bjorend/pertexus/teensy4_1_pin_assignments.xlsx

Sheet: TeensyPinAssignments
Teensy 4.1 I/Os
MIMXRT1062CVJ6B |  |  |  | Schematic | External Pin
Pin | Pinname (Pad) | GPIO Group | Number | Netname | Connector | Pin # | Arduino Pin | Presumed Port | Presumed Mode | My Design | PertecPin | PertecGroup
F1 | GPIO_EMC_22 | 4 | 22 | EMC_22 | FLASH | 1 (CS) | 51 | FLEXSPI2_A_SS1_B | ALT8
 |  |  |  |  | IOExpander | 0 |  |  |  | IDENT | P2:16 | IN4b
 |  |  |  |  | IOExpander | 1 |  |  |  | IRWD | P2:30 | IN4b
 |  |  |  |  | IOExpander | 2 |  |  |  | ISPEED | P2:40 | IN4b
 |  |  |  |  | IOExpander | 3 |  |  |  | INRZ | P2:26 | IN5b
 |  |  |  |  | IOExpander | 4 |  |  |  | ITAD0 | P1:46 | OUT3a
 |  |  |  |  | IOExpander | 5 |  |  |  | IFEN | P2:18 | OUT3a
 |  |  |  |  | IOExpander | 6 |  |  |  | ITAD1 | P2:46 | OUT3a
 |  |  |  |  | IOExpander | 7 |  |  |  | IFAD | P2:48 | OUT3a
 |  |  |  |  | IOExpander | 8 |  |  |  | IDEN | P2:50 | OUT3a
 |  |  |  |  | IOExpander | 9 |  |  |  | ISGL | P1:14 | UDFB
 |  |  |  |  | IOExpander | 10 |  |  |  | ILOL | P1:16 | UDFO
 |  |  |  |  | IOExpander | 11 |  |  |  | IRTH2 | P1:36 | UDFO
 |  |  |  |  | IOExpander | 12 |  |  |  | IRTH1 | P1:44 | UDFO
 |  |  |  |  | IOExpander | 13 |  |  |  | IONL | P2:44 | IN5a
 |  |  |  |  | IOExpander | 14 |  |  |  | ILDP | P2:4 | IN5a
 |  |  |  |  | IOExpander | 15 |  |  |  | IFPT | P2:32 | IN5a
M8 | USB_OTG1_DN |  |  | USB1_DN | J1 (USB) | 2
L8 | USB_OTG1_DP |  |  | USB1_DP | J1 (USB) | 3
H2 | GPIO_SD_B0_04 | 3 | 16 | SD_B0_04 | J2 (SD Card) | 1 (DAT2) | 47 | USDHC1_DATA2 | ALT0
J2 | GPIO_SD_B0_05 | 3 | 17 | SD_B0_05 | J2 (SD Card) | 2 (DAT3) | 46 | USDHC1_DATA3 | ALT0
J4 | GPIO_SD_B0_00 | 3 | 12 | SD_B0_00 | J2 (SD Card) | 3 (CMD) | 45 | USDHC1_CMD | ALT0
J3 | GPIO_SD_B0_01 | 3 | 13 | SD_B0_01 | J2 (SD Card) | 5 (CLK) | 44 | USDHC1_CLK | ALT0
J1 | GPIO_SD_B0_02 | 3 | 14 | SD_B0_02 | J2 (SD Card) | 7 (DAT0) | 43 | USDHC1_DATA0 | ALT0
K1 | GPIO_SD_B0_03 | 3 | 15 | SD_B0_03 | J2 (SD Card) | 8 (DAT1) | 42 | USDHC1_DATA1 | ALT0
 |  |  |  | ETHERNET_T- | J3 (Ethernet header) | 1
 |  |  |  | ETHERNET_T+ | J3 (Ethernet header) | 2
 |  |  |  | ETHERNET_LED | J3 (Ethernet header) | 3
 |  |  |  | ETHERNET_G | J3 (Ethernet header) | 4
 |  |  |  | ETHERNET_R+ | J3 (Ethernet header) | 5
 |  |  |  | ETHERNET_R- | J3 (Ethernet header) | 6
M13 | GPIO_AD_B1_09 | 1 | 25 | AD_B1_09 | J4 | 4 | 23 |  |  | IW6 | P1:28 | OUT1a
H13 | GPIO_AD_B1_08 | 1 | 24 | AD_B1_08 | J4 | 5 | 22 |  |  | IW7 | P1:24 | OUT1a
J13 | GPIO_AD_B1_11 | 1 | 27 | AD_B1_11 | J4 | 6 | 21 |  |  | IW4 | P1:6 | OUT1a
L13 | GPIO_AD_B1_10 | 1 | 26 | AD_B1_10 | J4 | 7 | 20 |  |  | IW5 | P1:32 | OUT1a
J11 | GPIO_AD_B1_00 | 1 | 16 | AD_B1_00 | J4 | 8 | 19 |  |  | IR7 | P2:8 | IN2a
K11 | GPIO_AD_B1_01 | 1 | 17 | AD_B1_01 | J4 | 9 | 18 |  |  | IR6 | P2:10 | IN2a
J12 | GPIO_AD_B1_06 | 1 | 22 | AD_B1_06 | J4 | 10 | 17 |  |  | IR1 | P2:3 | IN2a
K10 | GPIO_AD_B1_07 | 1 | 23 | AD_B1_07 | J4 | 11 | 16 |  |  | IR0 | P2:2 | IN2a
M12 | GPIO_AD_B1_03 | 1 | 19 | AD_B1_03 | J4 | 12 | 15 |  |  | IR4 | P2:6 | IN2a
L11 | GPIO_AD_B1_02 | 1 | 18 | AD_B1_02 | J4 | 13 | 14 |  |  | IR5 | P2:20 | IN2a
D8 | GPIO_B0_03 | 2 | 3 | B0_03 | J4 | 14 | 13 |  |  | ILWD | P1:4 | OUT1a
K12 | GPIO_AD_B1_05 | 1 | 21 | AD_B1_05 | J4 | 16 | 41 |  |  | IR2 | P1:48 | IN2a
L12 | GPIO_AD_B1_04 | 1 | 20 | AD_B1_04 | J4 | 17 | 40 |  |  | IR3 | P1:50 | IN2a
H11 | GPIO_AD_B1_13 | 1 | 29 | AD_B1_13 | J4 | 18 | 39 |  |  | IW2 | P1:30 | OUT1a
H12 | GPIO_AD_B1_12 | 1 | 28 | AD_B1_12 | J4 | 19 | 38 |  |  | IW3 | P1:26 | OUT1a
D11 | GPIO_B1_03 | 2 | 19 | B1_03 | J4 | 20 | 37 |  |  | IWSTR | P2:36 | IN1a
C11 | GPIO_B1_02 | 2 | 18 | B1_02 | J4 | 21 | 36 |  |  | IRSTR | P2:34 | IN1a
D13 | GPIO_B1_12 | 2 | 28 | B1_12 | J4 | 22 | 35 |  |  | IHER | P2:12 | IN2a
D14 | GPIO_B1_13 | 2 | 29 | B1_13 | J4 | 23 | 34 |  |  | ICER | P2:42 | IN2a
H4 | GPIO_EMC_07 | 4 | 7 | EMC_07 | J4 | 24 | 33 |  |  | IFBY | P1:2 | IN3a
G11 | GPIO_AD_B0_03 | 1 | 3 | AD_B0_03 | J5 | 2 | 0 |  |  | IFMK | P2:14 | IN3a
M11 | GPIO_AD_B0_02 | 1 | 2 | AD_B0_02 | J5 | 3 | 1 |  |  | IRP | P2:1 | IN2b
F2 | GPIO_EMC_04 | 4 | 4 | EMC_04 | J5 | 4 | 2 |  |  | IRDY | P2:28 | IN4a
G5 | GPIO_EMC_05 | 4 | 5 | EMC_05 | J5 | 5 | 3 |  |  | DIRA
H5 | GPIO_EMC_06 | 4 | 6 | EMC_06 | J5 | 6 | 4 |  |  | IDBY | P2:38 | IN3a
H3 | GPIO_EMC_08 | 4 | 8 | EMC_08 | J5 | 7 | 5 |  |  | LPI2C4_INT
D9 | GPIO_B0_10 | 2 | 10 | B0_10 | J5 | 8 | 6 |  |  | IGO | P1:8 | OUT2a
B11 | GPIO_B1_01 | 2 | 17 | B1_01 | J5 | 9 | 7 |  |  | IWP | P1:22 | OUT1b
A11 | GPIO_B1_00 | 2 | 16 | B1_00 | J5 | 10 | 8 |  |  | IREW | P1:20 | OUT2a
A10 | GPIO_B0_11 | 2 | 11 | B0_11 | J5 | 11 | 9 |  |  | IREV | P1:18 | OUT2a
D7 | GPIO_B0_00 | 2 | 0 | B0_00 | J5 | 12 | 10 |  |  | IWRT | P1:34 | OUT2a
E8 | GPIO_B0_02 | 2 | 2 | B0_02 | J5 | 13 | 11 |  |  | IEDIT | P1:38 | OUT2a
E7 | GPIO_B0_01 | 2 | 1 | B0_01 | J5 | 14 | 12 |  |  | IERASE | P1:40 | OUT2a
K14 | GPIO_AD_B0_12 | 1 | 12 | AD_B0_12 | J5 | 16 | 24 |  |  | LPI2C4_SCL
L14 | GPIO_AD_B0_13 | 1 | 13 | AD_B0_13 | J5 | 17 | 25 |  |  | LPI2C4_SDA
G12 | GPIO_AD_B1_14 | 1 | 30 | AD_B1_14 | J5 | 18 | 26 |  |  | IW1 | P1:12 | OUT1a
J14 | GPIO_AD_B1_15 | 1 | 31 | AD_B1_15 | J5 | 19 | 27 |  |  | IW0 | P1:10 | OUT1a
D5 | GPIO_EMC_32 | 3 | 18 | EMC_32 | J5 | 20 | 28 |  |  | DIRB
C5 | GPIO_EMC_31 | 4 | 31 | EMC_31 | J5 | 21 | 29 |  |  | OEA
E4 | GPIO_EMC_37 | 3 | 23 | EMC_37 | J5 | 22 | 30 |  |  | IOFL | P2:24 | OUT2a
C3 | GPIO_EMC_36 | 3 | 22 | EMC_36 | J5 | 23 | 31 |  |  | IEOT | P2:22 | IN3a
C10 | GPIO_B0_12 | 2 | 12 | B0_12 | J5 | 24 | 32 |  |  | IWFM | P1:42 | OUT2a
D3 | GPIO_EMC_24 | 4 | 24 | EMC_24 | PSRAM | 1 (CS) | 48 | FLEXSPI2_A_SS0_B | ALT8
A2 | GPIO_EMC_27 | 4 | 27 | EMC_27 | PSRAM/FLASH | 2 (D1) | 49 | FLEXSPI2_A_DATA1 | ALT8
D1 | GPIO_EMC_28 | 4 | 28 | EMC_28 | PSRAM/FLASH | 3 (D2) | 50 | FLEXSPI2_A_DATA2 | ALT8
B3 | GPIO_EMC_26 | 4 | 26 | EMC_26 | PSRAM/FLASH | 5 (D0) | 52 | FLEXSPI2_A_DATA0 | ALT8
D2 | GPIO_EMC_25 | 4 | 25 | EMC_25 | PSRAM/FLASH | 6 (CLK) | 53 | FLEXSPI2_A_SCLK | ALT8
E1 | GPIO_EMC_29 | 4 | 29 | EMC_29 | PSRAM/FLASH | 7 (D3) | 54 | FLEXSPI2_A_DATA3 | ALT8
D10 | GPIO_B0_13 | 2 | 13 | B0_13 | U2 (Boot) | 12 (PTB4)
F13 | GPIO_AD_B0_08 |  |  | AD_B0_08 | U2 (Boot) | 13 (PTB5) |  | JTAG_MOD | ALT0
F3 | GPIO_EMC_01 | 4 | 1 | EMC_01 | U2 (Boot) | 15 (PTA1) |  | JTAG_DE_B | ALT7
K3 | DCDC_PSWITCH |  |  | DCDC_PSWITCH | U2 (Boot) | 3 (PTA3)
G10 | GPIO_AD_B0_11 |  |  | AD_B0_11 | U2 (Boot) | 3 (PTA3) |  | JTAG_TRSTB | ALT0
F11 | GPIO_AD_B0_04 |  |  | AD_B0_04 | U2 (Boot) | 4 (PTA4) |  | SRC_BOOT_MODE0 | ALT0
E14 | GPIO_AD_B0_06 |  |  | AD_B0_06 | U2 (Boot) | 5 (PTA5 |  | JTAG_TMS | ALT0
G13 | GPIO_AD_B0_10 |  |  | AD_B0_10 | U2 (Boot) | 6 (PTA6) |  | JTAG_TDO | ALT0
F14 | GPIO_AD_B0_09 |  |  | AD_B0_09 | U2 (Boot) | 7 (PTA7) |  | JTAG_TDI | ALT0
F12 | GPIO_AD_B0_07 |  |  | AD_B0_07 | U2 (Boot) | 8 (PTB0) |  | JTAG_TCK | ALT0
M7 | POR_B |  |  | POR_B | U2 (Boot) | 9 (PTB1) |  | SRC_POR_B | ALT0
L3 | GPIO_SD_B1_06 | 3 | 6 | SD_B1_06 | U3 (SPI Flash) | 1 (CS) |  | FLEXSPI_A_SS0_B | ALT1
N4 | GPIO_SD_B1_09 | 3 | 9 | SD_B1_09 | U3 (SPI Flash) | 2 (D1) |  | FLEXSPI_A_DATA1 | ALT1
P4 | GPIO_SD_B1_10 | 3 | 1 | SD_B1_10 | U3 (SPI Flash) | 3 (D2) |  | FLEXSPI_A_DATA2 | ALT1
P3 | GPIO_SD_B1_08 | 3 | 8 | SD_B1_08 | U3 (SPI Flash) | 5 (D0) |  | FLEXSPI_A_DATA0 | ALT1
L4 | GPIO_SD_B1_07 | 3 | 7 | SD_B1_07 | U3 (SPI Flash) | 6 (CLK) |  | FLEXSPI_A_SCLK | ALT1
P5 | GPIO_SD_B1_11 | 3 | 11 | SD_B1_11 | U3 (SPI Flash) | 7 (D3) |  | FLEXSPI_A_DATA3 | ALT1
A13 | GPIO_B1_09 | 2 | 25 | B1_09 | U6 (Ethernet PHY) | 1 (TXEN) |  | ENET_TX_EN | ALT3
B13 | GPIO_B1_10 | 2 | 26 | B1_10 | U6 (Ethernet PHY) | 13 (XI) |  | ENET_TX_CLK | ALT3
B14 | GPIO_B1_15 | 2 | 31 | B1_15 | U6 (Ethernet PHY) | 15 (MDIO) |  | ENET_MDIO | ALT0
C14 | GPIO_B1_14 | 2 | 30 | B1_14 | U6 (Ethernet PHY) | 16 (MDC) |  | ENET_MDC | ALT0
D12 | GPIO_B1_05 | 2 | 21 | B1_05 | U6 (Ethernet PHY) | 17 (RXD1) |  | ENET_RX_DATA1 | ALT3
E12 | GPIO_B1_04 | 2 | 20 | B1_04 | U6 (Ethernet PHY) | 18 (RXD0) |  | ENET_RX_DATA0 | ALT3
C12 | GPIO_B1_06 | 2 | 22 | B1_06 | U6 (Ethernet PHY) | 20 (DV) |  | ENET_RX_EN | ALT3
C13 | GPIO_B1_11 | 2 | 27 | B1_11 | U6 (Ethernet PHY) | 22 (RXER) |  | ENET_RX_ER | ALT3
B12 | GPIO_B1_07 | 2 | 23 | B1_07 | U6 (Ethernet PHY) | 23 (TXD0) |  | ENET_TX_DATA0 | ALT3
A12 | GPIO_B1_08 | 2 | 24 | B1_08 | U6 (Ethernet PHY) | 24 (TXD1) |  | ENET_TX_DATA1 | ALT3
E11 | GPIO_B0_15 | 2 | 15 | B0_15 | U6 (Ethernet PHY) | 3 (INT)
E10 | GPIO_B0_14 | 2 | 14 | B0_14 | U6 (Ethernet PHY) | 5 (RST)
M14 | GPIO_AD_B0_00 | 1 | 0 | AD_B0_00
A7 | GPIO_EMC_40 | 3 | 26 | EMC_40
N1 | DCDC_GND |  |  | DCDC_GND
N2 | DCDC_GND |  |  | DCDC_GND
L1 | DCDC_IN |  |  | DCDC_IN
L2 | DCDC_IN |  |  | DCDC_IN
K4 | DCDC_IN_Q |  |  | NVCC_GPIO
M1 | DCDC_LP |  |  | DCDC_LP
M2 | DCDC_LP |  |  | DCDC_LP
J5 | DCDC_SENSE |  |  | VDD_SOC_IN
G14 | GPIO_AD_B0_05 |  |  | AD_B0_05
K9 | NGND_KEL0 |  |  | NGND_KEL0
E6 | NVCC_EMC |  |  | NVCC_GPIO
F5 | NVCC_EMC |  |  | NVCC_GPIO
E9 | NVCC_GPIO |  |  | NVCC_GPIO
F10 | NVCC_GPIO |  |  | NVCC_GPIO
J10 | NVCC_GPIO |  |  | NVCC_GPIO
P10 | NVCC_PLL |  |  | NVCC_PLL
J6 | NVCC_SD0 |  |  | NVCC_GPIO
K5 | NVCC_SD1 |  |  | NVCC_GPIO
M6 | ONOFF |  |  | ONOFF
K7 | PMIC_ON_REQ |  |  | PMIC_ON_REQ
N9 | RTC_XTALI |  |  | RTC_XTALI
P9 | RTC_XTALO |  |  | RTC_XTALO
N6 | USB_OTG1_VBUS |  |  | USB1_VBUS
N7 | USB_OTG2_DN |  |  | USB2_DN
P7 | USB_OTG2_DP |  |  | USB2_DP
P6 | USB_OTG2_VBUS |  |  | USB2_VBUS
P8 | VDD_HIGH_CAP |  |  | VDD_HIGH_CAP
P12 | VDD_HIGH_IN |  |  | VDD_HIGH_IN
M10 | VDD_SNVS_CAP |  |  | VDD_SNVS_CAP
M9 | VDD_SNVS_IN |  |  | VDD_SNVS_IN
F6 | VDD_SOC_IN |  |  | VDD_SOC_IN
F7 | VDD_SOC_IN |  |  | VDD_SOC_IN
F8 | VDD_SOC_IN |  |  | VDD_SOC_IN
F9 | VDD_SOC_IN |  |  | VDD_SOC_IN
G6 | VDD_SOC_IN |  |  | VDD_SOC_IN
G9 | VDD_SOC_IN |  |  | VDD_SOC_IN
H6 | VDD_SOC_IN |  |  | VDD_SOC_IN
H9 | VDD_SOC_IN |  |  | VDD_SOC_IN
J9 | VDD_SOC_IN |  |  | VDD_SOC_IN
K8 | VDD_USB_CAP |  |  | VCC_USB_CAP
N14 | VDDA_ADC_3P3 |  |  | VDD_ADC
A1 | VSS |  |  | VSS
A14 | VSS |  |  | VSS
B10 | VSS |  |  | VSS
B5 | VSS |  |  | VSS
E13 | VSS |  |  | VSS
E2 | VSS |  |  | VSS
G7 | VSS |  |  | VSS
G8 | VSS |  |  | VSS
H7 | VSS |  |  | VSS
H8 | VSS |  |  | VSS
J7 | VSS |  |  | VSS
J8 | VSS |  |  | VSS
K13 | VSS |  |  | VSS
K2 | VSS |  |  | VSS
L9 | VSS |  |  | VSS
N5 | VSS |  |  | VSS
N8 | VSS |  |  | VSS
P1 | VSS |  |  | VSS
P14 | VSS |  |  | VSS
P11 | XTALI |  |  | XTALI
N11 | XTALO |  |  | XTALO

Sheet: CPUPinAssignments
IMXRT1060 pin assignments
from i.MX RT1060 Crossover Processors for Consumer Products
NXP Semiconductors Data Sheet: Technical Data
Document Number: IMXRT1060CEC, Rev. 0.1, 04.2019
https://www.pjrc.com/teensy/IMXRT1060CEC_rev0_1.pdf
pp. 100-107, section 6.2.2 "12 x 12 mm supplies contact assignments and functional contact assignments", table 86 "12 x 12 mm supplies contact assignment" |  |  |  |  |  |  |  |  |  | B11 | GPIO_B1_01
 |  |  |  | Default Setting |  |  |  | GPIO
Ball Name | 12 x 12 Ball | Power Group | Ball Type | Default Mode | Default Function | Input/Output | Value | Group | Number
CCM_CLK1_N | P13 | — | — | — | CCM_CLK1_N | — | —
CCM_CLK1_P | N13 | — | — | — | CCM_CLK1_P | — | —
DCDC_GND | N1 | — | — | — | — | — | —
DCDC_GND | N2 | — | — | — | — | — | —
DCDC_IN | L1 | — | — | — | — | — | —
DCDC_IN | L2 | — | — | — | — | — | —
DCDC_IN_Q | K4 | — | — | — | — | — | —
DCDC_LP | M1 | — | — | — | — | — | —
DCDC_LP | M2 | — | — | — | — | — | —
DCDC_PSWITCH | K3 | — | — | — | — | — | —
DCDC_SENSE | J5 | — | — | — | — | — | —
GPANAIO | N10 | — | — | — | — | — | —
GPIO_AD_B0_00 | M14 | NVCC_GPIO | Digital GPIO | ALT5 | GPIO1.IO[0] | Input | Keeper | 1 | 0
GPIO_AD_B0_01 | H10 | NVCC_GPIO | Digital GPIO | ALT5 | GPIO1.IO[1] | Input | Keeper | 1 | 1
GPIO_AD_B0_02 | M11 | NVCC_GPIO | Digital GPIO | ALT5 | GPIO1.IO[2] | Input | Keeper | 1 | 2
GPIO_AD_B0_03 | G11 | NVCC_GPIO | Digital GPIO | ALT5 | GPIO1.IO[3] | Input | Keeper | 1 | 3
GPIO_AD_B0_04 | F11 | NVCC_GPIO | Digital GPIO | ALT0 | SRC.BOOT.MODE[0] | Input | 100 K PD
GPIO_AD_B0_05 | G14 | NVCC_GPIO | Digital GPIO | ALT0 | SRC.BOOT.MODE[1] | Input | 100 K PD
GPIO_AD_B0_06 | E14 | NVCC_GPIO | Digital GPIO | ALT0 | JTAG.MUX.TMS | Input | 47 K PU
GPIO_AD_B0_07 | F12 | NVCC_GPIO | Digital GPIO | ALT0 | JTAG.MUX.TCK | Input | 47 K PU
GPIO_AD_B0_08 | F13 | NVCC_GPIO | Digital GPIO | ALT0 | JTAG.MUX.MOD | Input | 100 K PU
GPIO_AD_B0_09 | F14 | NVCC_GPIO | Digital GPIO | ALT0 | JTAG.MUX.TDI | Input | 47 K PU
GPIO_AD_B0_10 | G13 | NVCC_GPIO | Digital GPIO | ALT0 | JTAG.MUX.TDO | Input | Keeper
GPIO_AD_B0_11 | G10 | NVCC_GPIO | Digital GPIO | ALT0 | JTAG.MUX.TRSTB | Input | 47 K PU
GPIO_AD_B0_12 | K14 | NVCC_GPIO | Digital GPIO | ALT5 | GPIO1.IO[12] | Input | Keeper | 1 | 12
GPIO_AD_B0_13 | L14 | NVCC_GPIO | Digital GPIO | ALT5 | GPIO1.IO[13] | Input | Keeper | 1 | 13
GPIO_AD_B0_14 | H14 | NVCC_GPIO | Digital GPIO | ALT5 | GPIO1.IO[14] | Input | Keeper | 1 | 14
GPIO_AD_B0_15 | L10 | NVCC_GPIO | Digital GPIO | ALT5 | GPIO1.IO[15] | Input | Keeper | 1 | 15
GPIO_AD_B1_00 | J11 | NVCC_GPIO | Digital GPIO | ALT5 | GPIO1.IO[16] | Input | Keeper | 1 | 16
GPIO_AD_B1_01 | K11 | NVCC_GPIO | Digital GPIO | ALT5 | GPIO1.IO[17] | Input | Keeper | 1 | 17
GPIO_AD_B1_02 | L11 | NVCC_GPIO | Digital GPIO | ALT5 | GPIO1.IO[18] | Input | Keeper | 1 | 18
GPIO_AD_B1_03 | M12 | NVCC_GPIO | Digital GPIO | ALT5 | GPIO1.IO[19] | Input | Keeper | 1 | 19
GPIO_AD_B1_04 | L12 | NVCC_GPIO | Digital GPIO | ALT5 | GPIO1.IO[20] | Input | Keeper | 1 | 20
GPIO_AD_B1_05 | K12 | NVCC_GPIO | DigitalGPIO | ALT5 | GPIO1.IO[21] | Input | Keeper | 1 | 21
GPIO_AD_B1_06 | J12 | NVCC_GPIO | DigitalGPIO | ALT5 | GPIO1.IO[22] | Input | Keeper | 1 | 22
GPIO_AD_B1_07 | K10 | NVCC_GPIO | DigitalGPIO | ALT5 | GPIO1.IO[23] | Input | Keeper | 1 | 23
GPIO_AD_B1_08 | H13 | NVCC_GPIO | DigitalGPIO | ALT5 | GPIO1.IO[24] | Input | Keeper | 1 | 24
GPIO_AD_B1_09 | M13 | NVCC_GPIO | DigitalGPIO | ALT5 | GPIO1.IO[25] | Input | Keeper | 1 | 25
GPIO_AD_B1_10 | L13 | NVCC_GPIO | DigitalGPIO | ALT5 | GPIO1.IO[26] | Input | Keeper | 1 | 26
GPIO_AD_B1_11 | J13 | NVCC_GPIO | DigitalGPIO | ALT5 | GPIO1.IO[27] | Input | Keeper | 1 | 27
GPIO_AD_B1_12 | H12 | NVCC_GPIO | DigitalGPIO | ALT5 | GPIO1.IO[28] | Input | Keeper | 1 | 28
GPIO_AD_B1_13 | H11 | NVCC_GPIO | DigitalGPIO | ALT5 | GPIO1.IO[29] | Input | Keeper | 1 | 29
GPIO_AD_B1_14 | G12 | NVCC_GPIO | DigitalGPIO | ALT5 | GPIO1.IO[30] | Input | Keeper | 1 | 30
GPIO_AD_B1_15 | J14 | NVCC_GPIO | DigitalGPIO | ALT5 | GPIO1.IO[31] | Input | Keeper | 1 | 31
GPIO_B0_00 | D7 | NVCC_GPIO | DigitalGPIO | ALT5 | GPIO2.IO[0] | Input | Keeper | 2 | 0
GPIO_B0_01 | E7 | NVCC_GPIO | DigitalGPIO | ALT5 | GPIO2.IO[1] | Input | Keeper | 2 | 1
GPIO_B0_02 | E8 | NVCC_GPIO | DigitalGPIO | ALT5 | GPIO2.IO[2] | Input | Keeper | 2 | 2
GPIO_B0_03 | D8 | NVCC_GPIO | DigitalGPIO | ALT5 | GPIO2.IO[3] | Input | Keeper | 2 | 3
GPIO_B0_04 | C8 | NVCC_GPIO | DigitalGPIO | ALT5 | GPIO2.IO[4] | Input | Keeper | 2 | 4
GPIO_B0_05 | B8 | NVCC_GPIO | DigitalGPIO | ALT5 | GPIO2.IO[5] | Input | Keeper | 2 | 5
GPIO_B0_06 | A8 | NVCC_GPIO | DigitalGPIO | ALT5 | GPIO2.IO[6] | Input | Keeper | 2 | 6
GPIO_B0_07 | A9 | NVCC_GPIO | DigitalGPIO | ALT5 | GPIO2.IO[7] | Input | Keeper | 2 | 7
GPIO_B0_08 | B9 | NVCC_GPIO | DigitalGPIO | ALT5 | GPIO2.IO[8] | Input | Keeper | 2 | 8
GPIO_B0_09 | C9 | NVCC_GPIO | DigitalGPIO | ALT5 | GPIO2.IO[9] | Input | Keeper | 2 | 9
GPIO_B0_10 | D9 | NVCC_GPIO | Digital GPIO | ALT5 | GPIO2.IO[10] | Input | Keeper | 2 | 10
GPIO_B0_11 | A10 | NVCC_GPIO | Digital GPIO | ALT5 | GPIO2.IO[11] | Input | Keeper | 2 | 11
GPIO_B0_12 | C10 | NVCC_GPIO | Digital GPIO | ALT5 | GPIO2.IO[12] | Input | Keeper | 2 | 12
GPIO_B0_13 | D10 | NVCC_GPIO | Digital GPIO | ALT5 | GPIO2.IO[13] | Input | Keeper | 2 | 13
GPIO_B0_14 | E10 | NVCC_GPIO | Digital GPIO | ALT5 | GPIO2.IO[14] | Input | Keeper | 2 | 14
GPIO_B0_15 | E11 | NVCC_GPIO | Digital GPIO | ALT5 | GPIO2.IO[15] | Input | Keeper | 2 | 15
GPIO_B1_00 | A11 | NVCC_GPIO | Digital GPIO | ALT5 | GPIO2.IO[16] | Input | Keeper | 2 | 16
GPIO_B1_01 | B11 | NVCC_GPIO | Digital GPIO | ALT5 | GPIO2.IO[17] | Input | Keeper | 2 | 17
GPIO_B1_02 | C11 | NVCC_GPIO | Digital GPIO | ALT5 | GPIO2.IO[18] | Input | Keeper | 2 | 18
GPIO_B1_03 | D11 | NVCC_GPIO | Digital GPIO | ALT5 | GPIO2.IO[19] | Input | Keeper | 2 | 19
GPIO_B1_04 | E12 | NVCC_GPIO | Digital GPIO | ALT5 | GPIO2.IO[20] | Input | Keeper | 2 | 20
GPIO_B1_05 | D12 | NVCC_GPIO | Digital GPIO | ALT5 | GPIO2.IO[21] | Input | Keeper | 2 | 21
GPIO_B1_06 | C12 | NVCC_GPIO | Digital GPIO | ALT5 | GPIO2.IO[22] | Input | Keeper | 2 | 22
GPIO_B1_07 | B12 | NVCC_GPIO | Digital GPIO | ALT5 | GPIO2.IO[23] | Input | Keeper | 2 | 23
GPIO_B1_08 | A12 | NVCC_GPIO | Digital GPIO | ALT5 | GPIO2.IO[24] | Input | Keeper | 2 | 24
GPIO_B1_09 | A13 | NVCC_GPIO | Digital GPIO | ALT5 | GPIO2.IO[25] | Input | Keeper | 2 | 25
GPIO_B1_10 | B13 | NVCC_GPIO | Digital GPIO | ALT5 | GPIO2.IO[26] | Input | Keeper | 2 | 26
GPIO_B1_11 | C13 | NVCC_GPIO | Digital GPIO | ALT5 | GPIO2.IO[27] | Input | Keeper | 2 | 27
GPIO_B1_12 | D13 | NVCC_GPIO | Digital GPIO | ALT5 | GPIO2.IO[28] | Input | Keeper | 2 | 28
GPIO_B1_13 | D14 | NVCC_GPIO | Digital GPIO | ALT5 | GPIO2.IO[29] | Input | Keeper | 2 | 29
GPIO_B1_14 | C14 | NVCC_GPIO | Digital GPIO | ALT5 | GPIO2.IO[30] | Input | Keeper | 2 | 30
GPIO_B1_15 | B14 | NVCC_GPIO | Digital GPIO | ALT5 | GPIO2.IO[31] | Input | Keeper | 2 | 31
GPIO_EMC_00 | E3 | NVCC_EMC | Digital GPIO | ALT5 | GPIO4.IO[0] | Input | Keeper | 4 | 0
GPIO_EMC_01 | F3 | NVCC_EMC | Digital GPIO | ALT5 | GPIO4.IO[1] | Input | Keeper | 4 | 1
GPIO_EMC_02 | F4 | NVCC_EMC | Digital GPIO | ALT5 | GPIO4.IO[2] | Input | Keeper | 4 | 2
GPIO_EMC_03 | G4 | NVCC_EMC | Digital GPIO | ALT5 | GPIO4.IO[3] | Input | Keeper | 4 | 3
GPIO_EMC_04 | F2 | NVCC_EMC | Digital GPIO | ALT5 | GPIO4.IO[4] | Input | Keeper | 4 | 4
GPIO_EMC_05 | G5 | NVCC_EMC | Digital GPIO | ALT5 | GPIO4.IO[5] | Input | Keeper | 4 | 5
GPIO_EMC_06 | H5 | NVCC_EMC | Digital GPIO | ALT5 | GPIO4.IO[6] | Input | Keeper | 4 | 6
GPIO_EMC_07 | H4 | NVCC_EMC | Digital GPIO | ALT5 | GPIO4.IO[7] | Input | Keeper | 4 | 7
GPIO_EMC_08 | H3 | NVCC_EMC | Digital GPIO | ALT5 | GPIO4.IO[8] | Input | Keeper | 4 | 8
GPIO_EMC_09 | C2 | NVCC_EMC | Digital GPIO | ALT5 | GPIO4.IO[9] | Input | Keeper | 4 | 9
GPIO_EMC_10 | G1 | NVCC_EMC | Digital GPIO | ALT5 | GPIO4.IO[10] | Input | Keeper | 4 | 10
GPIO_EMC_11 | G3 | NVCC_EMC | Digital GPIO | ALT5 | GPIO4.IO[11] | Input | Keeper | 4 | 11
GPIO_EMC_12 | H1 | NVCC_EMC | Digital GPIO | ALT5 | GPIO4.IO[12] | Input | Keeper | 4 | 12
GPIO_EMC_13 | A6 | NVCC_EMC | Digital GPIO | ALT5 | GPIO4.IO[13] | Input | Keeper | 4 | 13
GPIO_EMC_14 | B6 | NVCC_EMC | Digital GPIO | ALT5 | GPIO4.IO[14] | Input | Keeper | 4 | 14
GPIO_EMC_15 | B1 | NVCC_EMC | Digital GPIO | ALT5 | GPIO4.IO[15] | Input | Keeper | 4 | 15
GPIO_EMC_16 | A5 | NVCC_EMC | Digital GPIO | ALT5 | GPIO4.IO[16] | Input | Keeper | 4 | 16
GPIO_EMC_17 | A4 | NVCC_EMC | Digital GPIO | ALT5 | GPIO4.IO[17] | Input | Keeper | 4 | 17
GPIO_EMC_18 | B2 | NVCC_EMC | Digital GPIO | ALT5 | GPIO4.IO[18] | Input | Keeper | 4 | 18
GPIO_EMC_19 | B4 | NVCC_EMC | Digital GPIO | ALT5 | GPIO4.IO[19] | Input | Keeper | 4 | 19
GPIO_EMC_20 | A3 | NVCC_EMC | Digital GPIO | ALT5 | GPIO4.IO[20] | Input | Keeper | 4 | 20
GPIO_EMC_21 | C1 | NVCC_EMC | Digital GPIO | ALT5 | GPIO4.IO[21] | Input | Keeper | 4 | 21
GPIO_EMC_22 | F1 | NVCC_EMC | Digital GPIO | ALT5 | GPIO4.IO[22] | Input | Keeper | 4 | 22
GPIO_EMC_23 | G2 | NVCC_EMC | Digital GPIO | ALT5 | GPIO4.IO[23] | Input | Keeper | 4 | 23
GPIO_EMC_24 | D3 | NVCC_EMC | Digital GPIO | ALT5 | GPIO4.IO[24] | Input | Keeper | 4 | 24
GPIO_EMC_25 | D2 | NVCC_EMC | Digital GPIO | ALT5 | GPIO4.IO[25] | Input | Keeper | 4 | 25
GPIO_EMC_26 | B3 | NVCC_EMC | Digital GPIO | ALT5 | GPIO4.IO[26] | Input | Keeper | 4 | 26
GPIO_EMC_27 | A2 | NVCC_EMC | Digital GPIO | ALT5 | GPIO4.IO[27] | Input | 100 K PD | 4 | 27
GPIO_EMC_28 | D1 | NVCC_EMC | Digital GPIO | ALT5 | GPIO4.IO[28] | Input | Keeper | 4 | 28
GPIO_EMC_29 | E1 | NVCC_EMC | Digital GPIO | ALT5 | GPIO4.IO[29] | Input | Keeper | 4 | 29
GPIO_EMC_30 | C6 | NVCC_EMC | Digital GPIO | ALT5 | GPIO4.IO[30] | Input | Keeper | 4 | 30
GPIO_EMC_31 | C5 | NVCC_EMC | Digital GPIO | ALT5 | GPIO4.IO[31] | Input | Keeper | 4 | 31
GPIO_EMC_32 | D5 | NVCC_EMC | Digital GPIO | ALT5 | GPIO3.IO[18] | Input | Keeper | 3 | 18
GPIO_EMC_33 | C4 | NVCC_EMC | Digital GPIO | ALT5 | GPIO3.IO[19] | Input | Keeper | 3 | 19
GPIO_EMC_34 | D4 | NVCC_EMC | Digital GPIO | ALT5 | GPIO3.IO[20] | Input | Keeper | 3 | 20
GPIO_EMC_35 | E5 | NVCC_EMC | Digital GPIO | ALT5 | GPIO3.IO[21] | Input | Keeper | 3 | 21
GPIO_EMC_36 | C3 | NVCC_EMC | Digital GPIO | ALT5 | GPIO3.IO[22] | Input | Keeper | 3 | 22
GPIO_EMC_37 | E4 | NVCC_EMC | Digital GPIO | ALT5 | GPIO3.IO[23] | Input | Keeper | 3 | 23
GPIO_EMC_38 | D6 | NVCC_EMC | Digital GPIO | ALT5 | GPIO3.IO[24] | Input | Keeper | 3 | 24
GPIO_EMC_39 | B7 | NVCC_EMC | Digital GPIO | ALT5 | GPIO3.IO[25] | Input | Keeper | 3 | 25
GPIO_EMC_40 | A7 | NVCC_EMC | Digital GPIO | ALT5 | GPIO3.IO[26] | Input | Keeper | 3 | 26
GPIO_EMC_41 | C7 | NVCC_EMC | Digital GPIO | ALT5 | GPIO3.IO[27] | Input | Keeper | 3 | 27
GPIO_SD_B0_00 | J4 | NVCC_SD0 | Digital GPIO | ALT5 | GPIO3.IO[12] | Input | Keeper | 3 | 12
GPIO_SD_B0_01 | J3 | NVCC_SD0 | Digital GPIO | ALT5 | GPIO3.IO[13] | Input | Keeper | 3 | 13
GPIO_SD_B0_02 | J1 | NVCC_SD0 | Digital GPIO | ALT5 | GPIO3.IO[14] | Input | Keeper | 3 | 14
GPIO_SD_B0_03 | K1 | NVCC_SD0 | Digital GPIO | ALT5 | GPIO3.IO[15] | Input | Keeper | 3 | 15
GPIO_SD_B0_04 | H2 | NVCC_SD0 | Digital GPIO | ALT5 | GPIO3.IO[16] | Input | Keeper | 3 | 16
GPIO_SD_B0_05 | J2 | NVCC_SD0 | Digital GPIO | ALT5 | GPIO3.IO[17] | Input | Keeper | 3 | 17
GPIO_SD_B1_00 | L5 | NVCC_SD1 | Digital GPIO | ALT5 | GPIO3.IO[0] | Input | Keeper | 3 | 0
GPIO_SD_B1_01 | M5 | NVCC_SD1 | Digital GPIO | ALT5 | GPIO3.IO[1] | Input | Keeper | 3 | 1
GPIO_SD_B1_02 | M3 | NVCC_SD1 | Digital GPIO | ALT5 | GPIO3.IO[2] | Input | Keeper | 3 | 2
GPIO_SD_B1_03 | M4 | NVCC_SD1 | Digital GPIO | ALT5 | GPIO3.IO[3] | Input | Keeper | 3 | 3
GPIO_SD_B1_04 | P2 | NVCC_SD1 | Digital GPIO | ALT5 | GPIO3.IO[4] | Input | Keeper | 3 | 4
GPIO_SD_B1_05 | N3 | NVCC_SD1 | Digital GPIO | ALT5 | GPIO3.IO[5] | Input | Keeper | 3 | 5
GPIO_SD_B1_06 | L3 | NVCC_SD1 | Digital GPIO | ALT5 | GPIO3.IO[6] | Input | Keeper | 3 | 6
GPIO_SD_B1_07 | L4 | NVCC_SD1 | Digital GPIO | ALT5 | GPIO3.IO[7] | Input | Keeper | 3 | 7
GPIO_SD_B1_08 | P3 | NVCC_SD1 | Digital GPIO | ALT5 | GPIO3.IO[8] | Input | Keeper | 3 | 8
GPIO_SD_B1_09 | N4 | NVCC_SD1 | Digital GPIO | ALT5 | GPIO3.IO[9] | Input | Keeper | 3 | 9
GPIO_SD_B1_10 | P4 | NVCC_SD1 | Digital GPIO | ALT5 | GPIO3.IO[01] | Input | Keeper | 3 | 1
GPIO_SD_B1_11 | P5 | NVCC_SD1 | Digital GPIO | ALT5 | GPIO3.IO[11] | Input | Keeper | 3 | 11
NGND_KEL0 | K9 | — | — | — | — | — | —
NVCC_EMC | E6 | — | — | — | — | — | —
NVCC_EMC | F5 | — | — | — | — | — | —
NVCC_GPIO | E9 | — | — | — | — | — | —
NVCC_GPIO | F10 | — | — | — | — | — | —
NVCC_GPIO | J10 | — | — | — | — | — | —
NVCC_PLL | P10 | — | — | — | — | — | —
NVCC_SD0 | J6 | — | — | — | — | — | —
NVCC_SD1 | K5 | — | — | — | — | — | —
ONOFF | M6 | VDD_SNVS_IN | Digital GPIO | ALT0 | ONOFF | Input | 100 K PU
PMIC_ON_REQ | K7 | VDD_SNVS_IN | Digital GPIO | ALT0 | SNVS_LP.PMIC_ON_REQ | Output | 100 K PU
PMIC_STBY_REQ | L7 | VDD_SNVS_IN | Digital GPIO | ALT0 | CCM.PMIC_VSTBY_REQ | Output | 100 K PU (PKE disabled)
POR_B | M7 | VDD_SNVS_IN | Digital GPIO | ALT0 | SRC.POR_B | Input | 100 K PU
RTC_XTALI | N9 | — | — | — | — | — | —
RTC_XTALO | P9 | — | — | — | — | — | —
TEST_MODE | K6 | VDD_SNVS_IN | Digital GPIO | ALT0 | TCU.TEST_MODE | Input | 100 K PU
USB_OTG1_CHD_B | N12 | — | — | — | — | — | —
USB_OTG1_DN | M8 | — | — | — | — | — | —
USB_OTG1_DP | L8 | — | — | — | — | — | —
USB_OTG1_VBUS | N6 | — | — | — | — | — | —
USB_OTG2_DN | N7 | — | — | — | — | — | —
USB_OTG2_DP | P7 | — | — | — | — | — | —
USB_OTG2_VBUS | P6 | — | — | — | — | — | —
VDD_HIGH_CAP | P8 | — | — | — | — | — | —
VDD_HIGH_IN | P12 | — | — | — | — | — | —
VDD_SNVS_CAP | M10 | — | — | — | — | — | —
VDD_SNVS_IN | M9 | — | — | — | — | — | —
VDD_SOC_IN | F6 | — | — | — | — | — | —
VDD_SOC_IN | F7 | — | — | — | — | — | —
VDD_SOC_IN | F8 | — | — | — | — | — | —
VDD_SOC_IN | F9 | — | — | — | — | — | —
VDD_SOC_IN | G6 | — | — | — | — | — | —
VDD_SOC_IN | G9 | — | — | — | — | — | —
VDD_SOC_IN | H6 | — | — | — | — | — | —
VDD_SOC_IN | H9 | — | — | — | — | — | —
VDD_SOC_IN | J9 | — | — | — | — | — | —
VDD_USB_CAP | K8 | — | — | — | — | — | —
VDDA_ADC_3P3 | N14 | — | — | — | — | — | —
VSS | A1 | — | — | — | — | — | —
VSS | A14 | — | — | — | — | — | —
VSS | B10 | — | — | — | — | — | —
VSS | B5 | — | — | — | — | — | —
VSS | E13 | — | — | — | — | — | —
VSS | E2 | — | — | — | — | — | —
VSS | G7 | — | — | — | — | — | —
VSS | G8 | — | — | — | — | — | —
VSS | H7 | — | — | — | — | — | —
VSS | H8 | — | — | — | — | — | —
VSS | J7 | — | — | — | — | — | —
VSS | J8 | — | — | — | — | — | —
VSS | K13 | — | — | — | — | — | —
VSS | K2 | — | — | — | — | — | —
VSS | L9 | — | — | — | — | — | —
VSS | N5 | — | — | — | — | — | —
VSS | N8 | — | — | — | — | — | —
VSS | P1 | — | — | — | — | — | —
VSS | P14 | — | — | — | — | — | —
WAKEUP | L6 | VDD_SNVS_IN | Digital GPIO | ALT5 | GPIO5.IO[0] | Input | 100 K PU | 5 | 0
XTALI | P11 | — | — | — | — | — | —
XTALO | N11 | — | — | — | — | — | —

Sheet: PertecSignals
Pertec Signals |  |  |  | Counts | Assigned | 52
 |  |  |  |  | Not assigned | 0 |  |  |  |  | C:\downloads\bitsavers.org\bitsavers.org\pdf\kennedy\96xx\93-09610-102_9610_Operation_Nov92.pdf
 |  |  |  |  |  |  |  | Qualstar 1052 |  |  | Kennedy 9610
Signal Name | Definition | Controller In/Out | Group | Con | Pin | Assigned? | Pinname | Present? | Output Enable | Local Name | Present | Name | Direction
IFBY | Formatter Busy | In | IN3a | P1 | 2 | J4:24 | GPIO_EMC_07 | Yes | nONLSEL |  | Yes
IR2 | Read Data, Channel 2 | In | IN2a | P1 | 48 | J4:16 | GPIO_AD_B1_05 | Yes | nONLSEL |  | Yes
IR3 | Read Data, Channel 3 | In | IN2a | P1 | 50 | J4:17 | GPIO_AD_B1_04 | Yes | nONLSEL |  | Yes
IRP | Read Data, Parity | In | IN2b | P2 | 1 | J5:3 | GPIO_AD_B0_02 | Yes | nONLSEL |  | Yes
IR0 | Read Data, Channel 0 (MSB) | In | IN2a | P2 | 2 | J4:11 | GPIO_AD_B1_07 | Yes | nONLSEL |  | Yes
IR1 | Read Data, Channel 1 | In | IN2a | P2 | 3 | J4:10 | GPIO_AD_B1_06 | Yes | nONLSEL |  | Yes
ILDP | Load Point | In | IN5a | P2 | 4 | IOExpander:14 | 0 | Yes | nONLSEL |  | Yes
IR4 | Read Data, Channel 4 | In | IN2a | P2 | 6 | J4:12 | GPIO_AD_B1_03 | Yes | nONLSEL |  | Yes
IR7 | Read Data, Channel 7 (LSB) | In | IN2a | P2 | 8 | J4:8 | GPIO_AD_B1_00 | Yes | nONLSEL |  | Yes
IR6 | Read Data, Channel 6 | In | IN2a | P2 | 10 | J4:9 | GPIO_AD_B1_01 | Yes | nONLSEL |  | Yes
IHER | Hard Error | In | IN2a | P2 | 12 | J4:22 | GPIO_B1_12 | Yes | nONLSEL |  | Yes
IFMK | Filemark | In | IN3a | P2 | 14 | J5:2 | GPIO_AD_B0_03 | Yes | nONLSEL |  | Yes
IDENT | Identification Burst | In | IN4b | P2 | 16 | IOExpander:0 | 0 | Yes | nONLSEL |  | Yes
IR5 | Read Data, Channel 5 | In | IN2a | P2 | 20 | J4:13 | GPIO_AD_B1_02 | Yes | nONLSEL |  | Yes
IEOT | End of Tape | In | IN3a | P2 | 22 | J5:23 | GPIO_EMC_36 | Yes | nONLSEL |  | Yes
INRZ | 3200 BPI selected (optional) | In | IN5b | P2 | 26 | IOExpander:3 | 0 | Yes | nONLSEL | IHIDEN/NRZI | Yes | DEN1 | In
IRDY | Ready | In | IN4a | P2 | 28 | J5:4 | GPIO_EMC_04 | Yes | nONLSEL |  | Yes
IRWD | Rewinding | In | IN4b | P2 | 30 | IOExpander:1 | 0 | Yes | nSTATENA |  | Yes
IFPT | File Protected | In | IN5a | P2 | 32 | IOExpander:15 | 0 | Yes | nSTATENA |  | Yes
IRSTR | Read Strobe | In | IN1a | P2 | 34 | J4:21 | GPIO_B1_02 | Yes | nONLSEL |  | Yes
IWSTR | Write Strobe | In | IN1a | P2 | 36 | J4:20 | GPIO_B1_03 | Yes | nONLSEL |  | Yes
IDBY | Data Busy | In | IN3a | P2 | 38 | J5:6 | GPIO_EMC_06 | Yes | nONLSEL |  | Yes
ISPEED | Early EOT Indicator (approx. 50 feet) | In | IN4b | P2 | 40 | IOExpander:2 | 0 | Yes | nSTATENA |  | Yes | SPD | In
ICER | Correctable Error | In | IN2a | P2 | 42 | J4:23 | GPIO_B1_13 | Yes | nONLSEL |  | Yes
IONL | Online | In | IN5a | P2 | 44 | IOExpander:13 | 0 | Yes | nSTATENA |  | Yes
ILWD | Last Word (terminates write command) | Out | OUT1a | P1 | 4 | J4:14 | GPIO_B0_03 | Yes |  |  | Yes
IW4 | Write Data, Channel 4 | Out | OUT1a | P1 | 6 | J4:6 | GPIO_AD_B1_11 | Yes |  |  | Yes
IGO | Go pulse (command strobe) | Out | OUT2a | P1 | 8 | J5:8 | GPIO_B0_10 | Yes |  |  | Yes
IW0 | Write Data, Channel 0 (MSB) | Out | OUT1a | P1 | 10 | J5:19 | GPIO_AD_B1_15 | Yes |  |  | Yes
IW1 | Write Data, Channel 1 | Out | OUT1a | P1 | 12 | J5:18 | GPIO_AD_B1_14 | Yes |  |  | Yes
ISGL | Selected drive fault | Out | UDFB | P1 | 14 | IOExpander:9 | 0 | Yes |  | Reserved/SPCMD1 | Yes | DEN0 | In
ILOL | Load on line | Out | UDFO | P1 | 16 | IOExpander:10 | 0 | Yes |  | Reserved/SPCMD2 | Yes
IREV | Reverse | Out | OUT2a | P1 | 18 | J5:11 | GPIO_B0_11 | Yes |  |  | Yes
IREW | Rewind | Out | OUT2a | P1 | 20 | J5:10 | GPIO_B1_00 | Yes |  |  | Yes
IWP | Write Data, Parity (optional) | Out | OUT1b | P1 | 22 | J5:9 | GPIO_B1_01 | Yes |  |  | Yes
IW7 | Write Data, Channel 7 (LSB) | Out | OUT1a | P1 | 24 | J4:5 | GPIO_AD_B1_08 | Yes |  |  | Yes
IW3 | Write Data, Channel 3 | Out | OUT1a | P1 | 26 | J4:19 | GPIO_AD_B1_12 | Yes |  |  | Yes
IW6 | Write Data, Channel 6 | Out | OUT1a | P1 | 28 | J4:4 | GPIO_AD_B1_09 | Yes |  |  | Yes
IW2 | Write Data, Channel 2 | Out | OUT1a | P1 | 30 | J4:18 | GPIO_AD_B1_13 | Yes |  |  | Yes
IW5 | Write Data, Channel 5 | Out | OUT1a | P1 | 32 | J4:7 | GPIO_AD_B1_10 | Yes |  |  | Yes
IWRT | Write | Out | OUT2a | P1 | 34 | J5:12 | GPIO_B0_00 | Yes |  |  | Yes
IRTH2 | Write density select 2 | Out | UDFO | P1 | 36 | IOExpander:11 | 0 |  |  | Reserved | Yes | LGP | Out
IEDIT | Edit | Out | OUT2a | P1 | 38 | J5:13 | GPIO_B0_02 | Yes |  |  | Yes
IERASE | Erase | Out | OUT2a | P1 | 40 | J5:14 | GPIO_B0_01 | Yes |  |  | Yes
IWFM | Write Filemark | Out | OUT2a | P1 | 42 | J5:24 | GPIO_B0_12 | Yes |  |  | Yes
IRTH1 | Write density select 1 | Out | UDFO | P1 | 44 | IOExpander:12 | 0 |  |  | Reserved
ITAD0 | Transport Address 0 (MSB) | Out | OUT3a | P1 | 46 | IOExpander:4 | 0 | Yes |  |  | Yes
IFEN | Formatter Enable | Out | OUT3a | P2 | 18 | IOExpander:5 | 0 | Yes |  |  | Yes
IOFL | Rewind/Unload | Out | OUT2a | P2 | 24 | J5:22 | GPIO_EMC_37 | Yes |  | IRWU | Yes | OFL | Out
ITAD1 | Transport Address 1 (LSB) | Out | OUT3a | P2 | 46 | IOExpander:6 | 0 | Yes |  |  | Yes
IFAD | Formatter Address | Out | OUT3a | P2 | 48 | IOExpander:7 | 0 | Yes |  |  | Yes
IDEN | Speed select | Out | OUT3a | P2 | 50 | IOExpander:8 | 0 | Yes |  | IHISP | Yes | HSP | Out

Sheet: PertecSignalGroups
Signal Group Names
Group names 'a' are actually important, 'b' are optional
IN1 | Strobes
IN2 | Incoming signals that need to be read within a bit-time of transitions of IRSTR
IN3 | Incoming signals whose change during an operation can indicate the end of the operation
IN4 | Incoming signals with an expected lifespan of a command
IN5 | Incoming signals of semi-static state (online, at load point, etc.)
OUT1 | Outgoing signals that need to be updated within a bit-time of transitions of IWSTR
OUT2 | Outgoing signals with the lifespan of a single command
OUT3 | Outgoing signals with the lifespan of a connection time
UDFB | Undefined signals that are defined as both outputs and inputs, depending on implementation
UDFO | Undefined signals that are always outputs

Sheet: CPUMuxingOptions
IMXRT1060 muxing options
from i.MX RT1060 Processor Reference Manual
NXP Semiconductors
Document Number: IMXRT1060RM, Rev. 3, 07/2021
https://www.pjrc.com/teensy/IMXRT1060RM_rev3.pdf
pp. 289-316, section 10.1.1 "Muxing Options" Table 10-1 "Muxing Options"
Instance | Port | Pad | Mode
ACMP1 | ACMP1_IN0 | GPIO_AD_B1_01 | -
ACMP1 | ACMP1_IN1 | GPIO_AD_B1_06 | -
ACMP1 | ACMP1_IN2 | GPIO_AD_B0_13 | -
ACMP1 | ACMP1_IN3 | GPIO_AD_B1_02 | -
ACMP1 | ACMP1_IN4 | GPIO_AD_B0_00 | -
ACMP1 | ACMP1_IN5 | GPIO_AD_B1_07 | -
ACMP1 | ACMP1_IN6 | GPIO_AD_B1_11 | -
ACMP1 | ACMP1_OUT | GPIO_AD_B1_12 | -
ACMP2 | ACMP2_IN0 | GPIO_AD_B1_01 | -
ACMP2 | ACMP2_IN1 | GPIO_AD_B1_06 | -
ACMP2 | ACMP2_IN2 | GPIO_AD_B0_14 | -
ACMP2 | ACMP2_IN3 | GPIO_AD_B1_03 | -
ACMP2 | ACMP2_IN4 | GPIO_AD_B0_01 | -
ACMP2 | ACMP2_IN5 | GPIO_AD_B1_08 | -
ACMP2 | ACMP2_IN6 | GPIO_AD_B1_12 | -
ACMP2 | ACMP2_OUT | GPIO_AD_B1_13 | -
ACMP3 | ACMP3_IN0 | GPIO_AD_B1_01 | -
ACMP3 | ACMP3_IN1 | GPIO_AD_B1_06 | -
ACMP3 | ACMP3_IN2 | GPIO_AD_B0_15 | -
ACMP3 | ACMP3_IN3 | GPIO_AD_B1_04 | -
ACMP3 | ACMP3_IN4 | GPIO_AD_B0_02 | -
ACMP3 | ACMP3_IN5 | GPIO_AD_B1_09 | -
ACMP3 | ACMP3_IN6 | GPIO_AD_B1_13 | -
ACMP3 | ACMP3_OUT | GPIO_AD_B1_14 | -
ACMP4 | ACMP4_IN0 | GPIO_AD_B1_01 | -
ACMP4 | ACMP4_IN1 | GPIO_AD_B1_06 | -
ACMP4 | ACMP4_IN2 | GPIO_AD_B1_00 | -
ACMP4 | ACMP4_IN3 | GPIO_AD_B1_05 | -
ACMP4 | ACMP4_IN4 | GPIO_AD_B0_03 | -
ACMP4 | ACMP4_IN5 | GPIO_AD_B1_10 | -
ACMP4 | ACMP4_IN6 | GPIO_AD_B1_14 | -
ACMP4 | ACMP4_OUT | GPIO_AD_B1_15 | -
ADC1 | ADC1_IN0 | GPIO_AD_B1_11 | -
ADC1 | ADC1_IN1 | GPIO_AD_B0_12 | -
ADC1 | ADC1_IN10 | GPIO_AD_B1_05 | -
ADC1 | ADC1_IN11 | GPIO_AD_B1_06 | -
ADC1 | ADC1_IN12 | GPIO_AD_B1_07 | -
ADC1 | ADC1_IN13 | GPIO_AD_B1_08 | -
ADC1 | ADC1_IN14 | GPIO_AD_B1_09 | -
ADC1 | ADC1_IN15 | GPIO_AD_B1_10 | -
ADC1 | ADC1_IN2 | GPIO_AD_B0_13 | -
ADC1 | ADC1_IN3 | GPIO_AD_B0_14 | -
ADC1 | ADC1_IN4 | GPIO_AD_B0_15 | -
ADC1 | ADC1_IN5 | GPIO_AD_B1_00 | -
ADC1 | ADC1_IN6 | GPIO_AD_B1_01 | -
ADC1 | ADC1_IN7 | GPIO_AD_B1_02 | -
ADC1 | ADC1_IN8 | GPIO_AD_B1_03 | -
ADC1 | ADC1_IN9 | GPIO_AD_B1_04 | -
ADC2 | ADC2_IN0 | GPIO_AD_B1_11 | -
ADC2 | ADC2_IN1 | GPIO_AD_B1_12 | -
ADC2 | ADC2_IN10 | GPIO_AD_B1_05 | -
ADC2 | ADC2_IN11 | GPIO_AD_B1_06 | -
ADC2 | ADC2_IN12 | GPIO_AD_B1_07 | -
ADC2 | ADC2_IN13 | GPIO_AD_B1_08 | -
ADC2 | ADC2_IN14 | GPIO_AD_B1_09 | -
ADC2 | ADC2_IN15 | GPIO_AD_B1_10 | -
ADC2 | ADC2_IN2 | GPIO_AD_B1_13 | -
ADC2 | ADC2_IN3 | GPIO_AD_B1_14 | -
ADC2 | ADC2_IN4 | GPIO_AD_B1_15 | -
ADC2 | ADC2_IN5 | GPIO_AD_B1_00 | -
ADC2 | ADC2_IN6 | GPIO_AD_B1_01 | -
ADC2 | ADC2_IN7 | GPIO_AD_B1_02 | -
ADC2 | ADC2_IN8 | GPIO_AD_B1_03 | -
ADC2 | ADC2_IN9 | GPIO_AD_B1_04 | -
ARM PLATFORM | ARM_EVENT0 | GPIO_BO_14 | ALT2
ARM PLATFORM | ARM_EVENT1 | GPIO_B0_15 | ALT2
TPIU | ARM_TRACE_CLK | GPIO_B0_12 | ALT2
TPIU | ARM_TRACE_SWO | GPIO_B0_13 | ALT2
TPIU | ARM_TRACE0 | GPIO_B0_04 | ALT3
TPIU | ARM_TRACE1 | GPIO_B0_05 | ALT3
TPIU | ARM_TRACE2 | GPIO_B0_06 | ALT3
TPIU | ARM_TRACE3 | GPIO_B0_07 | ALT3
CCM | CCM_CLK1_N | CCM_CLK1_N | No Muxing
CCM | CCM_CLK1_P | CCM_CLK1_P | No Muxing
CCM | CCM_CLKO1 | GPIO_SD_B0_04 | ALT6
CCM | CCM_CLKO2 | GPIO_SD_B0_05 | ALT6
CCM | CCM_PMIC_READY | GPIO_AD_B0_12 | ALT1
CCM | CCM_PMIC_READY | GPIO_AD_B1_01 | ALT4
CCM | CCM_PMIC_READY | GPIO_AD_B1_08 | ALT3
CCM | CCM_PMIC_READY | GPIO_EMC_32 | ALT3
CCM | CCM_PMIC_READY | GPIO_SD_B1_03 | ALT6
CCM | CCM_PMIC_STBY_REQ | PMIC_STBY_REQ | ALT0
CCM | CCM_STOP | GPIO_SD_B1_04 | ALT6
CCM | CCM_WAIT | GPIO_SD_B1_02 | ALT6
CSI | CSI_DATA00 | GPIO_B1_10 | ALT2
CSI | CSI_DATA01 | GPIO_B1_11 | ALT2
CSI | CSI_DATA02 | GPIO_AD_B0_11 | ALT4
CSI | CSI_DATA02 | GPIO_AD_B1_15 | ALT4
CSI | CSI_DATA03 | GPIO_AD_B0_10 | ALT4
CSI | CSI_DATA03 | GPIO_AD_B1_14 | ALT4
CSI | CSI_DATA04 | GPIO_AD_B0_09 | ALT4
CSI | CSI_DATA04 | GPIO_AD_B1_13 | ALT4
CSI | CSI_DATA05 | GPIO_AD_B0_08 | ALT4
CSI | CSI_DATA05 | GPIO_AD_B1_12 | ALT4
CSI | CSI_DATA06 | GPIO_AD_B0_07 | ALT4
CSI | CSI_DATA06 | GPIO_AD_B1_11 | ALT4
CSI | CSI_DATA07 | GPIO_AD_B0_06 | ALT4
CSI | CSI_DATA07 | GPIO_AD_B1_10 | ALT4
CSI | CSI_DATA08 | GPIO_AD_B0_05 | ALT4
CSI | CSI_DATA08 | GPIO_AD_B1_09 | ALT4
CSI | CSI_DATA09 | GPIO_AD_B0_04 | ALT4
CSI | CSI_DATA09 | GPIO_AD_B1_08 | ALT4
CSI | CSI_DATA10 | GPIO_B1_09 | ALT2
CSI | CSI_DATA11 | GPIO_B1_08 | ALT2
CSI | CSI_DATA12 | GPIO_B1_07 | ALT2
CSI | CSI_DATA13 | GPIO_B1_06 | ALT2
CSI | CSI_DATA14 | GPIO_B1_05 | ALT2
CSI | CSI_DATA15 | GPIO_B1_04 | ALT2
CSI | CSI_DATA16 | GPIO_EMC_37 | ALT4
CSI | CSI_DATA17 | GPIO_EMC_36 | ALT4
CSI | CSI_DATA18 | GPIO_EMC_35 | ALT4
CSI | CSI_DATA19 | GPIO_EMC_34 | ALT4
CSI | CSI_DATA20 | GPIO_EMC_33 | ALT4
CSI | CSI_DATA21 | GPIO_EMC_32 | ALT4
CSI | CSI_DATA22 | GPIO_EMC_31 | ALT4
CSI | CSI_DATA23 | GPIO_EMC_30 | ALT4
CSI | CSI_FIELD | GPIO_EMC_38 | ALT4
CSI | CSI_HSYNC | GPIO_AD_B0_15 | ALT4
CSI | CSI_HSYNC | GPIO_AD_B1_07 | ALT4
CSI | CSI_HSYNC | GPIO_B1_14 | ALT2
CSI | CSI_MCLK | GPIO_AD_B1_05 | ALT4
CSI | CSI_MCLK | GPIO_B1_15 | ALT2
CSI | CSI_PIXCLK | GPIO_AD_B1_04 | ALT4
CSI | CSI_PIXCLK | GPIO_B1_12 | ALT2
CSI | CSI_VSYNC | GPIO_AD_B0_14 | ALT4
CSI | CSI_VSYNC | GPIO_AD_B1_06 | ALT4
CSI | CSI_VSYNC | GPIO_B1_13 | ALT2
ENET | ENET_1588_EVENT0_IN | GPIO_AD_B0_11 | ALT7
ENET | ENET_1588_EVENT0_IN | GPIO_AD_B0_15 | ALT3
ENET | ENET_1588_EVENT0_IN | GPIO_B1_12 | ALT3
ENET | ENET_1588_EVENT0_OUT | GPIO_AD_B0_10 | ALT7
ENET | ENET_1588_EVENT0_OUT | GPIO_AD_B0_14 | ALT3
ENET | ENET_1588_EVENT0_OUT | GPIO_B1_13 | ALT3
ENET | ENET_1588_EVENT1_IN | GPIO_AD_B0_13 | ALT6
ENET | ENET_1588_EVENT1_OUT | GPIO_AD_B0_12 | ALT6
ENET | ENET_1588_EVENT2_IN | GPIO_AD_B1_03 | ALT4
ENET | ENET_1588_EVENT2_OUT | GPIO_AD_B1_02 | ALT4
ENET | ENET_1588_EVENT3_IN | GPIO_AD_B0_08 | ALT7
ENET | ENET_1588_EVENT3_OUT | GPIO_AD_B0_07 | ALT7
ENET | ENET_COL | GPIO_AD_B0_11 | ALT2
ENET | ENET_CRS | GPIO_AD_B0_10 | ALT2
ENET | ENET_MDC | GPIO_AD_B1_04 | ALT1
ENET | ENET_MDC | GPIO_B1_14 | ALT0
ENET | ENET_MDC | GPIO_EMC_40 | ALT4
ENET | ENET_MDIO | GPIO_AD_B1_05 | ALT1
ENET | ENET_MDIO | GPIO_B1_15 | ALT0
ENET | ENET_MDIO | GPIO_EMC_41 | ALT4
ENET | ENET_REF_CLK | GPIO_B1_10 | ALT6
ENET | ENET_REF_CLK | GPIO_EMC_25 | ALT4
ENET | ENET_RX_CLK | GPIO_AD_B0_06 | ALT2
ENET | ENET_RX_DATA0 | GPIO_B1_04 | ALT3
ENET | ENET_RX_DATA0 | GPIO_EMC_20 | ALT3
ENET | ENET_RX_DATA1 | GPIO_B1_05 | ALT3
ENET | ENET_RX_DATA1 | GPIO_EMC_19 | ALT3
ENET | ENET_RX_DATA2 | GPIO_AD_B0_09 | ALT2
ENET | ENET_RX_DATA3 | GPIO_AD_B0_08 | ALT2
ENET | ENET_RX_EN | GPIO_B1_06 | ALT3
ENET | ENET_RX_EN | GPIO_EMC_23 | ALT3
ENET | ENET_RX_ER | GPIO_B1_11 | ALT3
ENET | ENET_RX_ER | GPIO_EMC_26 | ALT3
ENET | ENET_TX_CLK | GPIO_B1_10 | ALT3
ENET | ENET_TX_CLK | GPIO_EMC_25 | ALT3
ENET | ENET_TX_DATA0 | GPIO_B1_07 | ALT3
ENET | ENET_TX_DATA0 | GPIO_EMC_22 | ALT3
ENET | ENET_TX_DATA1 | GPIO_B1_08 | ALT3
ENET | ENET_TX_DATA1 | GPIO_EMC_21 | ALT3
ENET | ENET_TX_DATA2 | GPIO_AD_B0_05 | ALT2
ENET | ENET_TX_DATA3 | GPIO_AD_B0_04 | ALT2
ENET | ENET_TX_EN | GPIO_B1_09 | ALT3
ENET | ENET_TX_EN | GPIO_EMC_24 | ALT3
ENET | ENET_TX_ER | GPIO_AD_B0_07 | ALT2
ENET2 | ENET2_1588_EVENT0_IN | GPIO_AD_B1_01 | ALT8
ENET2 | ENET2_1588_EVENT0_IN | GPIO_B0_03 | ALT8
ENET2 | ENET2_1588_EVENT0_OUT | GPIO_AD_B1_00 | ALT8
ENET2 | ENET2_1588_EVENT0_OUT | GPIO_B0_02 | ALT8
ENET2 | ENET2_1588_EVENT1_IN | GPIO_AD_B1_11 | ALT8
ENET2 | ENET2_1588_EVENT1_OUT | GPIO_AD_B1_10 | ALT8
ENET2 | ENET2_1588_EVENT2_IN | GPIO_AD_B1_13 | ALT8
ENET2 | ENET2_1588_EVENT2_OUT | GPIO_AD_B1_12 | ALT8
ENET2 | ENET2_1588_EVENT3_IN | GPIO_AD_B1_15 | ALT8
ENET2 | ENET2_1588_EVENT3_OUT | GPIO_AD_B1_14 | ALT8
ENET2 | ENET2_COL | GPIO_B0_11 | ALT8
ENET2 | ENET2_CRS | GPIO_B0_10 | ALT8
ENET2 | ENET2_MDC | GPIO_B0_00 | ALT8
ENET2 | ENET2_MDC | GPIO_EMC_38 | ALT8
ENET2 | ENET2_MDIO | GPIO_B0_01 | ALT8
ENET2 | ENET2_MDIO | GPIO_EMC_39 | ALT8
ENET2 | ENET2_RDATA0 | GPIO_B1_01 | ALT8
ENET2 | ENET2_RDATA0 | GPIO_EMC_35 | ALT8
ENET2 | ENET2_RDATA0 | GPIO_SD_B0_03 | ALT8
ENET2 | ENET2_RDATA1 | GPIO_B1_02 | ALT8
ENET2 | ENET2_RDATA1 | GPIO_EMC_36 | ALT8
ENET2 | ENET2_RDATA1 | GPIO_SD_B0_04 | ALT8
ENET2 | ENET2_RDATA2 | GPIO_B0_09 | ALT8
ENET2 | ENET2_RDATA3 | GPIO_B0_08 | ALT8
ENET2 | ENET2_REF_CLK2 | GPIO_B0_15 | ALT9
ENET2 | ENET2_REF_CLK2 | GPIO_EMC_33 | ALT9
ENET2 | ENET2_REF_CLK2 | GPIO_SD_B0_01 | ALT9
ENET2 | ENET2_RX_CLK | GPIO_B0_06 | ALT8
ENET2 | ENET2_RX_EN | GPIO_B1_03 | ALT8
ENET2 | ENET2_RX_EN | GPIO_EMC_37 | ALT8
ENET2 | ENET2_RX_EN | GPIO_SD_B0_05 | ALT8
ENET2 | ENET2_RX_ER | GPIO_B1_00 | ALT8
ENET2 | ENET2_RX_ER | GPIO_EMC_34 | ALT8
ENET2 | ENET2_RX_ER | GPIO_SD_B0_02 | ALT8
ENET2 | ENET2_TDATA0 | GPIO_B0_12 | ALT8
ENET2 | ENET2_TDATA0 | GPIO_B1_14 | ALT8
ENET2 | ENET2_TDATA0 | GPIO_EMC_30 | ALT8
ENET2 | ENET2_TDATA1 | GPIO_B0_13 | ALT8
ENET2 | ENET2_TDATA1 | GPIO_B1_15 | ALT8
ENET2 | ENET2_TDATA1 | GPIO_EMC_31 | ALT8
ENET2 | ENET2_TDATA2 | GPIO_B0_05 | ALT8
ENET2 | ENET2_TDATA3 | GPIO_B0_04 | ALT8
ENET2 | ENET2_TX_CLK | GPIO_B0_15 | ALT8
ENET2 | ENET2_TX_CLK | GPIO_EMC_33 | ALT8
ENET2 | ENET2_TX_CLK | GPIO_SD_B0_01 | ALT8
ENET2 | ENET2_TX_EN | GPIO_B0_14 | ALT8
ENET2 | ENET2_TX_EN | GPIO_EMC_32 | ALT8
ENET2 | ENET2_TX_EN | GPIO_SD_B0_00 | ALT8
ENET2 | ENET2_TX_ER | GPIO_B0_07 | ALT8
EWM | EWM_OUT_B | GPIO_AD_B0_01 | ALT6
EWM | EWM_OUT_B | GPIO_AD_B0_13 | ALT3
EWM | EWM_OUT_B | GPIO_AD_B1_11 | ALT1
FLEXCAN1 | FLEXCAN1_RX | GPIO_AD_B1_09 | ALT2
FLEXCAN1 | FLEXCAN1_RX | GPIO_B0_03 | ALT2
FLEXCAN1 | FLEXCAN1_RX | GPIO_EMC_18 | ALT3
FLEXCAN1 | FLEXCAN1_RX | GPIO_SD_B1_03 | ALT4
FLEXCAN1 | FLEXCAN1_TX | GPIO_AD_B1_08 | ALT2
FLEXCAN1 | FLEXCAN1_TX | GPIO_B0_02 | ALT2
FLEXCAN1 | FLEXCAN1_TX | GPIO_EMC_17 | ALT3
FLEXCAN1 | FLEXCAN1_TX | GPIO_SD_B1_02 | ALT4
FLEXCAN2 | FLEXCAN2_RX | GPIO_AD_B0_03 | ALT0
FLEXCAN2 | FLEXCAN2_RX | GPIO_AD_B0_15 | ALT6
FLEXCAN2 | FLEXCAN2_RX | GPIO_B1_09 | ALT6
FLEXCAN2 | FLEXCAN2_RX | GPIO_EMC_10 | ALT3
FLEXCAN2 | FLEXCAN2_TX | GPIO_AD_B0_02 | ALT0
FLEXCAN2 | FLEXCAN2_TX | GPIO_AD_B0_14 | ALT6
FLEXCAN2 | FLEXCAN2_TX | GPIO_B1_08 | ALT6
FLEXCAN2 | FLEXCAN2_TX | GPIO_EMC_09 | ALT3
FLEXCAN3 | FLEXCAN3_RX | GPIO_AD_B0_11 | ALT8
FLEXCAN3 | FLEXCAN3_RX | GPIO_AD_B0_15 | ALT8
FLEXCAN3 | FLEXCAN3_RX | GPIO_EMC_37 | ALT9
FLEXCAN3 | FLEXCAN3_TX | GPIO_AD_B0_10 | ALT8
FLEXCAN3 | FLEXCAN3_TX | GPIO_AD_B0_14 | ALT8
FLEXCAN3 | FLEXCAN3_TX | GPIO_EMC_36 | ALT9
FLEXIO1 | FLEXIO1_D00 | GPIO_EMC_00 | ALT4
FLEXIO1 | FLEXIO1_D01 | GPIO_EMC_01 | ALT4
FLEXIO1 | FLEXIO1_D02 | GPIO_EMC_02 | ALT4
FLEXIO1 | FLEXIO1_D03 | GPIO_EMC_03 | ALT4
FLEXIO1 | FLEXIO1_D04 | GPIO_EMC_04 | ALT4
FLEXIO1 | FLEXIO1_D05 | GPIO_EMC_05 | ALT4
FLEXIO1 | FLEXIO1_D06 | GPIO_EMC_06 | ALT4
FLEXIO1 | FLEXIO1_D07 | GPIO_EMC_07 | ALT4
FLEXIO1 | FLEXIO1_D08 | GPIO_EMC_08 | ALT4
FLEXIO1 | FLEXIO1_D09 | GPIO_EMC_09 | ALT4
FLEXIO1 | FLEXIO1_D10 | GPIO_EMC_10 | ALT4
FLEXIO1 | FLEXIO1_D11 | GPIO_EMC_11 | ALT4
FLEXIO1 | FLEXIO1_D12 | GPIO_EMC_26 | ALT4
FLEXIO1 | FLEXIO1_D13 | GPIO_EMC_27 | ALT4
FLEXIO1 | FLEXIO1_D14 | GPIO_EMC_28 | ALT4
FLEXIO1 | FLEXIO1_D15 | GPIO_EMC_29 | ALT4
FLEXIO2 | FLEXIO2_D00 | GPIO_B0_00 | ALT4
FLEXIO2 | FLEXIO2_D01 | GPIO_B0_01 | ALT4
FLEXIO2 | FLEXIO2_D02 | GPIO_B0_02 | ALT4
FLEXIO2 | FLEXIO2_D03 | GPIO_B0_03 | ALT4
FLEXIO2 | FLEXIO2_D04 | GPIO_B0_04 | ALT4
FLEXIO2 | FLEXIO2_D05 | GPIO_B0_05 | ALT4
FLEXIO2 | FLEXIO2_D06 | GPIO_B0_06 | ALT4
FLEXIO2 | FLEXIO2_D07 | GPIO_B0_07 | ALT4
FLEXIO2 | FLEXIO2_D08 | GPIO_B0_08 | ALT4
FLEXIO2 | FLEXIO2_D09 | GPIO_B0_09 | ALT4
FLEXIO2 | FLEXIO2_D10 | GPIO_B0_10 | ALT4
FLEXIO2 | FLEXIO2_D11 | GPIO_B0_11 | ALT4
FLEXIO2 | FLEXIO2_D12 | GPIO_B0_12 | ALT4
FLEXIO2 | FLEXIO2_D13 | GPIO_B0_13 | ALT4
FLEXIO2 | FLEXIO2_D14 | GPIO_B0_14 | ALT4
FLEXIO2 | FLEXIO2_D15 | GPIO_B0_15 | ALT4
FLEXIO2 | FLEXIO2_D16 | GPIO_B1_00 | ALT4
FLEXIO2 | FLEXIO2_D17 | GPIO_B1_01 | ALT4
FLEXIO2 | FLEXIO2_D18 | GPIO_B1_02 | ALT4
FLEXIO2 | FLEXIO2_D19 | GPIO_B1_03 | ALT4
FLEXIO2 | FLEXIO2_D20 | GPIO_B1_04 | ALT4
FLEXIO2 | FLEXIO2_D21 | GPIO_B1_05 | ALT4
FLEXIO2 | FLEXIO2_D22 | GPIO_B1_06 | ALT4
FLEXIO2 | FLEXIO2_D23 | GPIO_B1_07 | ALT4
FLEXIO2 | FLEXIO2_D24 | GPIO_B1_08 | ALT4
FLEXIO2 | FLEXIO2_D25 | GPIO_B1_09 | ALT4
FLEXIO2 | FLEXIO2_D26 | GPIO_B1_10 | ALT4
FLEXIO2 | FLEXIO2_D27 | GPIO_B1_11 | ALT4
FLEXIO2 | FLEXIO2_D28 | GPIO_B1_12 | ALT4
FLEXIO2 | FLEXIO2_D29 | GPIO_B1_13 | ALT4
FLEXIO2 | FLEXIO2_D30 | GPIO_B1_14 | ALT4
FLEXIO2 | FLEXIO2_D31 | GPIO_B1_15 | ALT4
FLEXIO3 | FLEXIO3_D00 | GPIO_AD_B1_00 | ALT9
FLEXIO3 | FLEXIO3_D01 | GPIO_AD_B1_01 | ALT9
FLEXIO3 | FLEXIO3_D02 | GPIO_AD_B1_02 | ALT9
FLEXIO3 | FLEXIO3_D03 | GPIO_AD_B1_03 | ALT9
FLEXIO3 | FLEXIO3_D04 | GPIO_AD_B1_04 | ALT9
FLEXIO3 | FLEXIO3_D05 | GPIO_AD_B1_05 | ALT9
FLEXIO3 | FLEXIO3_D06 | GPIO_AD_B1_06 | ALT9
FLEXIO3 | FLEXIO3_D07 | GPIO_AD_B1_07 | ALT9
FLEXIO3 | FLEXIO3_D08 | GPIO_AD_B1_08 | ALT9
FLEXIO3 | FLEXIO3_D09 | GPIO_AD_B1_09 | ALT9
FLEXIO3 | FLEXIO3_D10 | GPIO_AD_B1_10 | ALT9
FLEXIO3 | FLEXIO3_D11 | GPIO_AD_B1_11 | ALT9
FLEXIO3 | FLEXIO3_D12 | GPIO_AD_B1_12 | ALT9
FLEXIO3 | FLEXIO3_D13 | GPIO_AD_B1_13 | ALT9
FLEXIO3 | FLEXIO3_D14 | GPIO_AD_B1_14 | ALT9
FLEXIO3 | FLEXIO3_D15 | GPIO_AD_B1_15 | ALT9
FLEXIO3 | FLEXIO3_D16 | GPIO_B1_00 | ALT9
FLEXIO3 | FLEXIO3_D17 | GPIO_B1_01 | ALT9
FLEXIO3 | FLEXIO3_D18 | GPIO_B1_02 | ALT9
FLEXIO3 | FLEXIO3_D19 | GPIO_B1_03 | ALT9
FLEXIO3 | FLEXIO3_D20 | GPIO_B1_04 | ALT9
FLEXIO3 | FLEXIO3_D21 | GPIO_B1_05 | ALT9
FLEXIO3 | FLEXIO3_D22 | GPIO_B1_06 | ALT9
FLEXIO3 | FLEXIO3_D23 | GPIO_B1_07 | ALT9
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
GPIO4 | GPIO4_IO20 | GPIO_EMC_20 | ALT5
GPIO4 | GPIO4_IO21 | GPIO_EMC_21 | ALT5
GPIO4 | GPIO4_IO22 | GPIO_EMC_22 | ALT5
GPIO4 | GPIO4_IO23 | GPIO_EMC_23 | ALT5
GPIO4 | GPIO4_IO24 | GPIO_EMC_24 | ALT5
GPIO4 | GPIO4_IO25 | GPIO_EMC_25 | ALT5
GPIO4 | GPIO4_IO26 | GPIO_EMC_26 | ALT5
GPIO4 | GPIO4_IO27 | GPIO_EMC_27 | ALT5
GPIO4 | GPIO4_IO28 | GPIO_EMC_28 | ALT5
GPIO4 | GPIO4_IO29 | GPIO_EMC_29 | ALT5
GPIO4 | GPIO4_IO3 | GPIO_EMC_03 | ALT5
GPIO4 | GPIO4_IO30 | GPIO_EMC_30 | ALT5
GPIO4 | GPIO4_IO31 | GPIO_EMC_31 | ALT5
GPIO4 | GPIO4_IO4 | GPIO_EMC_04 | ALT5
GPIO4 | GPIO4_IO5 | GPIO_EMC_05 | ALT5
GPIO4 | GPIO4_IO6 | GPIO_EMC_06 | ALT5
GPIO4 | GPIO4_IO7 | GPIO_EMC_07 | ALT5
GPIO4 | GPIO4_IO8 | GPIO_EMC_08 | ALT5
GPIO4 | GPIO4_IO9 | GPIO_EMC_09 | ALT5
GPIO5 | GPIO5_IO00 | WAKEUP | ALT5
GPIO5 | GPIO5_IO01 | PMIC_ON_REQ | ALT5
GPIO5 | GPIO5_IO02 | PMIC_STBY_REQ | ALT5
GPT1 | GPT1_CAPTURE1 | GPIO_B1_05 | ALT8
GPT1 | GPT1_CAPTURE1 | GPIO_EMC_24 | ALT4
GPT1 | GPT1_CAPTURE2 | GPIO_B1_06 | ALT8
GPT1 | GPT1_CAPTURE2 | GPIO_EMC_23 | ALT4
GPT1 | GPT1_CLK | GPIO_AD_B0_13 | ALT1
GPT1 | GPT1_CLK | GPIO_B1_04 | ALT8
GPT1 | GPT1_COMPARE1 | GPIO_B1_07 | ALT8
GPT1 | GPT1_COMPARE1 | GPIO_EMC_35 | ALT2
GPT1 | GPT1_COMPARE2 | GPIO_B1_08 | ALT8
GPT1 | GPT1_COMPARE2 | GPIO_EMC_36 | ALT2
GPT1 | GPT1_COMPARE3 | GPIO_B1_09 | ALT8
GPT1 | GPT1_COMPARE3 | GPIO_EMC_37 | ALT2
GPT2 | GPT2_CAPTURE1 | GPIO_AD_B1_03 | ALT8
GPT2 | GPT2_CAPTURE1 | GPIO_EMC_41 | ALT1
GPT2 | GPT2_CAPTURE2 | GPIO_AD_B1_04 | ALT8
GPT2 | GPT2_CAPTURE2 | GPIO_EMC_40 | ALT1
GPT2 | GPT2_CLK | GPIO_AD_B0_09 | ALT7
GPT2 | GPT2_CLK | GPIO_AD_B1_02 | ALT8
GPT2 | GPT2_COMPARE1 | GPIO_AD_B0_06 | ALT1
GPT2 | GPT2_COMPARE1 | GPIO_AD_B1_05 | ALT8
GPT2 | GPT2_COMPARE2 | GPIO_AD_B0_07 | ALT1
GPT2 | GPT2_COMPARE2 | GPIO_AD_B1_06 | ALT8
GPT2 | GPT2_COMPARE3 | GPIO_AD_B0_08 | ALT1
GPT2 | GPT2_COMPARE3 | GPIO_AD_B1_07 | ALT8
JTAG | JTAG_DE_B | GPIO_EMC_01 | ALT7
JTAG | JTAG_MOD | GPIO_AD_B0_08 | ALT0
JTAG | JTAG_TCK | GPIO_AD_B0_07 | ALT0
JTAG | JTAG_TDI | GPIO_AD_B0_09 | ALT0
JTAG | JTAG_TDO | GPIO_AD_B0_10 | ALT0
JTAG | JTAG_TMS | GPIO_AD_B0_06 | ALT0
JTAG | JTAG_TRSTB | GPIO_AD_B0_11 | ALT0
KPP | KPP_COL0 | GPIO_AD_B1_15 | ALT7
KPP | KPP_COL1 | GPIO_AD_B1_13 | ALT7
KPP | KPP_COL2 | GPIO_AD_B1_11 | ALT7
KPP | KPP_COL3 | GPIO_AD_B1_09 | ALT7
KPP | KPP_COL4 | GPIO_AD_B1_07 | ALT7
KPP | KPP_COL5 | GPIO_AD_B1_05 | ALT7
KPP | KPP_COL6 | GPIO_AD_B1_03 | ALT7
KPP | KPP_COL7 | GPIO_AD_B1_01 | ALT7
KPP | KPP_ROW0 | GPIO_AD_B1_14 | ALT7
KPP | KPP_ROW1 | GPIO_AD_B1_12 | ALT7
KPP | KPP_ROW2 | GPIO_AD_B1_10 | ALT7
KPP | KPP_ROW3 | GPIO_AD_B1_08 | ALT7
KPP | KPP_ROW4 | GPIO_AD_B1_06 | ALT7
KPP | KPP_ROW5 | GPIO_AD_B1_04 | ALT7
KPP | KPP_ROW6 | GPIO_AD_B1_02 | ALT7
KPP | KPP_ROW7 | GPIO_AD_B1_00 | ALT7
LCD | LCD_CLK | GPIO_B0_00 | ALT0
LCD | LCD_DATA00 | GPIO_B0_04 | ALT0
LCD | LCD_DATA01 | GPIO_B0_05 | ALT0
LCD | LCD_DATA02 | GPIO_B0_06 | ALT0
LCD | LCD_DATA03 | GPIO_B0_07 | ALT0
LCD | LCD_DATA04 | GPIO_B0_08 | ALT0
LCD | LCD_DATA05 | GPIO_B0_09 | ALT0
LCD | LCD_DATA06 | GPIO_B0_10 | ALT0
LCD | LCD_DATA07 | GPIO_B0_11 | ALT0
LCD | LCD_DATA08 | GPIO_B0_12 | ALT0
LCD | LCD_DATA09 | GPIO_B0_13 | ALT0
LCD | LCD_DATA10 | GPIO_B0_14 | ALT0
LCD | LCD_DATA11 | GPIO_B0_15 | ALT0
LCD | LCD_DATA12 | GPIO_B1_00 | ALT0
LCD | LCD_DATA13 | GPIO_B1_01 | ALT0
LCD | LCD_DATA14 | GPIO_B1_02 | ALT0
LCD | LCD_DATA15 | GPIO_B1_03 | ALT0
LCD | LCD_DATA16 | GPIO_B1_04 | ALT0
LCD | LCD_DATA17 | GPIO_B1_05 | ALT0
LCD | LCD_DATA18 | GPIO_B1_06 | ALT0
LCD | LCD_DATA19 | GPIO_B1_07 | ALT0
LCD | LCD_DATA20 | GPIO_B1_08 | ALT0
LCD | LCD_DATA21 | GPIO_B1_09 | ALT0
LCD | LCD_DATA22 | GPIO_B1_10 | ALT0
LCD | LCD_DATA23 | GPIO_B1_11 | ALT0
LCD | LCD_ENABLE | GPIO_B0_01 | ALT0
LCD | LCD_HSYNC | GPIO_B0_02 | ALT0
LCD | LCD_VSYNC | GPIO_B0_03 | ALT0
LPI2C1 | LPI2C1_HREQ | GPIO_AD_B0_02 | ALT6
LPI2C1 | LPI2C1_SCL | GPIO_AD_B1_00 | ALT3
LPI2C1 | LPI2C1_SCL | GPIO_SD_B1_04 | ALT2
LPI2C1 | LPI2C1_SCLS | GPIO_AD_B0_00 | ALT4
LPI2C1 | LPI2C1_SDA | GPIO_AD_B1_01 | ALT3
LPI2C1 | LPI2C1_SDA | GPIO_SD_B1_05 | ALT2
LPI2C1 | LPI2C1_SDAS | GPIO_AD_B0_01 | ALT4
LPI2C2 | LPI2C2_SCL | GPIO_B0_04 | ALT2
LPI2C2 | LPI2C2_SCL | GPIO_SD_B1_11 | ALT3
LPI2C2 | LPI2C2_SDA | GPIO_B0_05 | ALT2
LPI2C2 | LPI2C2_SDA | GPIO_SD_B1_10 | ALT3
LPI2C3 | LPI2C3_SCL | GPIO_AD_B1_07 | ALT1
LPI2C3 | LPI2C3_SCL | GPIO_EMC_22 | ALT2
LPI2C3 | LPI2C3_SCL | GPIO_SD_B0_00 | ALT2
LPI2C3 | LPI2C3_SDA | GPIO_AD_B1_06 | ALT1
LPI2C3 | LPI2C3_SDA | GPIO_EMC_21 | ALT2
LPI2C3 | LPI2C3_SDA | GPIO_SD_B0_01 | ALT2
LPI2C4 | LPI2C4_SCL | GPIO_AD_B0_12 | ALT0
LPI2C4 | LPI2C4_SCL | GPIO_EMC_12 | ALT2
LPI2C4 | LPI2C4_SDA | GPIO_AD_B0_13 | ALT0
LPI2C4 | LPI2C4_SDA | GPIO_EMC_11 | ALT2
LPSPI1 | LPSPI1_PCS0 | GPIO_EMC_30 | ALT3
LPSPI1 | LPSPI1_PCS0 | GPIO_SD_B0_01 | ALT4
LPSPI1 | LPSPI1_PCS1 | GPIO_EMC_31 | ALT3
LPSPI1 | LPSPI1_PCS2 | GPIO_EMC_40 | ALT2
LPSPI1 | LPSPI1_PCS3 | GPIO_EMC_41 | ALT2
LPSPI1 | LPSPI1_SCK | GPIO_EMC_27 | ALT3
LPSPI1 | LPSPI1_SCK | GPIO_SD_B0_00 | ALT4
LPSPI1 | LPSPI1_SIN | GPIO_EMC_29 | ALT3
LPSPI1 | LPSPI1_SIN | GPIO_SD_B0_03 | ALT4
LPSPI1 | LPSPI1_SOUT | GPIO_EMC_28 | ALT3
LPSPI1 | LPSPI1_SOUT | GPIO_SD_B0_02 | ALT4
LPSPI2 | LPSPI2_PCS0 | GPIO_EMC_01 | ALT2
LPSPI2 | LPSPI2_PCS0 | GPIO_SD_B1_06 | ALT4
LPSPI2 | LPSPI2_PCS1 | GPIO_EMC_14 | ALT4
LPSPI2 | LPSPI2_PCS2 | GPIO_SD_B1_10 | ALT4
LPSPI2 | LPSPI2_PCS3 | GPIO_SD_B1_11 | ALT4
LPSPI2 | LPSPI2_SCK | GPIO_EMC_00 | ALT2
LPSPI2 | LPSPI2_SCK | GPIO_SD_B1_07 | ALT4
LPSPI2 | LPSPI2_SIN | GPIO_EMC_03 | ALT2
LPSPI2 | LPSPI2_SIN | GPIO_SD_B1_09 | ALT4
LPSPI2 | LPSPI2_SOUT | GPIO_EMC_02 | ALT2
LPSPI2 | LPSPI2_SOUT | GPIO_SD_B1_08 | ALT4
LPSPI3 | LPSPI3_PCS0 | GPIO_AD_B0_03 | ALT7
LPSPI3 | LPSPI3_PCS0 | GPIO_AD_B1_12 | ALT2
LPSPI3 | LPSPI3_PCS1 | GPIO_AD_B0_04 | ALT7
LPSPI3 | LPSPI3_PCS2 | GPIO_AD_B0_05 | ALT7
LPSPI3 | LPSPI3_PCS3 | GPIO_AD_B0_06 | ALT7
LPSPI3 | LPSPI3_SCK | GPIO_AD_B0_00 | ALT7
LPSPI3 | LPSPI3_SCK | GPIO_AD_B1_15 | ALT2
LPSPI3 | LPSPI3_SIN | GPIO_AD_B0_02 | ALT7
LPSPI3 | LPSPI3_SIN | GPIO_AD_B1_13 | ALT2
LPSPI3 | LPSPI3_SOUT | GPIO_AD_B0_01 | ALT7
LPSPI3 | LPSPI3_SOUT | GPIO_AD_B1_14 | ALT2
LPSPI4 | LPSPI4_PCS0 | GPIO_B0_00 | ALT3
LPSPI4 | LPSPI4_PCS0 | GPIO_B1_04 | ALT1
LPSPI4 | LPSPI4_PCS1 | GPIO_B1_03 | ALT2
LPSPI4 | LPSPI4_PCS2 | GPIO_B1_02 | ALT2
LPSPI4 | LPSPI4_PCS3 | GPIO_B1_11 | ALT6
LPSPI4 | LPSPI4_SCK | GPIO_B0_03 | ALT3
LPSPI4 | LPSPI4_SCK | GPIO_B1_07 | ALT1
LPSPI4 | LPSPI4_SIN | GPIO_B0_01 | ALT3
LPSPI4 | LPSPI4_SIN | GPIO_B1_05 | ALT1
LPSPI4 | LPSPI4_SOUT | GPIO_B0_02 | ALT3
LPSPI4 | LPSPI4_SOUT | GPIO_B1_06 | ALT1
LPUART1 | LPUART1_CTS_B | GPIO_AD_B0_14 | ALT2
LPUART1 | LPUART1_RTS_B | GPIO_AD_B0_15 | ALT2
LPUART1 | LPUART1_RXD | GPIO_AD_B0_13 | ALT2
LPUART1 | LPUART1_TXD | GPIO_AD_B0_12 | ALT2
LPUART2 | LPUART2_CTS_B | GPIO_AD_B1_00 | ALT2
LPUART2 | LPUART2_RTS_B | GPIO_AD_B1_01 | ALT2
LPUART2 | LPUART2_RXD | GPIO_AD_B1_03 | ALT2
LPUART2 | LPUART2_RXD | GPIO_SD_B1_10 | ALT2
LPUART2 | LPUART2_TXD | GPIO_AD_B1_02 | ALT2
LPUART2 | LPUART2_TXD | GPIO_SD_B1_11 | ALT2
LPUART3 | LPUART3_CTS_B | GPIO_AD_B1_04 | ALT2
LPUART3 | LPUART3_CTS_B | GPIO_EMC_15 | ALT2
LPUART3 | LPUART3_RTS_B | GPIO_AD_B1_05 | ALT2
LPUART3 | LPUART3_RTS_B | GPIO_EMC_16 | ALT2
LPUART3 | LPUART3_RXD | GPIO_AD_B1_07 | ALT2
LPUART3 | LPUART3_RXD | GPIO_B0_09 | ALT3
LPUART3 | LPUART3_RXD | GPIO_EMC_14 | ALT2
LPUART3 | LPUART3_TXD | GPIO_AD_B1_06 | ALT2
LPUART3 | LPUART3_TXD | GPIO_B0_08 | ALT3
LPUART3 | LPUART3_TXD | GPIO_EMC_13 | ALT2
LPUART4 | LPUART4_CTS_B | GPIO_EMC_17 | ALT2
LPUART4 | LPUART4_RTS_B | GPIO_EMC_18 | ALT2
LPUART4 | LPUART4_RXD | GPIO_B1_01 | ALT2
LPUART4 | LPUART4_RXD | GPIO_EMC_20 | ALT2
LPUART4 | LPUART4_RXD | GPIO_SD_B1_01 | ALT4
LPUART4 | LPUART4_TXD | GPIO_B1_00 | ALT2
LPUART4 | LPUART4_TXD | GPIO_EMC_19 | ALT2
LPUART4 | LPUART4_TXD | GPIO_SD_B1_00 | ALT4
LPUART5 | LPUART5_CTS_B | GPIO_EMC_28 | ALT2
LPUART5 | LPUART5_RTS_B | GPIO_EMC_27 | ALT2
LPUART5 | LPUART5_RXD | GPIO_B1_13 | ALT1
LPUART5 | LPUART5_RXD | GPIO_EMC_24 | ALT2
LPUART5 | LPUART5_TXD | GPIO_B1_12 | ALT1
LPUART5 | LPUART5_TXD | GPIO_EMC_23 | ALT2
LPUART6 | LPUART6_CTS_B | GPIO_EMC_30 | ALT2
LPUART6 | LPUART6_RTS_B | GPIO_EMC_29 | ALT2
LPUART6 | LPUART6_RXD | GPIO_AD_B0_03 | ALT2
LPUART6 | LPUART6_RXD | GPIO_EMC_26 | ALT2
LPUART6 | LPUART6_TXD | GPIO_AD_B0_02 | ALT2
LPUART6 | LPUART6_TXD | GPIO_EMC_25 | ALT2
LPUART7 | LPUART7_CTS_B | GPIO_SD_B1_06 | ALT2
LPUART7 | LPUART7_RTS_B | GPIO_SD_B1_07 | ALT2
LPUART7 | LPUART7_RXD | GPIO_EMC_32 | ALT2
LPUART7 | LPUART7_RXD | GPIO_SD_B1_09 | ALT2
LPUART7 | LPUART7_TXD | GPIO_EMC_31 | ALT2
LPUART7 | LPUART7_TXD | GPIO_SD_B1_08 | ALT2
LPUART8 | LPUART8_CTS_B | GPIO_SD_B0_02 | ALT2
LPUART8 | LPUART8_RTS_B | GPIO_SD_B0_03 | ALT2
LPUART8 | LPUART8_RXD | GPIO_AD_B1_11 | ALT2
LPUART8 | LPUART8_RXD | GPIO_EMC_39 | ALT2
LPUART8 | LPUART8_RXD | GPIO_SD_B0_05 | ALT2
LPUART8 | LPUART8_TXD | GPIO_AD_B1_10 | ALT2
LPUART8 | LPUART8_TXD | GPIO_EMC_38 | ALT2
LPUART8 | LPUART8_TXD | GPIO_SD_B0_04 | ALT2
MQS | MQS_LEFT | GPIO_AD_B0_05 | ALT1
MQS | MQS_LEFT | GPIO_B0_01 | ALT2
MQS | MQS_LEFT | GPIO_EMC_14 | ALT3
MQS | MQS_RIGHT | GPIO_AD_B0_04 | ALT1
MQS | MQS_RIGHT | GPIO_B0_00 | ALT2
MQS | MQS_RIGHT | GPIO_EMC_13 | ALT3
SRC_RESET_B | ONOFF | ALT0 | (No Muxing)
PIT | PIT_TRIGGER0 | GPIO_AD_B0_04 | ALT6
SRC SRC_POR_B | POR_B | ALT0 | (No Muxing)
XTALOSC | REF_CLK_24M | GPIO_AD_B0_01 | ALT2
XTALOSC | REF_CLK_24M | GPIO_AD_B0_03 | ALT6
XTALOSC | REF_CLK_24M | GPIO_AD_B0_13 | ALT7
XTALOSC | REF_CLK_32K | GPIO_AD_B0_00 | ALT2
SAI1 | SAI1_MCLK | GPIO_AD_B1_09 | ALT3
SAI1 | SAI1_MCLK | GPIO_B0_13 | ALT3
SAI1 | SAI1_MCLK | GPIO_SD_B1_03 | ALT3
SAI1 | SAI1_RX_BCLK | GPIO_AD_B1_11 | ALT3
SAI1 | SAI1_RX_BCLK | GPIO_B0_15 | ALT3
SAI1 | SAI1_RX_BCLK | GPIO_SD_B1_05 | ALT3
SAI1 | SAI1_RX_DATA0 | GPIO_AD_B1_12 | ALT3
SAI1 | SAI1_RX_DATA0 | GPIO_B1_00 | ALT3
SAI1 | SAI1_RX_DATA0 | GPIO_SD_B1_06 | ALT3
SAI1 | SAI1_RX_SYNC | GPIO_AD_B1_10 | ALT3
SAI1 | SAI1_RX_SYNC | GPIO_B0_14 | ALT3
SAI1 | SAI1_RX_SYNC | GPIO_SD_B1_04 | ALT3
SAI1 | SAI1_TX_BCLK | GPIO_AD_B1_14 | ALT3
SAI1 | SAI1_TX_BCLK | GPIO_B1_02 | ALT3
SAI1 | SAI1_TX_BCLK | GPIO_SD_B1_08 | ALT3
SAI1 | SAI1_TX_DATA0 | GPIO_AD_B1_13 | ALT3
SAI1 | SAI1_TX_DATA0 | GPIO_B1_01 | ALT3
SAI1 | SAI1_TX_DATA0 | GPIO_SD_B1_07 | ALT3
SAI1 | SAI1_TX_DATA1/SAI1_RX_DATA3 | GPIO_B0_12 | ALT3
SAI1 | SAI1_TX_DATA1/SAI1_RX_DATA3 | GPIO_SD_B1_02 | ALT3
SAI1 | SAI1_TX_DATA2/SAI1_RX_DATA2 | GPIO_B0_11 | ALT3
SAI1 | SAI1_TX_DATA2/SAI1_RX_DATA2 | GPIO_SD_B1_01 | ALT3
SAI1 | SAI1_TX_DATA3/SAI1_RX_DATA1 | GPIO_B0_10 | ALT3
SAI1 | SAI1_TX_DATA3/SAI1_RX_DATA1 | GPIO_SD_B1_00 | ALT3
SAI1 | SAI1_TX_SYNC | GPIO_AD_B1_15 | ALT3
SAI1 | SAI1_TX_SYNC | GPIO_B1_03 | ALT3
SAI1 | SAI1_TX_SYNC | GPIO_SD_B1_09 | ALT3
SAI2 | SAI2_MCLK | GPIO_AD_B0_10 | ALT3
SAI2 | SAI2_MCLK | GPIO_EMC_07 | ALT2
SAI2 | SAI2_RX_BCLK | GPIO_AD_B0_06 | ALT3
SAI2 | SAI2_RX_BCLK | GPIO_EMC_10 | ALT2
SAI2 | SAI2_RX_DATA | GPIO_AD_B0_08 | ALT3
SAI2 | SAI2_RX_DATA | GPIO_EMC_08 | ALT2
SAI2 | SAI2_RX_SYNC | GPIO_AD_B0_07 | ALT3
SAI2 | SAI2_RX_SYNC | GPIO_EMC_09 | ALT2
SAI2 | SAI2_TX_BCLK | GPIO_AD_B0_05 | ALT3
SAI2 | SAI2_TX_BCLK | GPIO_EMC_06 | ALT2
SAI2 | SAI2_TX_DATA | GPIO_AD_B0_09 | ALT3
SAI2 | SAI2_TX_DATA | GPIO_EMC_04 | ALT2
SAI2 | SAI2_TX_SYNC | GPIO_AD_B0_04 | ALT3
SAI2 | SAI2_TX_SYNC | GPIO_EMC_05 | ALT2
SAI3 | SAI3_MCLK | GPIO_EMC_37 | ALT3
SAI3 | SAI3_MCLK | GPIO_SD_B1_04 | ALT8
SAI3 | SAI3_RX_BCLK | GPIO_EMC_35 | ALT3
SAI3 | SAI3_RX_BCLK | GPIO_SD_B1_06 | ALT8
SAI3 | SAI3_RX_DATA | GPIO_EMC_33 | ALT3
SAI3 | SAI3_RX_DATA | GPIO_SD_B1_00 | ALT8
SAI3 | SAI3_RX_SYNC | GPIO_EMC_34 | ALT3
SAI3 | SAI3_RX_SYNC | GPIO_SD_B1_05 | ALT8
SAI3 | SAI3_TX_BCLK | GPIO_EMC_38 | ALT3
SAI3 | SAI3_TX_BCLK | GPIO_SD_B1_03 | ALT8
SAI3 | SAI3_TX_DATA | GPIO_EMC_36 | ALT3
SAI3 | SAI3_TX_DATA | GPIO_SD_B1_01 | ALT8
SAI3 | SAI3_TX_SYNC | GPIO_EMC_39 | ALT3
SAI3 | SAI3_TX_SYNC | GPIO_SD_B1_02 | ALT8
SEMC | SEMC_ADDR00 | GPIO_EMC_09 | ALT0
SEMC | SEMC_ADDR01 | GPIO_EMC_10 | ALT0
SEMC | SEMC_ADDR02 | GPIO_EMC_11 | ALT0
SEMC | SEMC_ADDR03 | GPIO_EMC_12 | ALT0
SEMC | SEMC_ADDR04 | GPIO_EMC_13 | ALT0
SEMC | SEMC_ADDR05 | GPIO_EMC_14 | ALT0
SEMC | SEMC_ADDR06 | GPIO_EMC_15 | ALT0
SEMC | SEMC_ADDR07 | GPIO_EMC_16 | ALT0
SEMC | SEMC_ADDR08 | GPIO_EMC_17 | ALT0
SEMC | SEMC_ADDR09 | GPIO_EMC_18 | ALT0
SEMC | SEMC_ADDR10 | GPIO_EMC_23 | ALT0
SEMC | SEMC_ADDR11 | GPIO_EMC_19 | ALT0
SEMC | SEMC_ADDR12 | GPIO_EMC_20 | ALT0
SEMC | SEMC_BA0 | GPIO_EMC_21 | ALT0
SEMC | SEMC_BA1 | GPIO_EMC_22 | ALT0
SEMC | SEMC_CAS | GPIO_EMC_24 | ALT0
SEMC | SEMC_CKE | GPIO_EMC_27 | ALT0
SEMC | SEMC_CLK | GPIO_EMC_26 | ALT0
SEMC | SEMC_CS0 | GPIO_EMC_29 | ALT0
SEMC | SEMC_CSX0 | GPIO_EMC_41 | ALT0
SEMC | SEMC_CSX1 | GPIO_B0_00 | ALT6
SEMC | SEMC_CSX1 | GPIO_SD_B1_07 | ALT0
SEMC | SEMC_CSX2 | GPIO_B0_01 | ALT6
SEMC | SEMC_CSX2 | GPIO_SD_B1_08 | ALT6
SEMC | SEMC_CSX3 | GPIO_B0_02 | ALT6
SEMC | SEMC_DATA00 | GPIO_EMC_00 | ALT0
SEMC | SEMC_DATA01 | GPIO_EMC_01 | ALT0
SEMC | SEMC_DATA02 | GPIO_EMC_02 | ALT0
SEMC | SEMC_DATA03 | GPIO_EMC_03 | ALT0
SEMC | SEMC_DATA04 | GPIO_EMC_04 | ALT0
SEMC | SEMC_DATA05 | GPIO_EMC_05 | ALT0
SEMC | SEMC_DATA06 | GPIO_EMC_06 | ALT0
SEMC | SEMC_DATA07 | GPIO_EMC_07 | ALT0
SEMC | SEMC_DATA08 | GPIO_EMC_30 | ALT0
SEMC | SEMC_DATA09 | GPIO_EMC_31 | ALT0
SEMC | SEMC_DATA10 | GPIO_EMC_32 | ALT0
SEMC | SEMC_DATA11 | GPIO_EMC_33 | ALT0
SEMC | SEMC_DATA12 | GPIO_EMC_34 | ALT0
SEMC | SEMC_DATA13 | GPIO_EMC_35 | ALT0
SEMC | SEMC_DATA14 | GPIO_EMC_36 | ALT0
SEMC | SEMC_DATA15 | GPIO_EMC_37 | ALT0
SEMC | SEMC_DM0 | GPIO_EMC_08 | ALT0
SEMC | SEMC_DM1 | GPIO_EMC_38 | ALT0
SEMC | SEMC_DQS | GPIO_EMC_39 | ALT0
SEMC | SEMC_RAS | GPIO_EMC_25 | ALT0
SEMC | SEMC_RDY | GPIO_EMC_40 | ALT0
SEMC | SEMC_WE | GPIO_EMC_28 | ALT0
SNVS | SNVS_PMIC_ON_REQ | PMIC_ON_REQ | ALT0
SNVS | SNVS_VIO_5_B | GPIO_EMC_19 | ALT6
SNVS | SNVS_VIO_5_CTL | GPIO_EMC_18 | ALT6
SPDIF | SPDIF_EXT_CLK | GPIO_AD_B1_07 | ALT3
SPDIF | SPDIF_IN | GPIO_AD_B1_03 | ALT3
SPDIF | SPDIF_IN | GPIO_EMC_16 | ALT3
SPDIF | SPDIF_LOCK | GPIO_AD_B1_06 | ALT3
SPDIF | SPDIF_OUT | GPIO_AD_B1_02 | ALT3
SPDIF | SPDIF_OUT | GPIO_AD_B1_05 | ALT3
SPDIF | SPDIF_OUT | GPIO_EMC_15 | ALT3
SPDIF | SPDIF_SR_CLK | GPIO_AD_B1_04 | ALT3
SRC_RESET_B | SRC_BOOT_MODE0 | GPIO_AD_B0_04 | ALT0
SRC_RESET_B | SRC_BOOT_MODE1 | GPIO_AD_B0_05 | ALT0
SRC_RESET_B | SRC_BT_CFG00 | GPIO_B0_04 | ALT6
SRC_RESET_B | SRC_BT_CFG01 | GPIO_B0_05 | ALT6
SRC_RESET_B | SRC_BT_CFG02 | GPIO_B0_06 | ALT6
SRC_RESET_B | SRC_BT_CFG03 | GPIO_B0_07 | ALT6
SRC_RESET_B | SRC_BT_CFG04 | GPIO_B0_08 | ALT6
SRC_RESET_B | SRC_BT_CFG05 | GPIO_B0_09 | ALT6
SRC_RESET_B | SRC_BT_CFG06 | GPIO_B0_10 | ALT6
SRC_RESET_B | SRC_BT_CFG07 | GPIO_B0_11 | ALT6
SRC_RESET_B | SRC_BT_CFG08 | GPIO_B0_12 | ALT6
SRC_RESET_B | SRC_BT_CFG09 | GPIO_B0_13 | ALT6
SRC_RESET_B | SRC_BT_CFG10 | GPIO_B0_14 | ALT6
SRC_RESET_B | SRC_BT_CFG11 | GPIO_B0_15 | ALT6
SWD | SWD_CLK | GPIO_AD_B0_07 | ALT0
SWD | SWD_DIO | GPIO_AD_B0_06 | ALT0
TMR1 (QUAD TIMER) | TMR1_TIMER0 | GPIO_B0_00 | ALT1
TMR1 (QUAD TIMER) | TMR1_TIMER1 | GPIO_B0_01 | ALT1
TMR1 (QUAD TIMER) | TMR1_TIMER2 | GPIO_B0_02 | ALT1
TMR1 (QUAD TIMER) | TMR1_TIMER3 | GPIO_B1_08 | ALT1
TMR2 (QUAD TIMER) | TMR2_TIMER0 | GPIO_B0_03 | ALT1
TMR2 (QUAD TIMER) | TMR2_TIMER0 | GPIO_EMC_19 | ALT4
TMR2 (QUAD TIMER) | TMR2_TIMER1 | GPIO_B0_04 | ALT1
TMR2 (QUAD TIMER) | TMR2_TIMER1 | GPIO_EMC_20 | ALT4
TMR2 (QUAD TIMER) | TMR2_TIMER2 | GPIO_B0_05 | ALT1
TMR2 (QUAD TIMER) | TMR2_TIMER2 | GPIO_EMC_21 | ALT4
TMR2 (QUAD TIMER) | TMR2_TIMER3 | GPIO_B1_09 | ALT1
TMR2 (QUAD TIMER) | TMR2_TIMER3 | GPIO_EMC_22 | ALT4
TMR3 (QUAD TIMER) | TMR3_TIMER0 | GPIO_AD_B1_00 | ALT1
TMR3 (QUAD TIMER) | TMR3_TIMER0 | GPIO_B0_06 | ALT1
TMR3 (QUAD TIMER) | TMR3_TIMER0 | GPIO_EMC_15 | ALT4
TMR3 (QUAD TIMER) | TMR3_TIMER1 | GPIO_AD_B1_01 | ALT1
TMR3 (QUAD TIMER) | TMR3_TIMER1 | GPIO_B0_07 | ALT1
TMR3 (QUAD TIMER) | TMR3_TIMER1 | GPIO_EMC_16 | ALT4
TMR3 (QUAD TIMER) | TMR3_TIMER2 | GPIO_AD_B1_02 | ALT1
TMR3 (QUAD TIMER) | TMR3_TIMER2 | GPIO_B0_08 | ALT1
TMR3 (QUAD TIMER) | TMR3_TIMER2 | GPIO_EMC_17 | ALT4
TMR3 (QUAD TIMER) | TMR3_TIMER3 | GPIO_AD_B1_03 | ALT1
TMR3 (QUAD TIMER) | TMR3_TIMER3 | GPIO_B1_10 | ALT1
TMR3 (QUAD TIMER) | TMR3_TIMER3 | GPIO_EMC_18 | ALT4
TMR4 (QUAD TIMER) | TMR4_TIMER0 | GPIO_B0_09 | ALT1
TMR4 (QUAD TIMER) | TMR4_TIMER1 | GPIO_B0_10 | ALT1
TMR4 (QUAD TIMER) | TMR4_TIMER2 | GPIO_B0_11 | ALT1
TMR4 (QUAD TIMER) | TMR4_TIMER3 | GPIO_B1_11 | ALT1
USB | USB_OTG1_ID | GPIO_AD_B0_01 | ALT3
USB | USB_OTG1_ID | GPIO_AD_B1_02 | ALT0
USB | USB_OTG1_OC | GPIO_AD_B0_03 | ALT3
USB | USB_OTG1_OC | GPIO_AD_B1_03 | ALT0
USB | USB_OTG1_PWR | GPIO_AD_B0_02 | ALT3
USB | USB_OTG1_PWR | GPIO_AD_B1_01 | ALT0
USB | USB_OTG2_ID | GPIO_AD_B0_00 | ALT3
USB | USB_OTG2_ID | GPIO_AD_B1_00 | ALT0
USB | USB_OTG2_OC | GPIO_AD_B0_14 | ALT0
USB | USB_OTG2_OC | GPIO_EMC_40 | ALT3
USB | USB_OTG2_PWR | GPIO_AD_B0_15 | ALT0
USB | USB_OTG2_PWR | GPIO_EMC_41 | ALT3
USB PHY 1 | USB_PHY1_TSTI_TX_DN | GPIO_EMC_02 | ALT6
USB PHY 1 | USB_PHY1_TSTI_TX_DP | GPIO_EMC_08 | ALT6
USB PHY 1 | USB_PHY1_TSTI_TX_EN | GPIO_EMC_09 | ALT6
USB PHY 1 | USB_PHY1_TSTI_TX_HIZ | GPIO_EMC_10 | ALT6
USB PHY 1 | USB_PHY1_TSTI_TX_HS_MODE | GPIO_EMC_01 | ALT6
USB PHY 1 | USB_PHY1_TSTI_TX_LS_MODE | GPIO_EMC_00 | ALT6
USB PHY 1 | USB_PHY1_TSTO_PLL_CLK20DIV | GPIO_EMC_12 | ALT6
USB PHY 1 | USB_PHY1_TSTO_RX_DISCON_DET | GPIO_EMC_04 | ALT6
USB PHY 1 | USB_PHY1_TSTO_RX_FS_RXD | GPIO_EMC_07 | ALT6
USB PHY 1 | USB_PHY1_TSTO_RX_HS_RXD | GPIO_EMC_05 | ALT6
USB PHY 1 | USB_PHY1_TSTO_RX_SQUELCH | GPIO_EMC_03 | ALT6
USB PHY 2 | USB_PHY2_TSTO_PLL_CLK20DIV | GPIO_EMC_13 | ALT6
USB PHY 2 | USB_PHY2_TSTO_RX_DISCON_DET | GPIO_EMC_15 | ALT6
USB PHY 2 | USB_PHY2_TSTO_RX_FS_RXD | GPIO_EMC_06 | ALT6
USB PHY 2 | USB_PHY2_TSTO_RX_HS_RXD | GPIO_EMC_11 | ALT6
USB PHY 2 | USB_PHY2_TSTO_RX_SQUELCH | GPIO_EMC_14 | ALT6
USDHC1 | USDHC1_CD_B | GPIO_AD_B1_02 | ALT6
USDHC1 | USDHC1_CD_B | GPIO_B1_12 | ALT6
USDHC1 | USDHC1_CD_B | GPIO_EMC_35 | ALT6
USDHC1 | USDHC1_CLK | GPIO_SD_B0_01 | ALT0
USDHC1 | USDHC1_CMD | GPIO_SD_B0_00 | ALT0
USDHC1 | USDHC1_DATA0 | GPIO_SD_B0_02 | ALT0
USDHC1 | USDHC1_DATA1 | GPIO_SD_B0_03 | ALT0
USDHC1 | USDHC1_DATA2 | GPIO_SD_B0_04 | ALT0
USDHC1 | USDHC1_DATA3 | GPIO_SD_B0_05 | ALT0
USDHC1 | USDHC1_RESET_B | GPIO_AD_B0_00 | ALT6
USDHC1 | USDHC1_RESET_B | GPIO_B1_15 | ALT6
USDHC1 | USDHC1_RESET_B | GPIO_EMC_33 | ALT2
USDHC1 | USDHC1_VSELECT | GPIO_AD_B1_01 | ALT6
USDHC1 | USDHC1_VSELECT | GPIO_B1_14 | ALT6
USDHC1 | USDHC1_VSELECT | GPIO_EMC_34 | ALT2
USDHC1 | USDHC1_VSELECT | GPIO_EMC_41 | ALT6
USDHC1 | USDHC1_WP | GPIO_AD_B1_00 | ALT6
USDHC1 | USDHC1_WP | GPIO_B1_13 | ALT6
USDHC1 | USDHC1_WP | GPIO_EMC_12 | ALT3
USDHC1 | USDHC1_WP | GPIO_EMC_36 | ALT6
USDHC2 | USDHC2_CD_B | GPIO_AD_B1_03 | ALT6
USDHC2 | USDHC2_CD_B | GPIO_EMC_39 | ALT6
USDHC2 | USDHC2_CLK | GPIO_AD_B1_09 | ALT6
USDHC2 | USDHC2_CLK | GPIO_SD_B1_04 | ALT0
USDHC2 | USDHC2_CMD | GPIO_AD_B1_08 | ALT6
USDHC2 | USDHC2_CMD | GPIO_SD_B1_05 | ALT0
USDHC2 | USDHC2_DATA0 | GPIO_AD_B1_04 | ALT6
USDHC2 | USDHC2_DATA0 | GPIO_SD_B1_03 | ALT0
USDHC2 | USDHC2_DATA1 | GPIO_AD_B1_05 | ALT6
USDHC2 | USDHC2_DATA1 | GPIO_SD_B1_02 | ALT0
USDHC2 | USDHC2_DATA2 | GPIO_AD_B1_06 | ALT6
USDHC2 | USDHC2_DATA2 | GPIO_SD_B1_01 | ALT0
USDHC2 | USDHC2_DATA3 | GPIO_AD_B1_07 | ALT6
USDHC2 | USDHC2_DATA3 | GPIO_SD_B1_00 | ALT0
USDHC2 | USDHC2_DATA4 | GPIO_AD_B1_12 | ALT6
USDHC2 | USDHC2_DATA4 | GPIO_SD_B1_08 | ALT0
USDHC2 | USDHC2_DATA5 | GPIO_AD_B1_13 | ALT6
USDHC2 | USDHC2_DATA5 | GPIO_SD_B1_09 | ALT0
USDHC2 | USDHC2_DATA6 | GPIO_AD_B1_14 | ALT6
USDHC2 | USDHC2_DATA6 | GPIO_SD_B1_10 | ALT0
USDHC2 | USDHC2_DATA7 | GPIO_AD_B1_15 | ALT6
USDHC2 | USDHC2_DATA7 | GPIO_SD_B1_11 | ALT0
USDHC2 | USDHC2_RESET_B | GPIO_AD_B1_11 | ALT6
USDHC2 | USDHC2_RESET_B | GPIO_EMC_11 | ALT3
USDHC2 | USDHC2_RESET_B | GPIO_EMC_40 | ALT6
USDHC2 | USDHC2_RESET_B | GPIO_SD_B1_06 | ALT0
USDHC2 | USDHC2_VSELECT | GPIO_EMC_38 | ALT6
USDHC2 | USDHC2_WP | GPIO_AD_B1_10 | ALT6
USDHC2 | USDHC2_WP | GPIO_EMC_37 | ALT6
WDOG1 | WDOG1_ANY | GPIO_AD_B0_14 | ALT7
WDOG1 | WDOG1_B | GPIO_AD_B0_11 | ALT3
WDOG1 | WDOG1_B | GPIO_AD_B1_00 | ALT4
WDOG1 | WDOG1_B | GPIO_AD_B1_10 | ALT1
WDOG1 | WDOG1_B | GPIO_B1_13 | ALT0
WDOG1 | WDOG1_B | GPIO_EMC_39 | ALT4
WDOG1 | WDOG1_RESET_B_DEB | GPIO_AD_B0_15 | ALT7
WDOG2 | WDOG2_B | GPIO_AD_B0_12 | ALT3
WDOG2 | WDOG2_RESET_B_DEB | GPIO_B0_03 | ALT6
XBAR1 | XBAR_INOUT02 | GPIO_B1_14 | ALT3
XBAR1 | XBAR_INOUT02 | GPIO_EMC_00 | ALT3
XBAR1 | XBAR_INOUT03 | GPIO_B1_15 | ALT3
XBAR1 | XBAR_INOUT03 | GPIO_EMC_01 | ALT3
XBAR1 | XBAR_INOUT04 | GPIO_EMC_02 | ALT3
XBAR1 | XBAR_INOUT04 | GPIO_SD_B0_00 | ALT3
XBAR1 | XBAR_INOUT05 | GPIO_EMC_03 | ALT3
XBAR1 | XBAR_INOUT05 | GPIO_SD_B0_01 | ALT3
XBAR1 | XBAR_INOUT06 | GPIO_EMC_04 | ALT3
XBAR1 | XBAR_INOUT06 | GPIO_SD_B0_02 | ALT3
XBAR1 | XBAR_INOUT07 | GPIO_EMC_05 | ALT3
XBAR1 | XBAR_INOUT07 | GPIO_SD_B0_03 | ALT3
XBAR1 | XBAR_INOUT08 | GPIO_EMC_06 | ALT3
XBAR1 | XBAR_INOUT08 | GPIO_SD_B0_04 | ALT3
XBAR1 | XBAR_INOUT09 | GPIO_EMC_07 | ALT3
XBAR1 | XBAR_INOUT09 | GPIO_SD_B0_05 | ALT3
XBAR1 | XBAR_INOUT10 | GPIO_B0_12 | ALT1
XBAR1 | XBAR_INOUT11 | GPIO_B0_13 | ALT1
XBAR1 | XBAR_INOUT12 | GPIO_B0_14 | ALT1
XBAR1 | XBAR_INOUT13 | GPIO_B0_15 | ALT1
XBAR1 | XBAR_INOUT14 | GPIO_AD_B0_00 | ALT1
XBAR1 | XBAR_INOUT14 | GPIO_B1_00 | ALT1
XBAR1 | XBAR_INOUT15 | GPIO_AD_B0_01 | ALT1
XBAR1 | XBAR_INOUT15 | GPIO_B1_01 | ALT1
XBAR1 | XBAR_INOUT16 | GPIO_AD_B0_02 | ALT1
XBAR1 | XBAR_INOUT16 | GPIO_B1_02 | ALT1
XBAR1 | XBAR_INOUT17 | GPIO_AD_B0_03 | ALT1
XBAR1 | XBAR_INOUT17 | GPIO_AD_B0_05 | ALT6
XBAR1 | XBAR_INOUT17 | GPIO_B1_03 | ALT1
XBAR1 | XBAR_INOUT17 | GPIO_EMC_08 | ALT3
XBAR1 | XBAR_INOUT18 | GPIO_AD_B0_06 | ALT6
XBAR1 | XBAR_INOUT18 | GPIO_EMC_35 | ALT1
XBAR1 | XBAR_INOUT19 | GPIO_AD_B0_07 | ALT6
XBAR1 | XBAR_INOUT19 | GPIO_EMC_14 | ALT1
XBAR1 | XBAR_INOUT20 | GPIO_AD_B0_08 | ALT6
XBAR1 | XBAR_INOUT20 | GPIO_EMC_15 | ALT1
XBAR1 | XBAR_INOUT21 | GPIO_AD_B0_09 | ALT6
XBAR1 | XBAR_INOUT21 | GPIO_EMC_16 | ALT1
XBAR1 | XBAR_INOUT22 | GPIO_AD_B0_10 | ALT6
XBAR1 | XBAR_INOUT22 | GPIO_EMC_36 | ALT1
XBAR1 | XBAR_INOUT23 | GPIO_AD_B0_11 | ALT6
XBAR1 | XBAR_INOUT23 | GPIO_EMC_37 | ALT1
XBAR1 | XBAR_INOUT24 | GPIO_AD_B0_14 | ALT1
XBAR1 | XBAR_INOUT24 | GPIO_EMC_12 | ALT1
XBAR1 | XBAR_INOUT25 | GPIO_AD_B0_15 | ALT1
XBAR1 | XBAR_INOUT25 | GPIO_EMC_13 | ALT1
XTALOSC | XTALI | XTALI | No Muxing
XTALOSC | XTALO | XTALO | No Muxing
