bjorend/pertexus/board/plots/pertec_arduino_adapter-B_Silkscreen.pdf

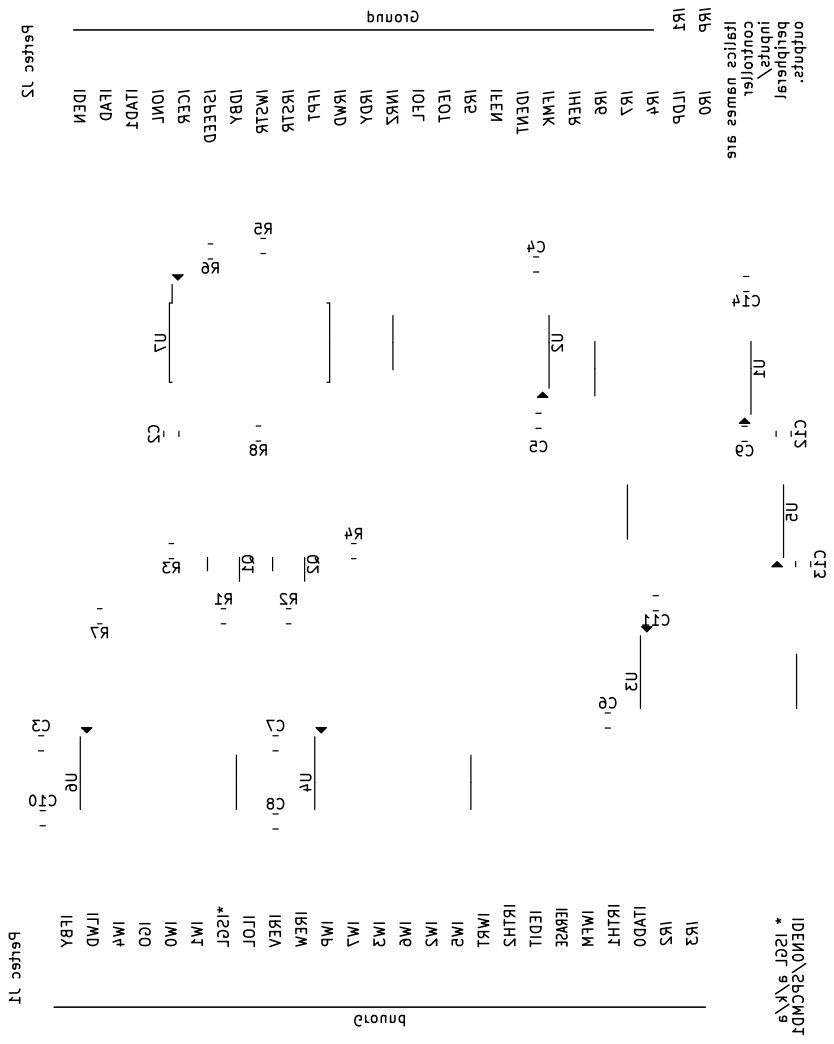
[picture p1: page 1]

* ISGL a/k/a IDEN0/SPCMD1 IFAD INRZ IEDIT IW3 IR2 IWP ISPEED IW2 *ISGL Ground IGO IW7 IR4 Ground IONL IR3 IDEN IW0 IW1 IREVPertec J1 IOFL Italics names are controller inputs/ peripheral outputs. IWFM IDBY IWSTR IEOT Pertec J2 IR1 IR0 ITAD0 ILDP ILOL IRWD IR6 IRTH2 IRTH1 IW4 IFBY IR7 IWRT IRSTR IR5 IFEN IREWIW6 ILWD ITAD1 IRP IFPT IDENT IW5 ICER IERASE IRDY IFMK IHER
