bjorend/pertexus/board/plots/pertec_arduino_adapter-B_Cu.pdf

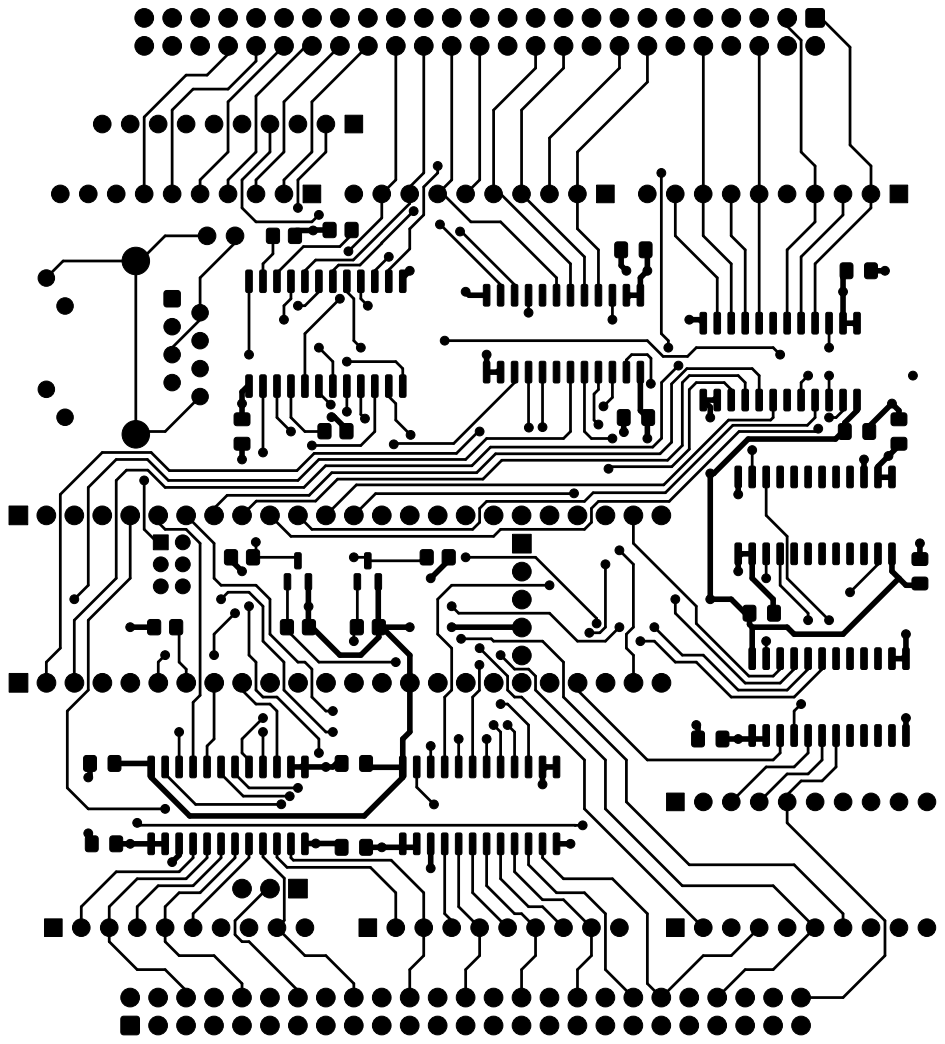
[picture p2: page 1]
