bjorend/pertexus/board/plots/pertec_arduino_adapter-B_Mask.pdf

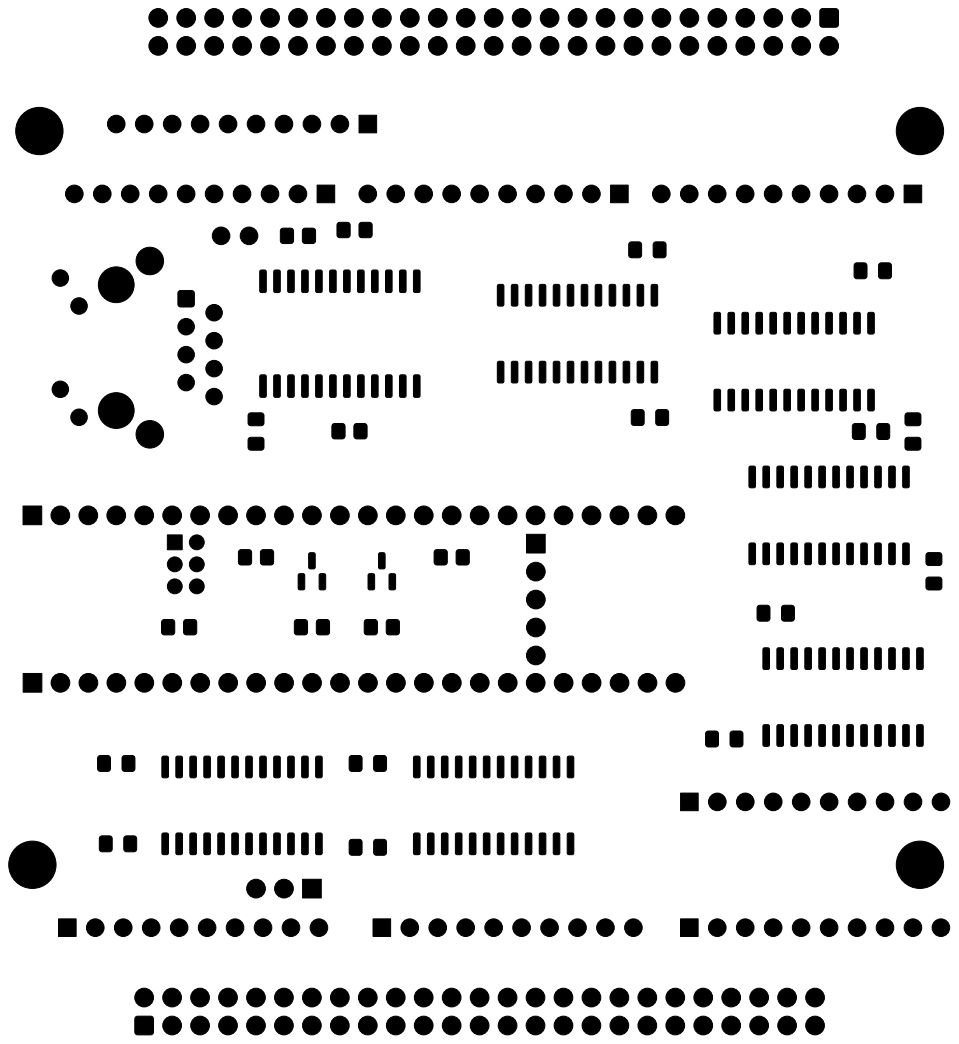
[picture p3: page 1]
