bjorend/pertexus/board/plots/pertec_arduino_adapter-B_Paste.pdf

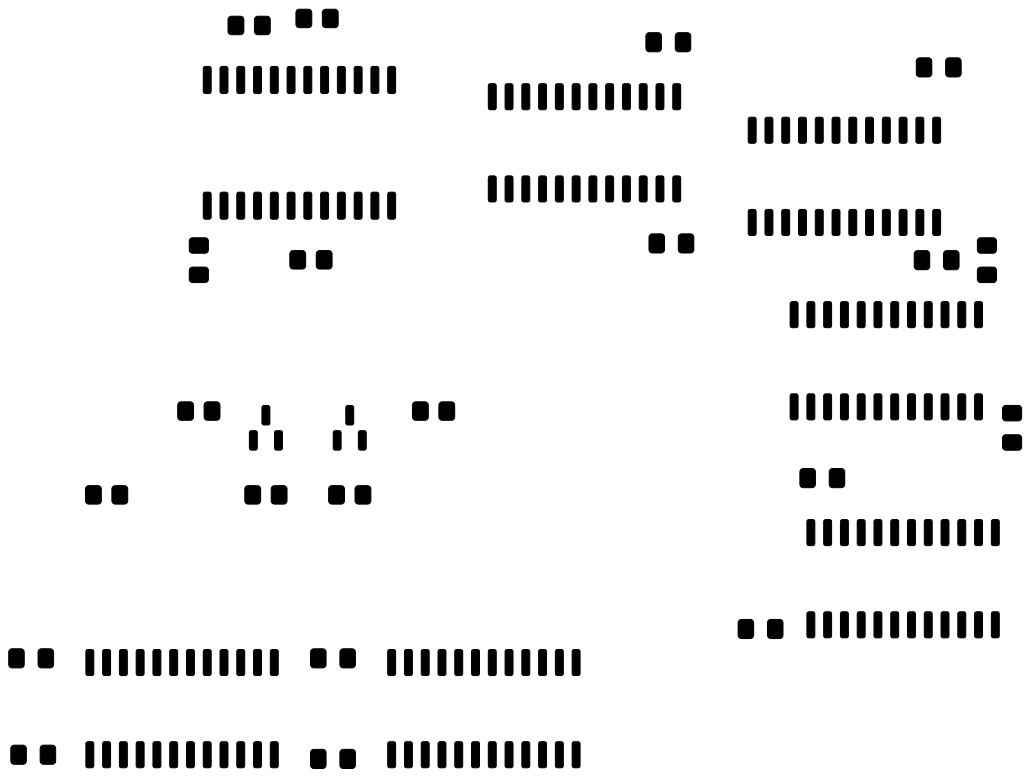
[picture p4: page 1]
