bjorend/pertexus/board/plots/pertec_arduino_adapter-F_Cu.pdf

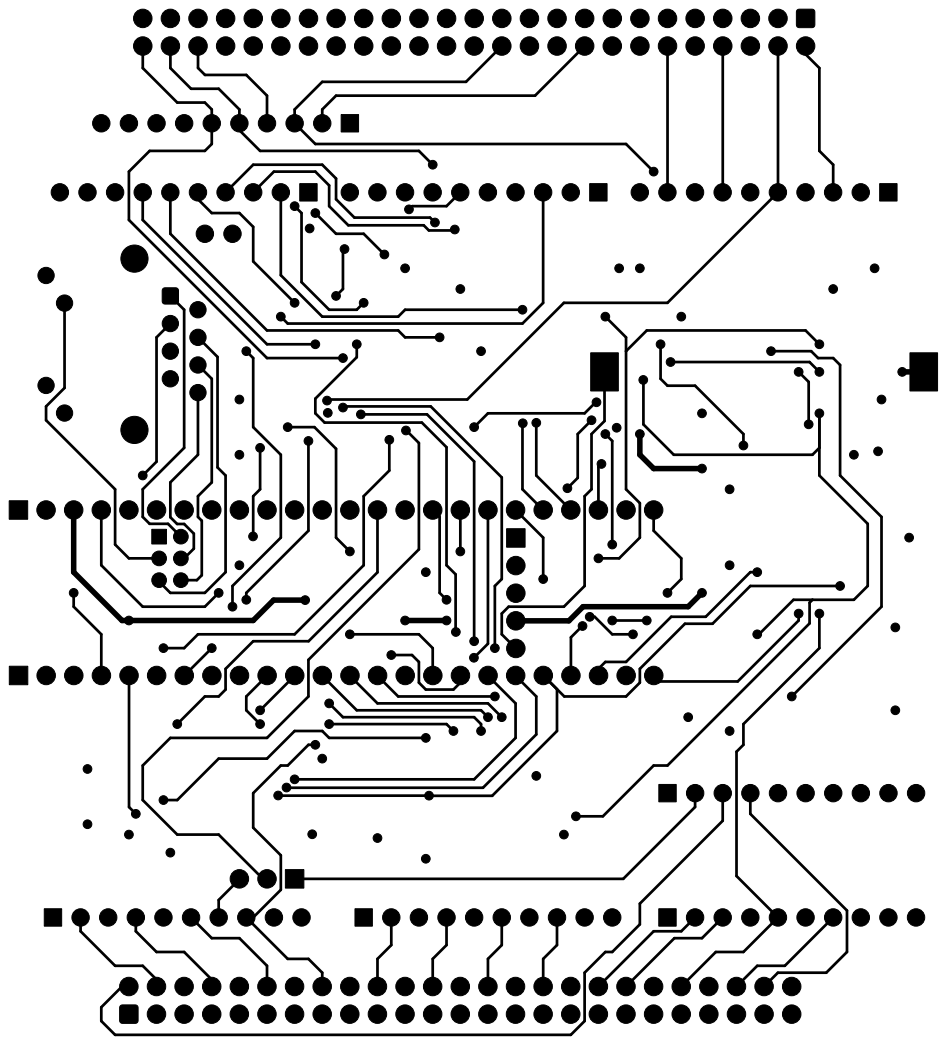
[picture p5: page 1]
