bjorend/pertexus/board/plots/pertec_arduino_adapter-F_Mask.pdf

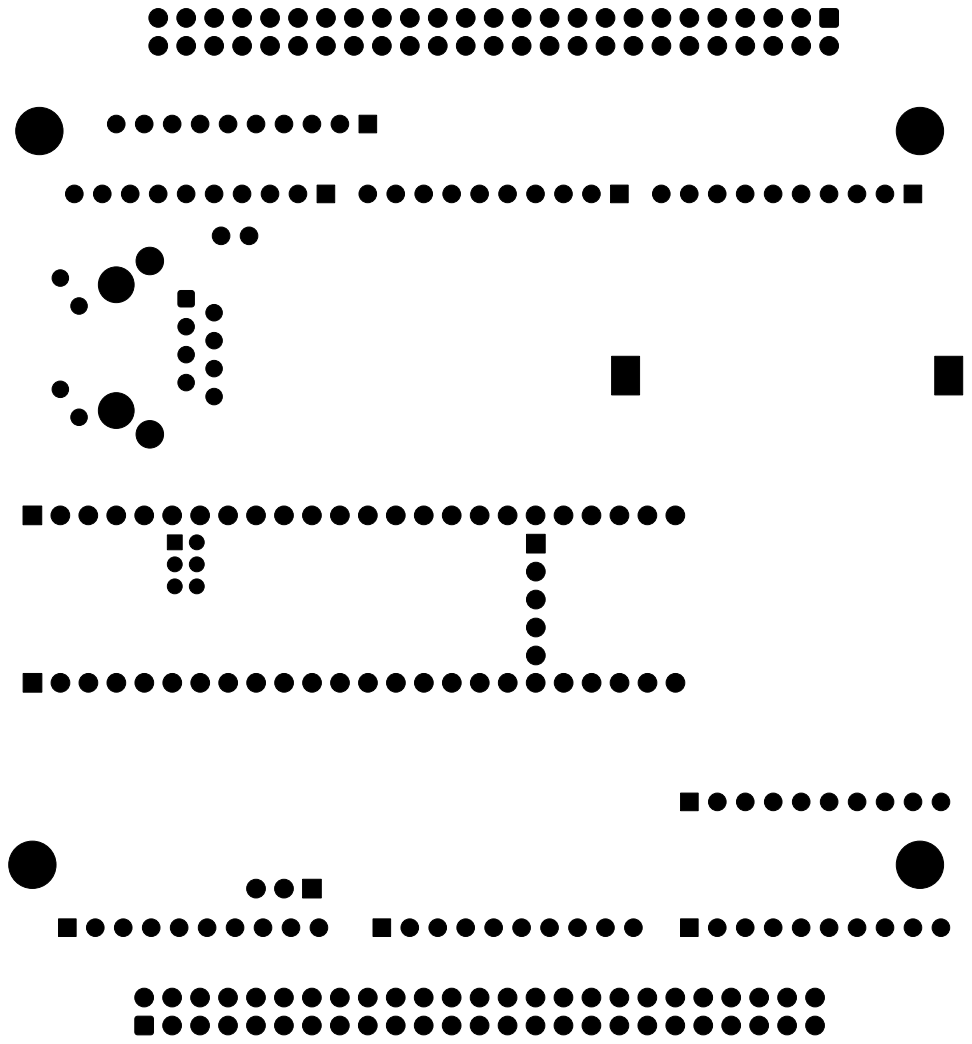
[picture p6: page 1]
