bjorend/pertexus/board/plots/pertec_arduino_adapter-F_Silkscreen.pdf

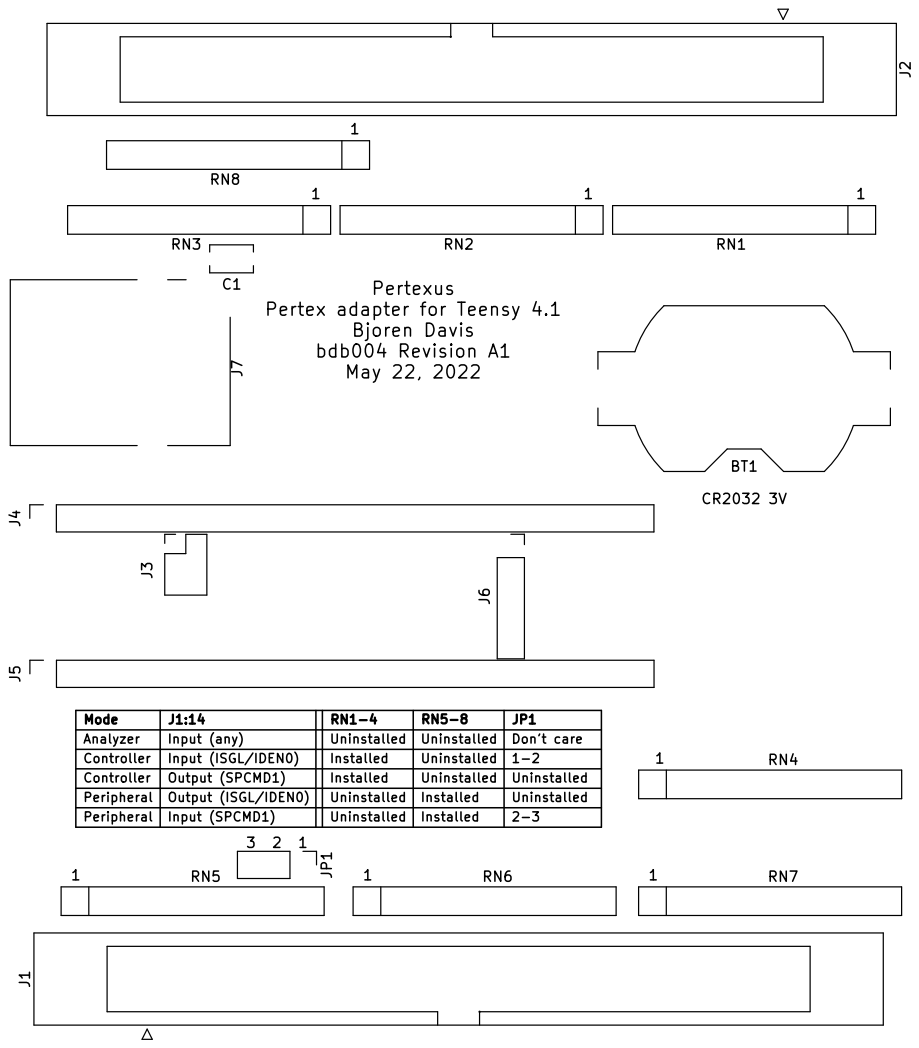
[picture p7: page 1]

Bjoren Davis bdb004 Revision A1 May 22, 2022

Input (ISGL/IDEN0) Controller J1:14 | Uninstalled Analyzer | Don't care 1-2 Output (ISGL/IDEN0)

Input (any) | Installed RN1-4 | JP1

Uninstalled Uninstalled 3
