bjorend/pertexus/board/plots/pertec_arduino_adapter-In1_Cu.pdf

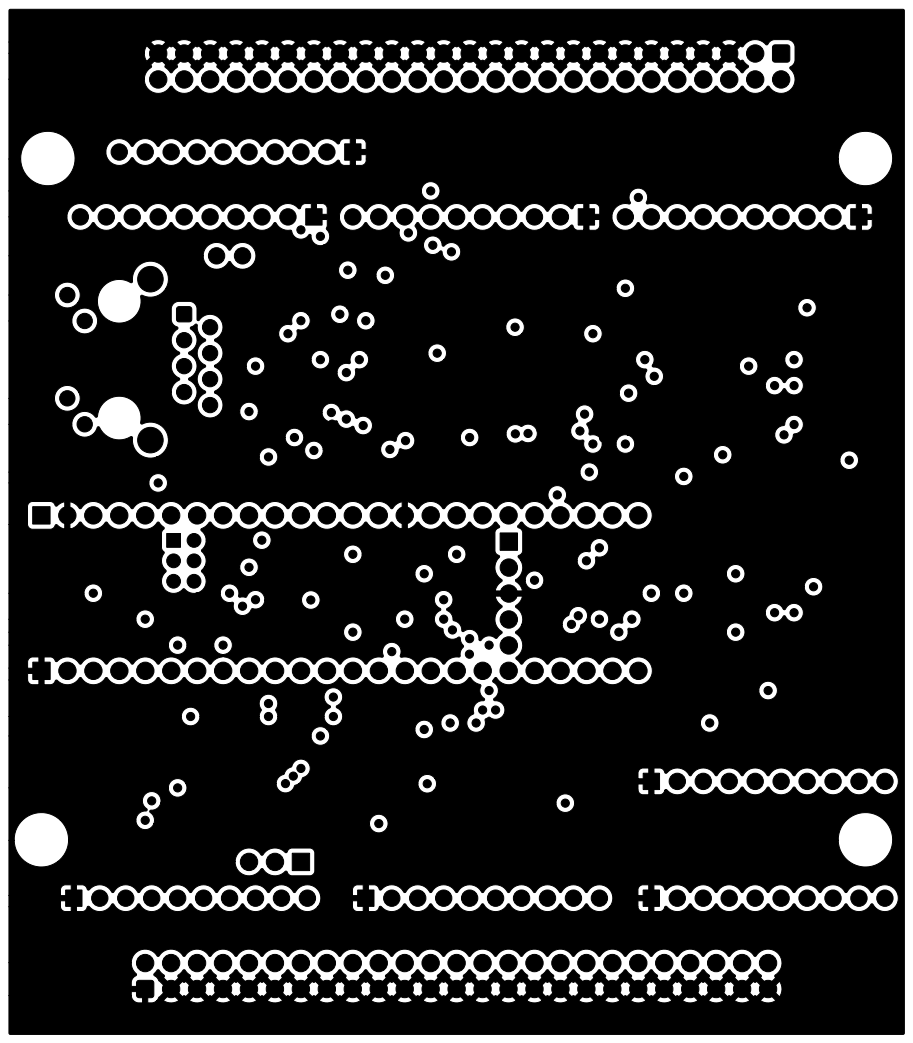
[picture p8: page 1]
