bjorend/pertexus/board/plots/pertec_arduino_adapter-In2_Cu.pdf

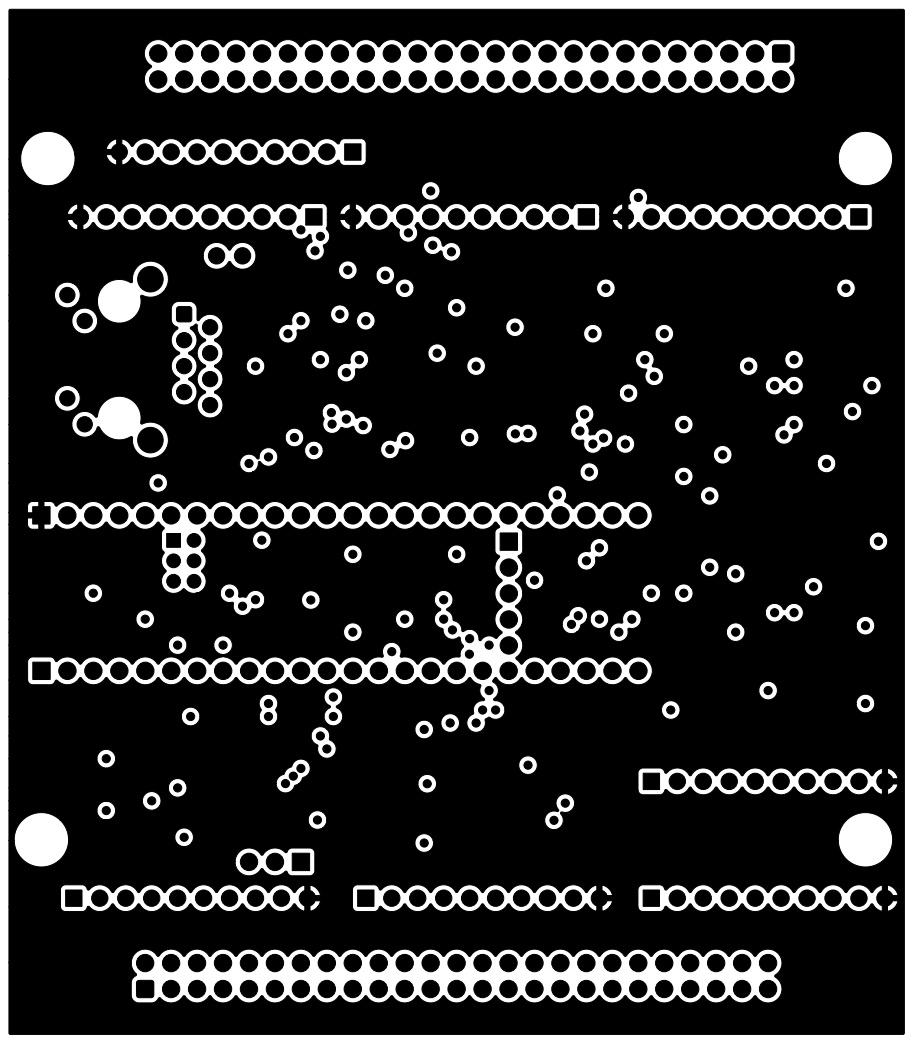
[picture p9: page 1]
