bjorend/pertexus/board/pertec_arduino_adapter.kicad_pcb

## KiCad design board/pertec_arduino_adapter.kicad_pcb (2022-05-22)

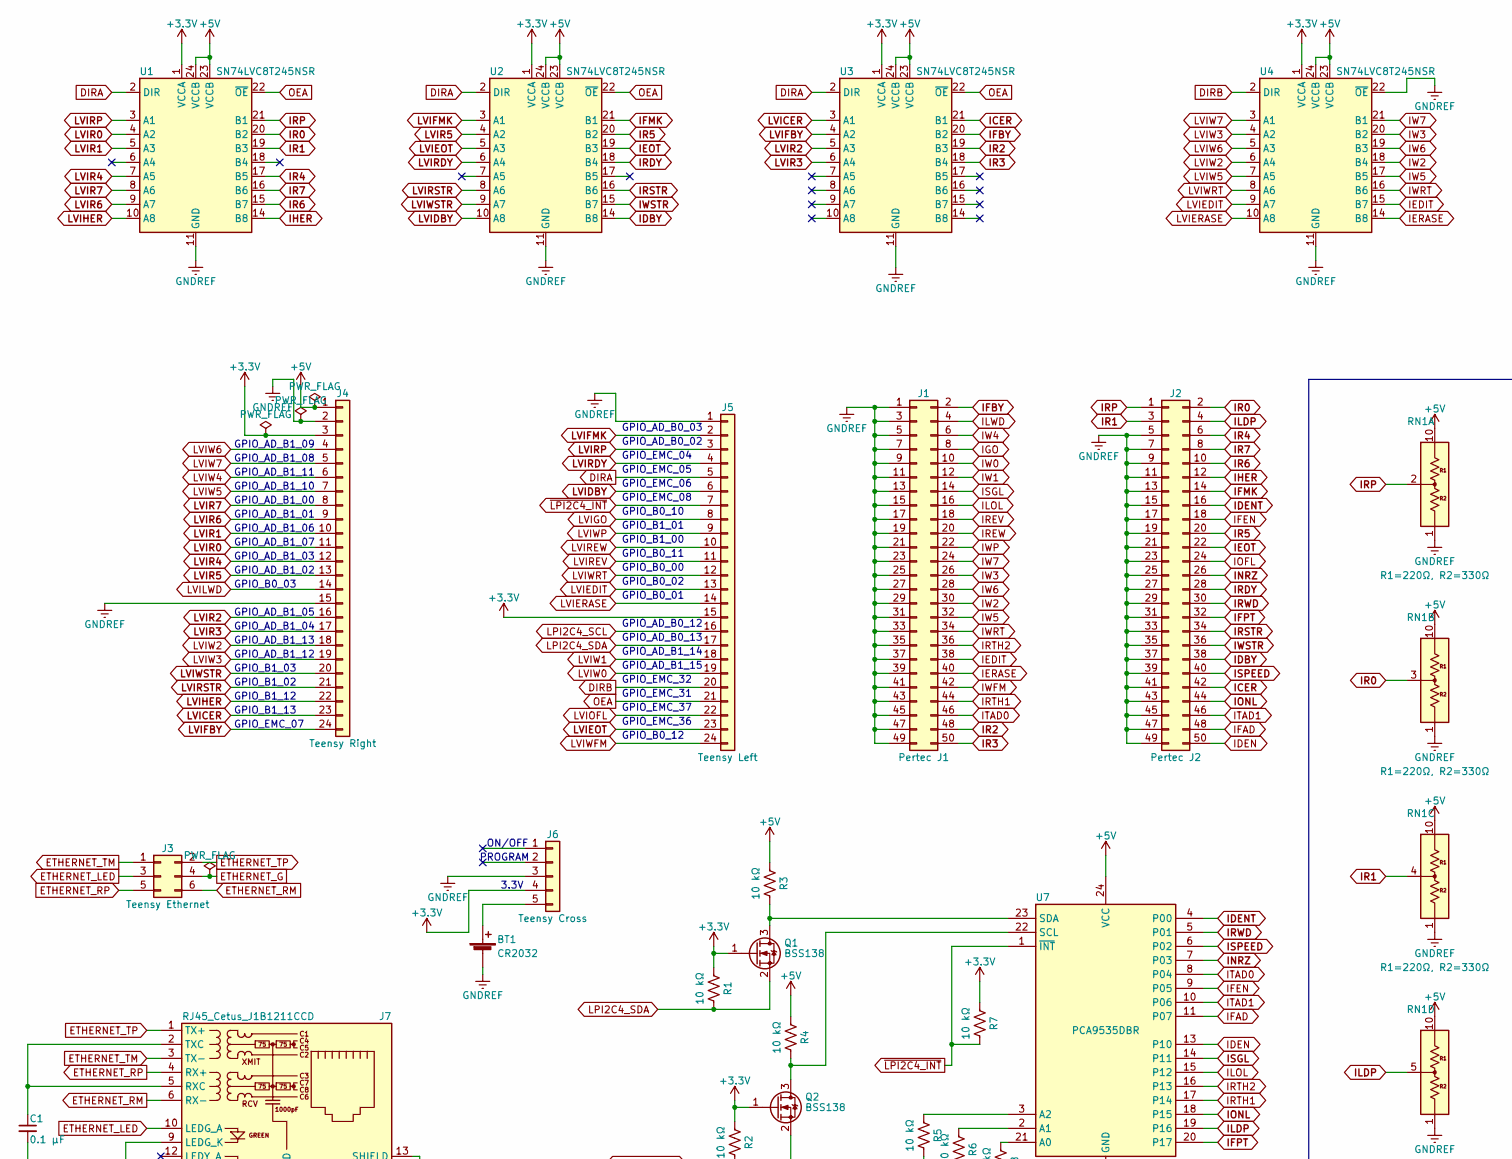
[picture p10: schematic pertec_arduino_adapter.kicad_sch, Pertexus: A Teensy 4.1 (Arduino) Pertex Interface (bdb004), part in row 1, column 1]

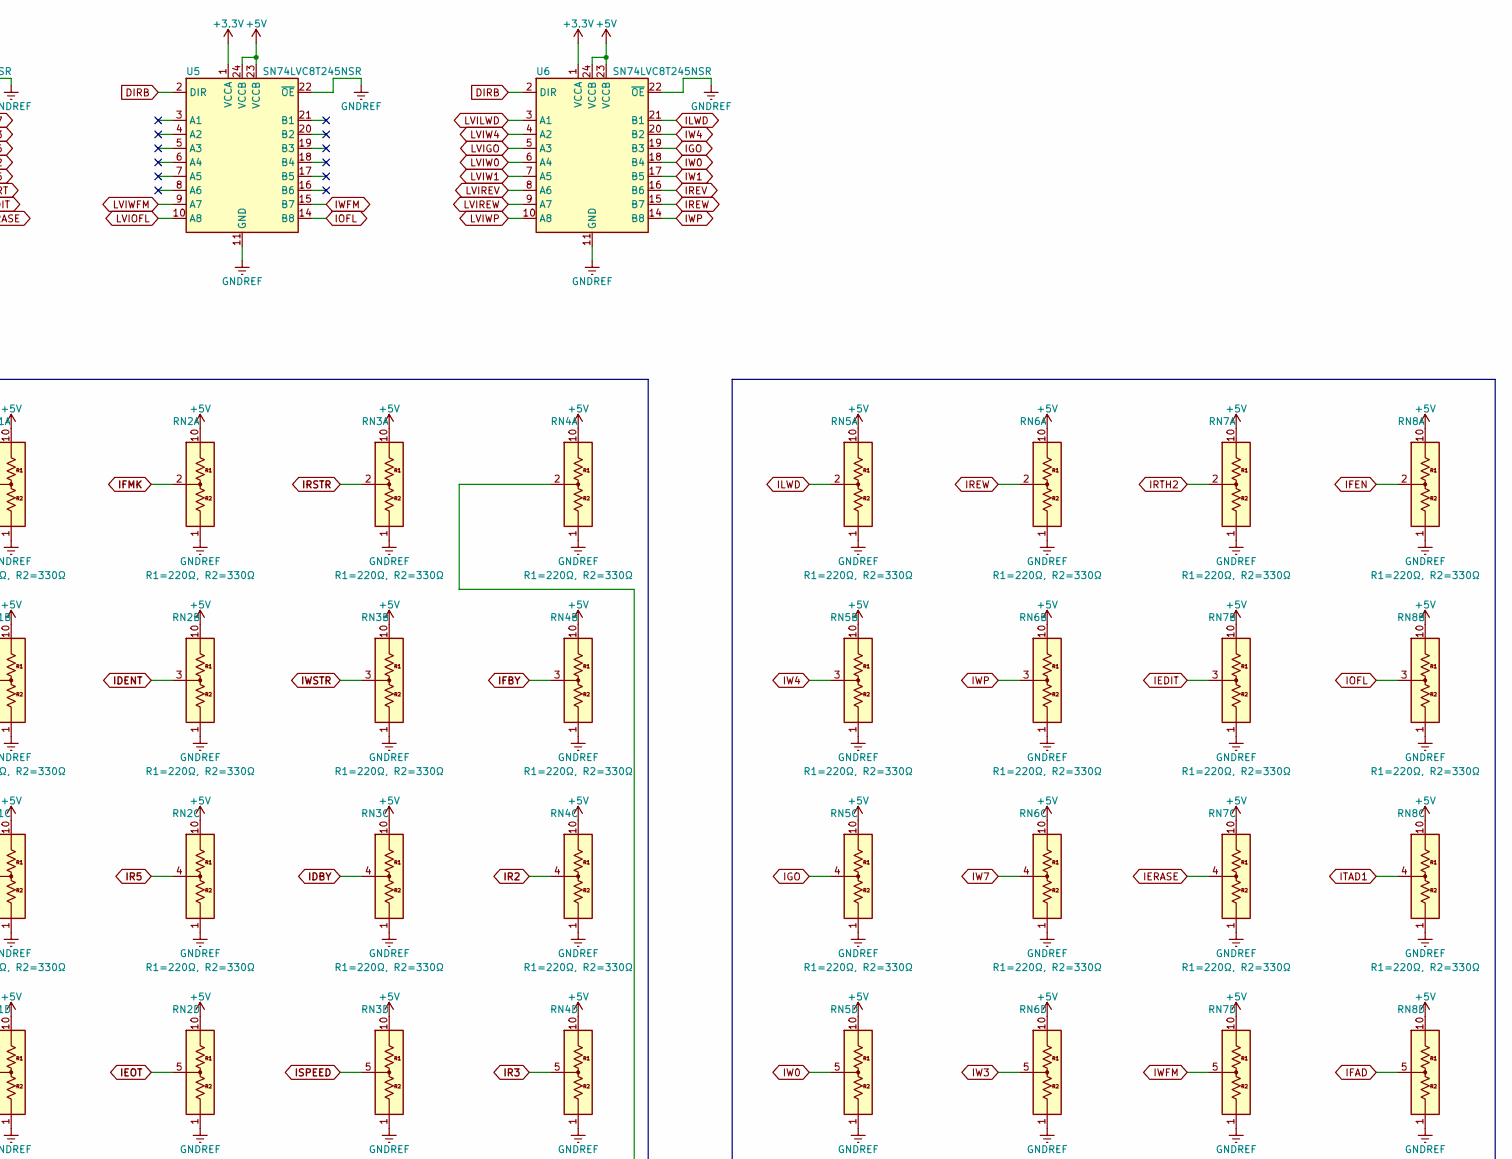
[picture p11: schematic pertec_arduino_adapter.kicad_sch, Pertexus: A Teensy 4.1 (Arduino) Pertex Interface (bdb004), part in row 1, column 2]

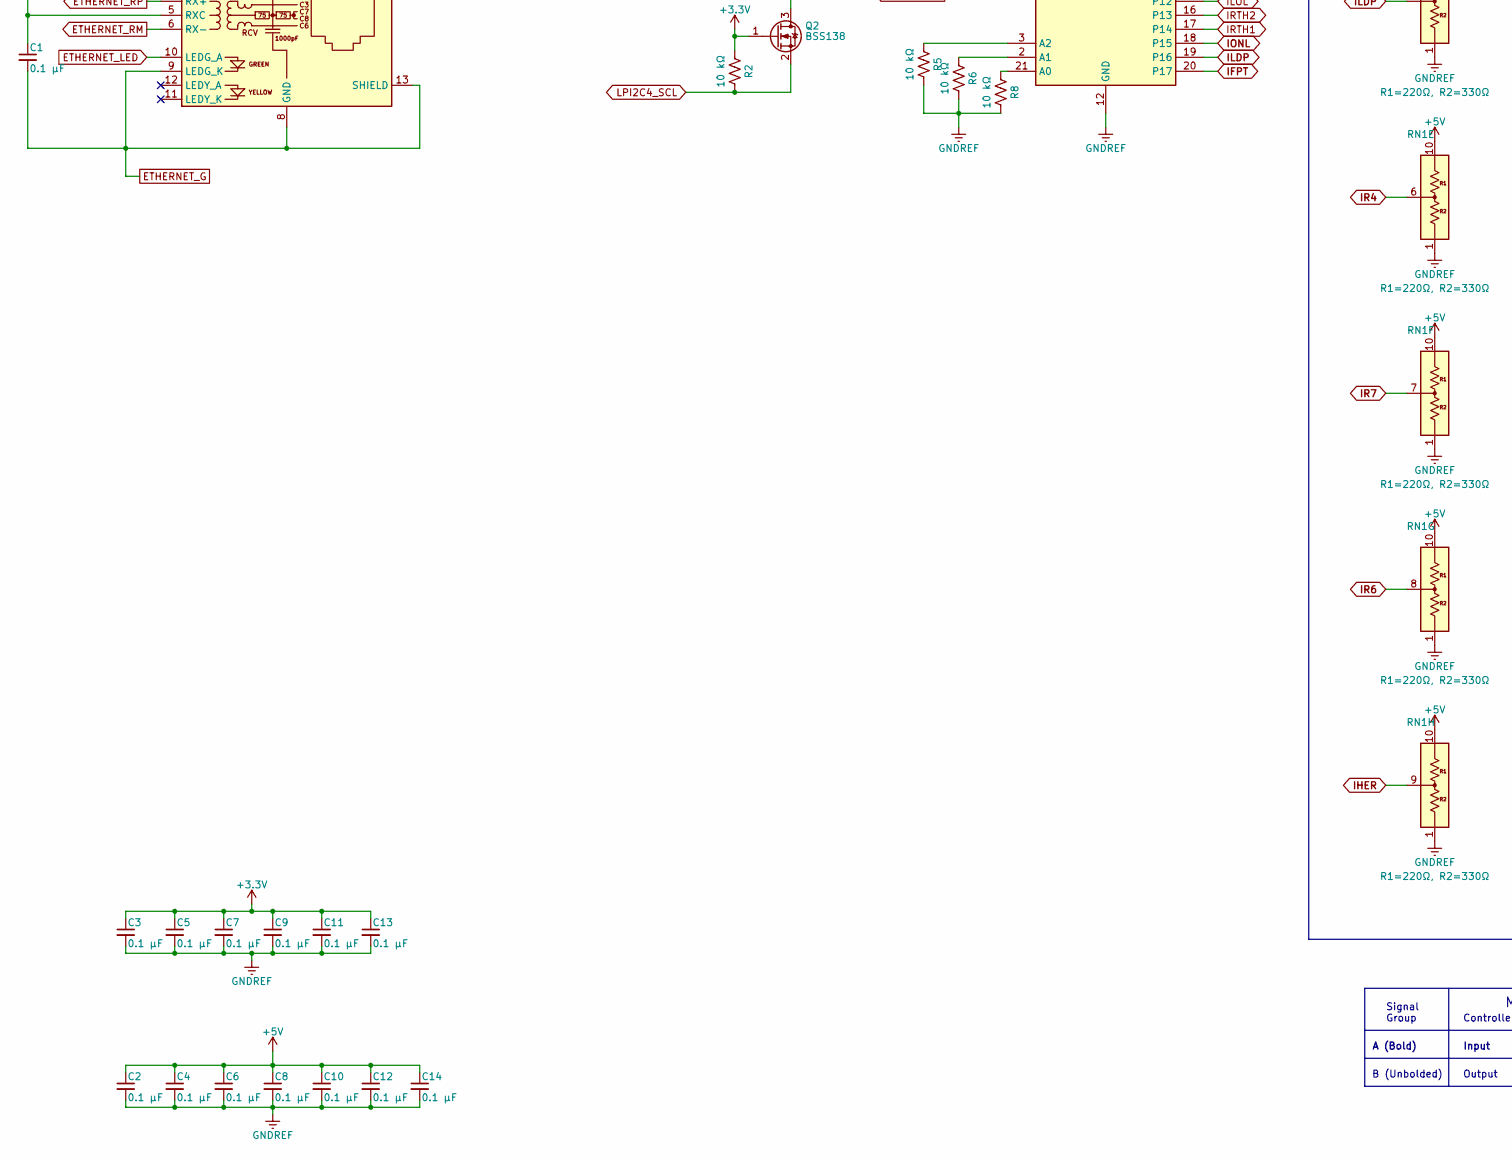
[picture p12: schematic pertec_arduino_adapter.kicad_sch, Pertexus: A Teensy 4.1 (Arduino) Pertex Interface (bdb004), part in row 2, column 1]

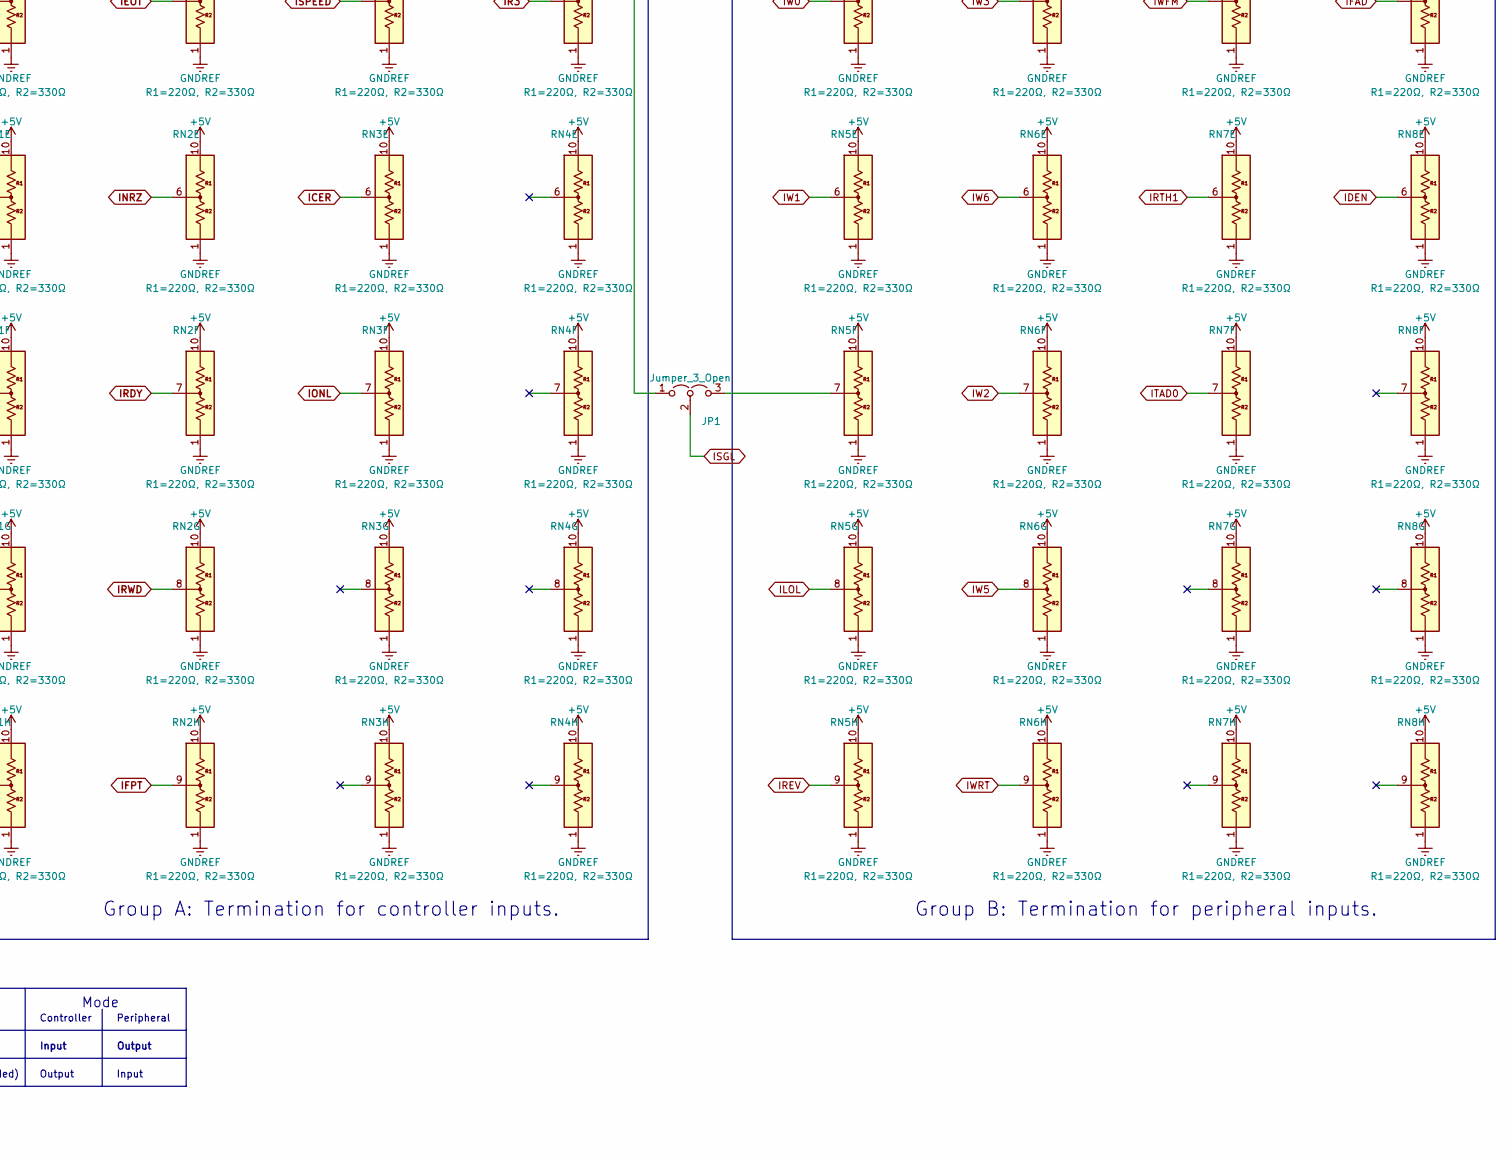
[picture p13: schematic pertec_arduino_adapter.kicad_sch, Pertexus: A Teensy 4.1 (Arduino) Pertex Interface (bdb004), part in row 2, column 2]

Parts:
BT1: CR2032; BatteryHolder_Keystone_1058_1x2032
C1: 0.1 μF; C_Rect_L4.0mm_W2.5mm_P2.50mm
C2, C3, C4, C5, C6, C7, C8, C9, C10, C11, C12, C13, C14: 0.1 μF; C_0805_2012Metric_Pad1.18x1.45mm_HandSolder
J1: Pertec J1; IDC-Header_2x25_P2.54mm_Latch_Vertical
J2: Pertec J2; IDC-Header_2x25_P2.54mm_Latch_Vertical
J3: Teensy Ethernet; PinSocket_2x03_P2.00mm_Vertical_Mirror_Teensy4.1_J3
J4: Teensy Right; PinSocket_1x24_P2.54mm_Vertical_Teensy4.1_J4
J5: Teensy Left; PinSocket_1x24_P2.54mm_Vertical_Teensy4.1_J5
J6: Teensy Cross; PinSocket_1x05_P2.54mm_Vertical_Teensy4.1_J6
J7: RJ45_Cetus_J1B1211CCD; RJ45_Cetus_J1B1211CCD_Horizontal
JP1: Jumper_3_Open; PinHeader_1x03_P2.54mm_Vertical
Q1, Q2: BSS138; SOT-23
R1, R2, R3, R4, R5, R6, R7, R8: 10 kΩ; R_0805_2012Metric_Pad1.20x1.40mm_HandSolder
RN1, RN2, RN3, RN4, RN5, RN6, RN7, RN8: R1=220Ω, R2=330Ω; R_Array_SIP10
U1, U2, U3, U4, U5, U6: SN74LVC8T245NSR; SO-24_5.3x15mm_P1.27mm
U7: PCA9535DBR; SOIC-24W_7.5x15.4mm_P1.27mm

Connections:
+3V3: C3.1, C5.1, C7.1, C9.1, C11.1, C13.1, J4.3, J5.15, J6.4, Q1.1 (G), Q2.1 (G), R1.1, R2.1, R7.1, U1.1 (VCCA), U2.1 (VCCA), U3.1 (VCCA), U4.1 (VCCA), U5.1 (VCCA), U6.1 (VCCA)
+5V: C2.1, C4.1, C6.1, C8.1, C10.1, C12.1, C14.1, J4.1, R3.1, R4.1, RN1.10, RN2.10, RN3.10, RN4.10, RN5.10, RN6.10, RN7.10, RN8.10, U1.23 (VCCB), U1.24 (VCCB), U2.23 (VCCB), U2.24 (VCCB), U3.23 (VCCB), U3.24 (VCCB), U4.23 (VCCB), U4.24 (VCCB), U5.23 (VCCB), U5.24 (VCCB), U6.23 (VCCB), U6.24 (VCCB), U7.24 (VCC)
DIRA: J5.5, U1.2 (DIR), U2.2 (DIR), U3.2 (DIR)
DIRB: J5.20, U4.2 (DIR), U5.2 (DIR), U6.2 (DIR)
ETHERNET_G: C1.2, J3.4, J7.8 (GND), J7.9 (LEDG_K), J7.13 (SHIELD)
ETHERNET_LED: J3.3, J7.10 (LEDG_A)
ETHERNET_RM: J3.6, J7.6 (RX-)
ETHERNET_RP: J3.5, J7.4 (RX+)
ETHERNET_TM: J3.1, J7.3 (TX-)
ETHERNET_TP: J3.2, J7.1 (TX+)
GNDREF: BT1.2 (-), C2.2, C3.2, C4.2, C5.2, C6.2, C7.2, C8.2, C9.2, C10.2, C11.2, C12.2, C13.2, C14.2, J1.1, J1.3, J1.5, J1.7, J1.9, J1.11, J1.13, J1.15, J1.17, J1.19, J1.21, J1.23, J1.25, J1.27, J1.29, J1.31, J1.33, J1.35, J1.37, J1.39, J1.41, J1.43, J1.45, J1.47, J1.49, J2.5, J2.7, J2.9, J2.11, J2.13, J2.15, J2.17, J2.19, J2.21, J2.23, J2.25, J2.27, J2.29, J2.31, J2.33, J2.35, J2.37, J2.39, J2.41, J2.43, J2.45, J2.47, J2.49, J4.2, J4.15, J5.1, J6.3, R5.2, R6.2, R8.2, RN1.1, RN2.1, RN3.1, RN4.1, RN5.1, RN6.1, RN7.1, RN8.1, U1.11 (GND), U1.12 (GND), U1.13 (GND), U2.11 (GND), U2.12 (GND), U2.13 (GND), U3.11 (GND), U3.12 (GND), U3.13 (GND), U4.11 (GND), U4.12 (GND), U4.13 (GND), U4.22 (~OE), U5.11 (GND), U5.12 (GND), U5.13 (GND), U5.22 (~OE), U6.11 (GND), U6.12 (GND), U6.13 (GND), U6.22 (~OE), U7.12 (GND)
ICER: J2.42, RN3.6, U3.21 (B1)
IDBY: J2.38, RN3.4, U2.14 (B8)
IDEN: J2.50, RN8.6, U7.13 (P10)
IDENT: J2.16, RN2.3, U7.4 (P00)
IEDIT: J1.38, RN7.3, U4.15 (B7)
IEOT: J2.22, RN2.5, U2.19 (B3)
IERASE: J1.40, RN7.4, U4.14 (B8)
IFAD: J2.48, RN8.5, U7.11 (P07)
IFBY: J1.2, RN4.3, U3.20 (B2)
IFEN: J2.18, RN8.2, U7.9 (P05)
IFMK: J2.14, RN2.2, U2.21 (B1)
IFPT: J2.32, RN2.9, U7.20 (P17)
IGO: J1.8, RN5.4, U6.19 (B3)
IHER: J2.12, RN1.9, U1.14 (B8)
ILDP: J2.4, RN1.5, U7.19 (P16)
ILOL: J1.16, RN5.8, U7.15 (P12)
ILWD: J1.4, RN5.2, U6.21 (B1)
INRZ: J2.26, RN2.6, U7.7 (P03)
IOFL: J2.24, RN8.3, U5.14 (B8)
IONL: J2.44, RN3.7, U7.18 (P15)
IR0: J2.2, RN1.3, U1.20 (B2)
IR1: J2.3, RN1.4, U1.19 (B3)
IR2: J1.48, RN4.4, U3.19 (B3)
IR3: J1.50, RN4.5, U3.18 (B4)
IR4: J2.6, RN1.6, U1.17 (B5)
IR5: J2.20, RN2.4, U2.20 (B2)
IR6: J2.10, RN1.8, U1.15 (B7)
IR7: J2.8, RN1.7, U1.16 (B6)
IRDY: J2.28, RN2.7, U2.18 (B4)
IREV: J1.18, RN5.9, U6.16 (B6)
IREW: J1.20, RN6.2, U6.15 (B7)
IRP: J2.1, RN1.2, U1.21 (B1)
IRSTR: J2.34, RN3.2, U2.16 (B6)
IRTH1: J1.44, RN7.6, U7.17 (P14)
IRTH2: J1.36, RN7.2, U7.16 (P13)
IRWD: J2.30, RN2.8, U7.5 (P01)
ISGL: J1.14, JP1.2 (C), U7.14 (P11)
ISPEED: J2.40, RN3.5, U7.6 (P02)
ITAD0: J1.46, RN7.7, U7.8 (P04)
ITAD1: J2.46, RN8.4, U7.10 (P06)
IW0: J1.10, RN5.5, U6.18 (B4)
IW1: J1.12, RN5.6, U6.17 (B5)
IW2: J1.30, RN6.7, U4.18 (B4)
IW3: J1.26, RN6.5, U4.20 (B2)
IW4: J1.6, RN5.3, U6.20 (B2)
IW5: J1.32, RN6.8, U4.17 (B5)
IW6: J1.28, RN6.6, U4.19 (B3)
IW7: J1.24, RN6.4, U4.21 (B1)
IWFM: J1.42, RN7.5, U5.15 (B7)
IWP: J1.22, RN6.3, U6.14 (B8)
IWRT: J1.34, RN6.9, U4.16 (B6)
IWSTR: J2.36, RN3.3, U2.15 (B7)
LPI2C4_SCL: J5.16, Q2.2 (S), R2.2
LPI2C4_SDA: J5.17, Q1.2 (S), R1.2
LVICER: J4.23, U3.3 (A1)
LVIDBY: J5.6, U2.10 (A8)
LVIEDIT: J5.13, U4.9 (A7)
LVIEOT: J5.23, U2.5 (A3)
LVIERASE: J5.14, U4.10 (A8)
LVIFBY: J4.24, U3.4 (A2)
LVIFMK: J5.2, U2.3 (A1)
LVIGO: J5.8, U6.5 (A3)
LVIHER: J4.22, U1.10 (A8)
LVILWD: J4.14, U6.3 (A1)
LVIOFL: J5.22, U5.10 (A8)
LVIR0: J4.11, U1.4 (A2)
LVIR1: J4.10, U1.5 (A3)
LVIR2: J4.16, U3.5 (A3)
LVIR3: J4.17, U3.6 (A4)
LVIR4: J4.12, U1.7 (A5)
LVIR5: J4.13, U2.4 (A2)
LVIR6: J4.9, U1.9 (A7)
LVIR7: J4.8, U1.8 (A6)
LVIRDY: J5.4, U2.6 (A4)
LVIREV: J5.11, U6.8 (A6)
LVIREW: J5.10, U6.9 (A7)
LVIRP: J5.3, U1.3 (A1)
LVIRSTR: J4.21, U2.8 (A6)
LVIW0: J5.19, U6.6 (A4)
LVIW1: J5.18, U6.7 (A5)
LVIW2: J4.18, U4.6 (A4)
LVIW3: J4.19, U4.4 (A2)
LVIW4: J4.6, U6.4 (A2)
LVIW5: J4.7, U4.7 (A5)
LVIW6: J4.4, U4.5 (A3)
LVIW7: J4.5, U4.3 (A1)
LVIWFM: J5.24, U5.9 (A7)
LVIWP: J5.9, U6.10 (A8)
LVIWRT: J5.12, U4.8 (A6)
LVIWSTR: J4.20, U2.9 (A7)
unnamed: BT1.1 (+), J6.5
unnamed: C1.1, J7.2 (TXC), J7.5 (RXC)
unnamed: JP1.1 (A), RN4.2
unnamed: JP1.3 (B), RN5.7
unnamed: Q1.3 (D), R3.2, U7.23 (SDA)
unnamed: Q2.3 (D), R4.2, U7.22 (SCL)
unnamed: R5.1, U7.3 (A2)
unnamed: R6.1, U7.2 (A1)
unnamed: R8.1, U7.21 (A0)
OEA: J5.21, U1.22 (~OE), U2.22 (~OE), U3.22 (~OE)
~LPI2C4_INT: J5.7, R7.2, U7.1 (~INT)

Notes on the sheet:
A (Bold)
GPIO_EMC_32
Controller
GPIO_B1_00
3.3V
GPIO_AD_B0_02
GPIO_B0_02
GPIO_AD_B1_13
GPIO_AD_B1_07
GPIO_AD_B0_13
GPIO_EMC_07
Input
GPIO_B1_12
Signal Group
GPIO_B0_11
Mode
GPIO_EMC_04
GPIO_AD_B1_10
Output
GPIO_AD_B1_03
PROGRAM
GPIO_AD_B0_12
Group B: Termination for peripheral inputs.
GPIO_B0_01
GPIO_B0_12
ON/OFF
Peripheral
GPIO_B0_00
GPIO_B1_03
GPIO_EMC_36
GPIO_AD_B1_15
GPIO_AD_B1_02
B (Unbolded)
GPIO_AD_B1_01
Group A: Termination for controller inputs.
GPIO_EMC_05
GPIO_EMC_06
GPIO_EMC_37
GPIO_AD_B0_03
GPIO_AD_B1_06
GPIO_AD_B1_08
GPIO_AD_B1_11
GPIO_B0_10
GPIO_AD_B1_09
GPIO_AD_B1_00
GPIO_AD_B1_05
GPIO_EMC_08
GPIO_B1_01
GPIO_EMC_31
GPIO_AD_B1_14
GPIO_AD_B1_04
GPIO_B0_03
GPIO_B1_02
GPIO_B1_13
GPIO_AD_B1_12

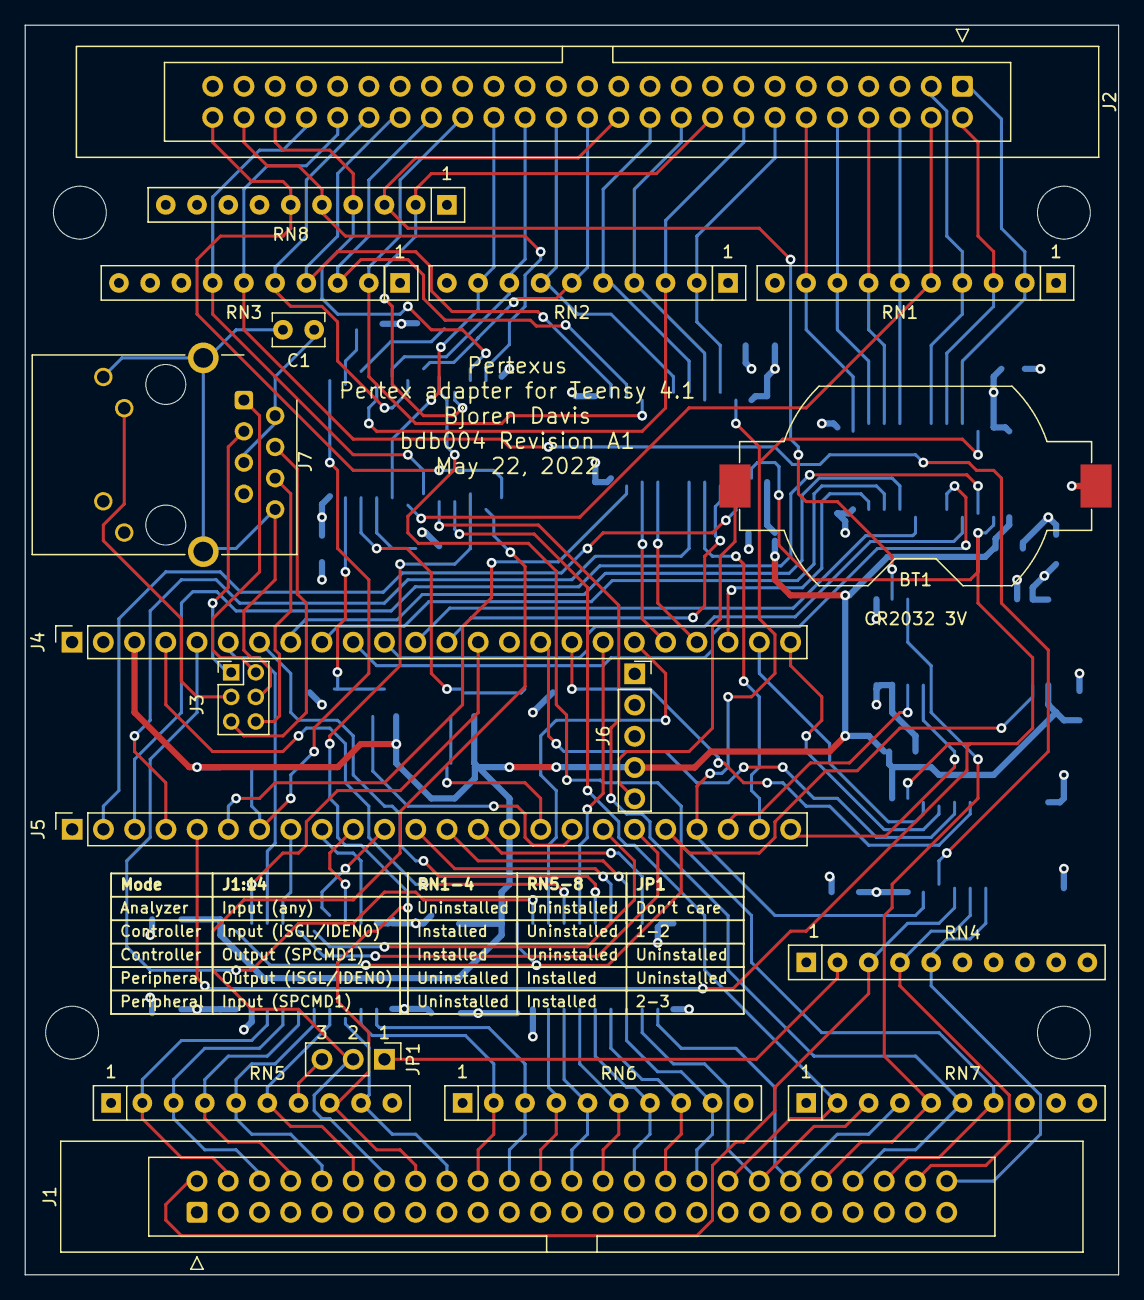
[picture p14: board board/pertec_arduino_adapter.kicad_pcb from above]

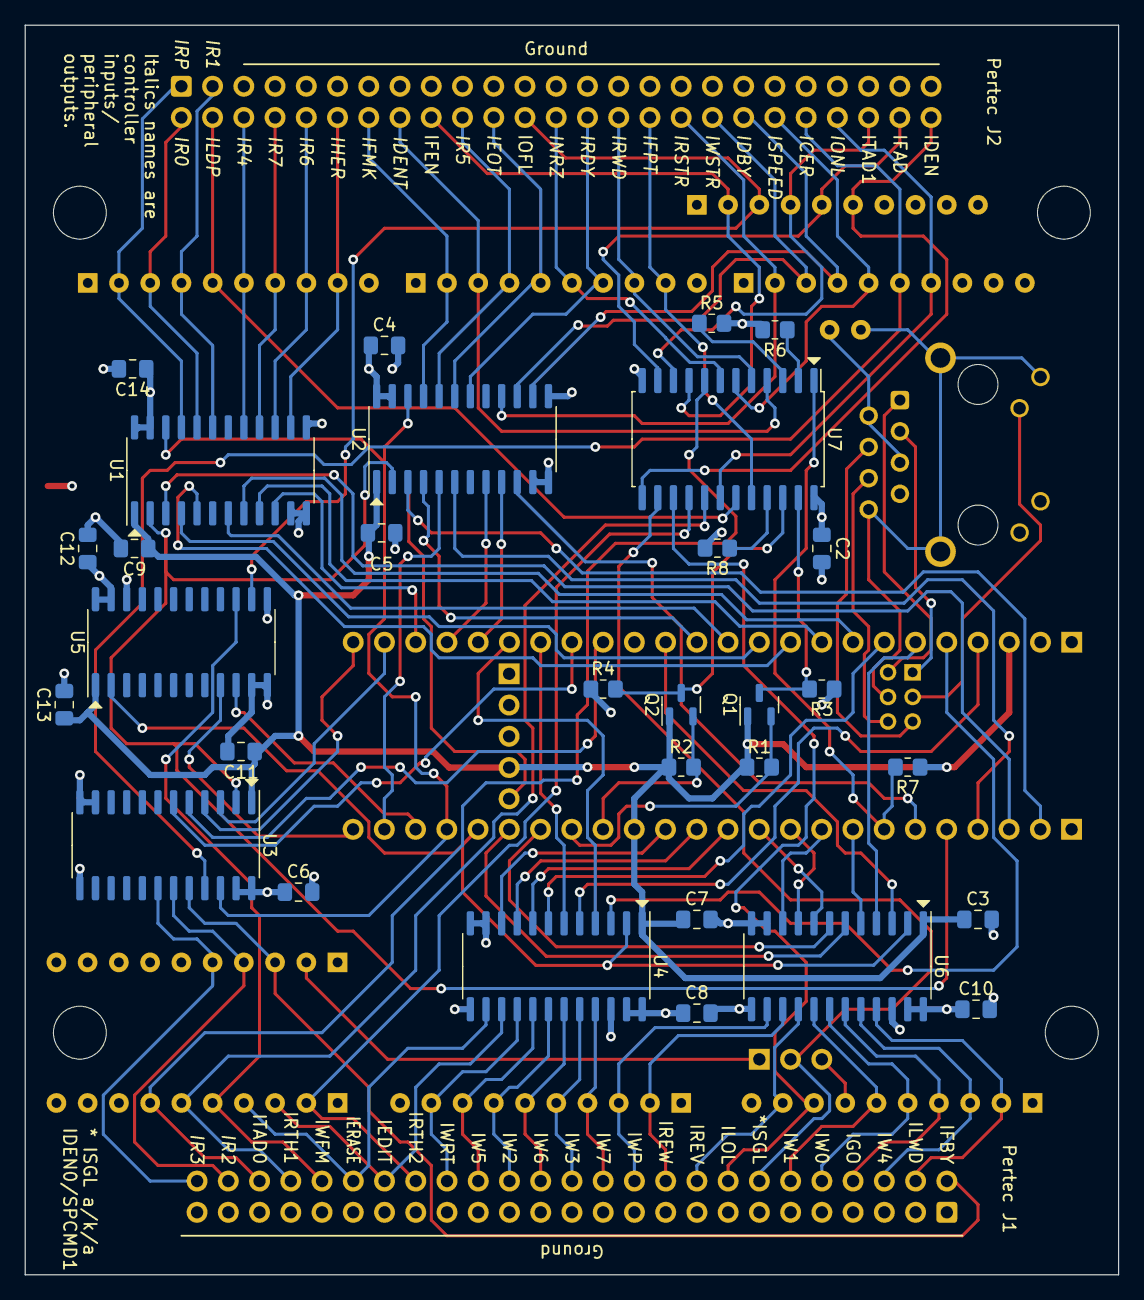
[picture p15: board board/pertec_arduino_adapter.kicad_pcb from below]

Board: 4 copper layers, 88.9 x 101.6 mm, 48 parts (30 on the bottom side), 112 nets.
