bjorend/pertexus/pertexusfw/Time.cpp

/*
  time.c - low level time and date functions
  Copyright (c) Michael Margolis 2009-2014

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
  1.0  6  Jan 2010 - initial release
  1.1  12 Feb 2010 - fixed leap year calculation error
  1.2  1  Nov 2010 - fixed setTime bug (thanks to Korman for this)
  1.3  24 Mar 2012 - many edits by Paul Stoffregen: fixed timeStatus() to update
                     status, updated examples for Arduino 1.0, fixed ARM
                     compatibility issues, added TimeArduinoDue and TimeTeensy3
                     examples, add error checking and messages to RTC examples,
                     add examples to DS1307RTC library.
  1.4  5  Sep 2014 - compatibility with Arduino 1.5.7

*/

/*
 * Bjoren Davis, June 7, 2022.
 * I copied this from c:\Program Files (x86)\Arduino\hardware\teensy\avr\cores\teensy4\Time.cpp,
 *  part of Teensyduino 1.56.
 * It had a small bug in makeTime() where it would create an incorrect value
 *  for dates after February 28 if one of {year, year + 70} was
 *  a leap year and the other was not.
 */

#include <Arduino.h>


// TODO: replace this slow Time library code with faster 32 bit approach


// leap year calculator expects year argument as years offset from 1970
#define LEAP_YEAR(Y)     ( ((1970+(Y))>0) && !((1970+(Y))%4) && ( ((1970+(Y))%100) || !((1970+(Y))%400) ) )
static const uint8_t monthDays[]={31,28,31,30,31,30,31,31,30,31,30,31};
#define SECS_PER_MIN  60
#define SECS_PER_HOUR 3600
#define SECS_PER_DAY  86400


void breakTime(uint32_t time, DateTimeFields &tm)
{
// break the given time_t into time components
// this is a more compact version of the C library localtime function
// note that year is offset from 1970 !!!

  uint8_t year;
  uint8_t month, monthLength;
  unsigned long days;

  tm.sec = time % 60;
  time /= 60; // now it is minutes
  tm.min = time % 60;
  time /= 60; // now it is hours
  tm.hour = time % 24;
  time /= 24; // now it is days
  tm.wday = ((time + 4) % 7);  // Sunday is day 0

  year = 0;
  days = 0;
  while((unsigned)(days += (LEAP_YEAR(year) ? 366 : 365)) <= time) {
    year++;
  }
  tm.year = year + 70; // year is offset from 1970

  days -= LEAP_YEAR(year) ? 366 : 365;
  time  -= days; // now it is days in this year, starting at 0

  days=0;
  month=0;
  monthLength=0;
  for (month=0; month<12; month++) {
    if (month==1) { // february
      if (LEAP_YEAR(year)) {
        monthLength=29;
      } else {
        monthLength=28;
      }
    } else {
      monthLength = monthDays[month];
    }

    if (time >= monthLength) {
      time -= monthLength;
    } else {
        break;
    }
  }
  tm.mon = month;  // jan is month 0
  tm.mday = time + 1;     // day of month
}

uint32_t makeTime(const DateTimeFields &tm)
{
// assemble time elements into time_t
// note year argument is offset from 1970 (see macros in time.h to convert to other formats)
// previous version used full four digit year (or digits since 2000),i.e. 2009 was 2009 or 9

  int i;
  uint32_t seconds;

  // seconds from 1970 till 1 jan 00:00:00 of the given year
  seconds = (tm.year - 70) * (SECS_PER_DAY * 365);
  for (i = 70; i < tm.year; i++) {
    if (LEAP_YEAR(i - 70)) {
      seconds += SECS_PER_DAY;   // add extra days for leap years
    }
  }

  // add days for this year, months start from 1
  for (i = 0; i < tm.mon; i++) {
    if ( (i == 1) && LEAP_YEAR(tm.year - 70)) { /* bkd 7-June-2022 */
      seconds += SECS_PER_DAY * 29;
    } else {
      seconds += SECS_PER_DAY * monthDays[i];
    }
  }
  seconds += (tm.mday-1) * SECS_PER_DAY;
  seconds += tm.hour * SECS_PER_HOUR;
  seconds += tm.min * SECS_PER_MIN;
  seconds += tm.sec;
  return (time_t)seconds;
}
