bjorend/pertexus/(commit log)

2022-04-21 Unfinished version of 5V adapter for Arduino Mega 2560 R3 using KiCad 5.1.10. I'm planning on abondoning this because the Arduino Mega 2560 R3 simply isn't fast enough.
    [pertec_arduino_adapter.kicad_pcb, pertec_arduino_adapter.sch]
2022-05-05 Development checkpoint: started work on design for Adafruit Metro M4 Grand Central. I'm aborting that development path and switching to the Teensy 4.1 because it's far faster and actually available.
    [pertec_arduino_adapter.kicad_pcb, pertec_arduino_adapter.kicad_sch, pertec_arduino_adapter.sch]
2022-05-19 Development checkpoint: schematic complete, passes ERC, started layout.
    [pertec_arduino_adapter.kicad_pcb, pertec_arduino_adapter.kicad_sch]
2022-05-19 Initial copy of spreadsheet with pins.
    [teensy4_1_pin_assignments.xlsx]
2022-05-20 Development checkpoint: added switchable controller/peripheral functionality.
    [pertec_arduino_adapter.kicad_pcb, pertec_arduino_adapter.kicad_sch, teensy4_1_pin_assignments.xlsx]
2022-05-20 Added switchable controller/peripheral mode
    [teensy4_1_pin_assignments.xlsx]
2022-05-20 Development checkpoint: ready to start layout
    [pertec_arduino_adapter.kicad_pcb, pertec_arduino_adapter.kicad_sch, teensy4_1_pin_assignments.xlsx]
2022-05-21 Development checkpoint: fully routed. Still 6 layers, but I'll chop that down right before tapeout.
    [pertec_arduino_adapter.kicad_pcb, pertec_arduino_adapter.kicad_sch]
2022-05-21 Development checkpoint: layout and routing completed; passes DRC
    [pertec_arduino_adapter.kicad_pcb, pertec_arduino_adapter.kicad_sch]
2022-05-22 Revision A for tapeout.
    [pertec_arduino_adapter-B_Cu.gbr, pertec_arduino_adapter-B_Mask.gbr, pertec_arduino_adapter-B_Paste.gbr, pertec_arduino_adapter-B_Silkscreen.gbr, pertec_arduino_adapter-Edge_Cuts.gbr, pertec_arduino_adapter-F_Cu.gbr, pertec_arduino_adapter-F_Mask.gbr, pertec_arduino_adapter-F_Paste.gbr]
2022-05-22 Cleaned up a stray bit of silkscreen art off of the board. This is still revision A.
    [pertec_arduino_adapter-B_Cu.gbr, pertec_arduino_adapter-B_Mask.gbr, pertec_arduino_adapter-B_Paste.gbr, pertec_arduino_adapter-B_Silkscreen.gbr, pertec_arduino_adapter-Edge_Cuts.gbr, pertec_arduino_adapter-F_Cu.gbr, pertec_arduino_adapter-F_Mask.gbr, pertec_arduino_adapter-F_Paste.gbr]
2022-05-22 Revision A, attempt #2
    [pertec_arduino_adapter-B_Cu.gbr, pertec_arduino_adapter-B_Mask.gbr, pertec_arduino_adapter-B_Paste.gbr, pertec_arduino_adapter-B_Silkscreen.gbr, pertec_arduino_adapter-Edge_Cuts.gbr, pertec_arduino_adapter-F_Cu.gbr, pertec_arduino_adapter-F_Mask.gbr, pertec_arduino_adapter-F_Paste.gbr]
2022-05-22 Development checkpoint: revision A1 (added holes for feet)
    [pertec_arduino_adapter.kicad_pcb]
2022-05-22 Ready to tape out Revision A1
    [pertec_arduino_adapter-B_Cu.gbr, pertec_arduino_adapter-B_Mask.gbr, pertec_arduino_adapter-B_Paste.gbr, pertec_arduino_adapter-B_Silkscreen.gbr, pertec_arduino_adapter-Edge_Cuts.gbr, pertec_arduino_adapter-F_Cu.gbr, pertec_arduino_adapter-F_Mask.gbr, pertec_arduino_adapter-F_Paste.gbr]
2022-06-10 Corrected names of OEA and DIRA/DIRB signals
    [teensy4_1_pin_assignments.xlsx]
2022-06-10 + increased tape data buffer from 4096 to 32768 bytes + added EOT detection for cmd_read() + expanded 'read' command to allow '-eot' and '-nfiles' + added 'erase' command + fixed 'testwrite' command 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
    [pertexusfw.ino]
2022-06-11 + reworked GPIO interrupt setup mechanism + added 'peek' and 'poke' commands + moved all PCA9535 initialization code into separate function + added initialization of LPI2C4_INT (port expander interru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
    [pertexusfw.ino]
2022-06-13 + added code to assert/deassert IFEN line for each command in an attempt to mitigate anomolous behavior when power is lost. Another goal is to allow the pertexus to be connected to multiple periphera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
2022-11-30 Fixed some bugs in the 'help' command.
    [cmdif.cpp]
2022-11-30 Bugfix: 'sd read' command was not working correctly with n*2+1-length records (it needed to skip a byte at the end of such a record to keep header alignment)
    [pertexusfw.ino]
2022-12-01 Bugfix: tmpfn_gen() would only look for TEMP0000.TMP. If that file already existed it would loop forever.
    [pertexusfw.ino]
